dumaiss/uBITz/README.md

# uBITz
**μBITz** – *ZAP 80s dreams into silicon.*   

Open modular 8-bit style system: host Z80/6502/68k/RISC-V, tile SID/POKEY, boot in '83.   M.2 LVDS serial, I²C map, Parity-10, ZAP IRQs.   Spec + KiCad + Verilog + ref impl.   Build. ZAP. Retro lives.   `ubitz.dev` #μBITz
