dumaiss/uBITz/Engineering Diaries/μBITz Dock Digital Architecture - Done.md

# μBITz Dock Digital Architecture — Definition of Done Report

**Date:** 2024-11-27  
**Phase:** Architecture Review & Documentation (Pre-Schematic)  
**Status:** ✅ **COMPLETE — Ready for Schematic Capture**

---

## 1. Acceptance Criteria

### 1.1 Critical Issues Resolved

|Issue|Initial State|Final State|Status|
|---|---|---|---|
|**CPLD Resource Overflow**|Document specified LCMXO2-1200HC (1280 LUTs), but synthesis required 2337 LUTs (183% over)|Updated to LCMXO2-4000HC-4TG144C throughout document and BOM; utilization now 54% with comfortable margin|✅ **RESOLVED**|
|**GPIO Budget Crisis**|Initial calculation: 48-56 GPIOs needed vs 40 available on ESP32-S3 (shortfall of 8-16 pins)|Added MCP23017 GPIO expander for slow CPLD config buses; direct GPIOs reduced to ~29; budget now closes with margin|✅ **RESOLVED**|
|**USB Hub Architecture Undefined**|Section 9 was vague placeholder; unclear if hub was on Dock, GPIO requirements unknown|Full USB hub architecture documented in Section 7 (ESP32-S3 USB OTG host → GL850G 4-port hub → front panel HID)|✅ **RESOLVED**|

### 1.2 Documentation Completeness

|Section|Required Content|Delivered|Status|
|---|---|---|---|
|**4.2 CPLD**|Correct part number, synthesis utilization data|LCMXO2-4000HC specified; 2337 LUTs / 82 IOs documented|✅ **COMPLETE**|
|**4.5 GPIO Expander**|Architecture, part selection, role in config buses|MCP23017 I²C expander documented; parallel config via expander explained|✅ **COMPLETE**|
|**4.1.4 GPIO Budget**|Strategy for direct vs expander GPIOs, allocation table|Direct/expander split documented; budget analysis shows 29 direct + 13 via expander = fits|✅ **COMPLETE**|
|**Section 7 USB Hub**|Full architecture: power, enumeration, HID translation, Slot 0 integration|Complete specification with system diagram, BOM, firmware responsibilities, design checklist|✅ **COMPLETE**|
|**13.x BOM**|All subsystems with parts, quantities, notes|CPLD (§13.5), GPIO expander (§13.9), USB hub (§13.6), I²C fabric (§13.4) all updated|✅ **COMPLETE**|
|**GPIO Pin Assignments**|Provisional mapping for schematic capture|`esp32s3_gpio_assignments.md` delivered with TBD placeholders, allows routing flexibility|✅ **COMPLETE**|

### 1.3 Internal Consistency Validation

|Check|Result|Status|
|---|---|---|
|CPLD part number consistent across §4.2, §13.5, and all references|LCMXO2-4000HC-4TG144C everywhere|✅ **PASS**|
|GPIO count in §4.1.4 matches assignments in `esp32s3_gpio_assignments.md`|Direct GPIOs: 29 (Slot 0: 18, I²C: 2, UART: 4, power: 3, debug: 2); Expander: 13 bits|✅ **PASS**|
|USB hub BOM (§13.6) matches Section 7 architecture|GL850G, TVS diodes, PPTC fuse, connectors all present|✅ **PASS**|
|RTC part standardized throughout|RV-8523-C3 specified in §7.3 and §13.4|✅ **PASS**|
|No contradictions between architecture decisions and diary constraints|All 2025-11-26/27 diary decisions reflected correctly|✅ **PASS**|

---

## 2. Schematic Capture Readiness

### 2.1 Component Selection — Final Parts List

|Subsystem|Part Number|Package|Qty|Verified|
|---|---|---|---|---|
|Dock MCU|ESP32-S3-WROOM-1-N16R8|Module|1|✅|
|CPLD|LCMXO2-4000HC-4TG144C|TQFP-144|1|✅|
|GPIO Expander|MCP23017-E/SP|PDIP-28 / SOIC-28|1|✅|
|I²C Switch|TCA9548A|TSSOP-24 / VQFN-24|1|✅|
|RTC|RV-8523-C3|SOT-23-5|1|✅|
|USB Hub|GL850G / FE1.1s|SSOP-28|1|✅|
|USB-UART|FT232RL|SSOP-28|1|✅|

### 2.2 Signal Groups Defined

|Signal Group|Source|Destination|Pin Count|Routing Priority|Defined|
|---|---|---|---|---|---|
|Slot 0 Tile (data/addr/control)|ESP32-S3 direct|CPLD|18|**CRITICAL** (timing-sensitive)|✅|
|CPLD Config Bus|MCP23017|CPLD|13|Low (boot-time only)|✅|
|I²C Master|ESP32-S3|TCA9548A|2|Medium|✅|
|Service UART|ESP32-S3|FT232R|4 (TX/RX/RTS/CTS)|Medium (flow control)|✅|
|USB Host|ESP32-S3 GPIO19/20|GL850G|2 (D+/D−)|**CRITICAL** (90Ω diff pair)|✅|
|Power Control|ESP32-S3|Power sheet|3 (MAIN_ON_REQ, PG_5V, PG_3V3)|Low|✅|
|I²C Branches|TCA9548A|Host/Bank/Tiles|2×7 channels|Low|✅|

### 2.3 Design Constraints Documented

|Constraint Type|Specification|Documented|Verifiable in Schematic|
|---|---|---|---|
|**USB Differential Impedance**|90Ω ±10%, length match ±5 mils|§7.7.2 Layout Constraints|✅ (DRC rules)|
|**CPLD Power Decoupling**|0.1 µF per VCC pin, bulk caps per rail|§13.5 BOM notes|✅ (cap placement)|
|**I²C Pull-ups**|4.7 kΩ on MCU-side SCL/SDA|§13.4 I²C fabric|✅ (resistor nets)|
|**GPIO Expander Power Domain**|3V3_AON (clarified in review)|§4.5|✅ (net connection)|
|**Config Bus Timing**|MCU-controlled, no hard constraints (system in reset until ready)|§4.5 notes|✅ (no special routing)|

---

## 3. Open Items & Deferrals (Non-Blocking)

### 3.1 Intentionally Deferred to Implementation Phase

|Item|Reason for Deferral|Target Phase|
|---|---|---|
|**Exact ESP32-S3 GPIO pin numbers**|Allow KiCad routing flexibility; provisional `TBD_xx` assignments provided|PCB layout|
|**MCP23017 port bit mapping**|Can be changed in firmware if all 16 bits routed; provisional table exists|Firmware development|
|**I²C device addresses**|Designer controls all Dock-local addresses; conflicts avoided during implementation|Schematic capture|
|**BOM cost estimates**|Not architecture concern; separate pricing doc if needed|Procurement (optional)|
|**CPLD in-system I²C programming**|Wiring provided (sysCONFIG on CH0), firmware TBD|Post-prototype|
|**Bring-up test plan**|Cannot specify until hardware exists|First board bring-up|
|**Fault handling details**|Monitor protocol and error recovery deferred to firmware spec|Firmware development|

### 3.2 Known Limitations (Accepted Trade-offs)

|Limitation|Impact|Mitigation|
|---|---|---|
|**No per-port USB power control**|Cannot disable individual faulty USB ports|Shared PPTC fuse trips entire hub; HUB_RESET# forces re-enumeration|
|**Config is write-only**|Cannot readback CPLD config for verification|MCU maintains shadow copy; debug via JTAG if needed|
|**GPIO expander adds latency**|Config writes ~300-500 µs per register vs instant parallel|Boot-time only; 10 ms total acceptable|
|**Tight GPIO budget**|Only 3 spare direct GPIOs after allocations|Sufficient for v1.0; future revisions can add second expander if needed|

---

## 4. Handoff Deliverables

### 4.1 Documents Provided

|Document|Filename|Purpose|Status|
|---|---|---|---|
|**Digital Architecture**|`μbitz_dock_digital_system_architecture_2025_11_27-2.md`|Normative reference for schematic capture|✅ **FINAL**|
|**GPIO Assignments**|`esp32s3_gpio_assignments.md`|Provisional pin mapping template|✅ **PROVISIONAL**|
|**Change Report**|(in handoff context)|Summary of what changed and why|✅ **COMPLETE**|

### 4.2 Cross-References Established

|External Document|Section(s)|Relationship|Status|
|---|---|---|---|
|**DECODER_CONFIGURATION.md**|§4.5, §6|Defines config register map and MCU programming model|✅ Referenced|
|**Power Architecture**|§14.1, power rails|Defines +3V3_AON, +3V3_MAIN, +5V_MAIN, sequencing|✅ Referenced|
|**Engineering Diaries (2025-11-26/27)**|Throughout|Source of normative design decisions|✅ Validated|
|**Core Logical Specification**|§3, §5|Defines Slot 0 Tile interface, /READY, interrupts|✅ Compliant|

---

## 5. Design Review Sign-Off

### 5.1 Critical Issues — All Resolved ✅

- [x] CPLD resource overflow fixed (1200HC → 4000HC)
- [x] GPIO budget crisis resolved (GPIO expander solution)
- [x] USB hub architecture fully specified (Section 7)
- [x] Component selections finalized and consistent
- [x] BOM updated with all subsystems

### 5.2 Architecture Quality Gates — All Passed ✅

- [x] Internal consistency validated (part numbers, GPIO counts, signal groups)
- [x] Compliance with platform specifications (Core, Dock, Tile Base)
- [x] Alignment with engineering diary decisions (all 2025-11-26/27 constraints)
- [x] Schematic capture readiness (parts, signals, constraints defined)
- [x] No contradictions or ambiguities in normative sections

### 5.3 Pragmatic Engineering Checks — All Satisfied ✅

- [x] No over-engineering (features match requirements, no gold-plating)
- [x] No RTL changes required (GPIO expander preserves existing HDL)
- [x] Flexibility preserved (provisional GPIO assignments, I²C addresses TBD)
- [x] Cost-conscious (standard parts, hand-solderable packages)
- [x] Risk mitigation (CPLD headroom, GPIO margin, power sequencing simplicity)

---

## 6. Final Status

### **DEFINITION OF DONE: ✅ ACHIEVED**

**The μBITz Dock Digital System Architecture is:**

✅ **Technically complete** — All critical decisions documented, no blocking unknowns  
✅ **Internally consistent** — Parts, signals, constraints align across all sections  
✅ **Specification-compliant** — Meets Core/Dock/Tile requirements and diary constraints  
✅ **Schematic-ready** — Sufficient detail to begin KiCad hierarchical sheet capture  
✅ **Pragmatically scoped** — Defers non-critical details to appropriate phases

**Next Phase:** KiCad Schematic Capture → PCB Layout → Fabrication → Bring-Up

---

## 7. Handoff Checklist for Schematic Capture

When starting KiCad work, you have:

- [x] Complete hierarchical sheet interface definition (§14)
- [x] All major IC part numbers and packages
- [x] Signal group definitions with pin counts and priorities
- [x] Routing constraints (USB diff pair, decoupling, I²C pull-ups)
- [x] Power domain assignments (3V3_AON vs 3V3_MAIN)
- [x] Provisional GPIO assignments (refine during layout)
- [x] BOM structure with suggested parts
- [x] Cross-references to config protocol and power architecture

**You can begin drawing schematics immediately.** Any refinements (exact GPIO numbers, I²C addresses, connector choices) can be made during schematic capture and layout without invalidating the architecture.

---

**Prepared by:** Claude (AI Design Reviewer)  
**Reviewed by:** User (μBITz Platform Designer)  
**Approved for:** Schematic Capture Phase  
**Date:** 2024-11-27

---

## 8. Lessons Learned (For Future Design Reviews)

**What worked well:**

- Catching CPLD resource overflow early (before PCB fab)
- GPIO expander solution preserved existing HDL (pragmatic)
- Deferring non-critical details (pin numbers, addresses) to implementation
- User's philosophy: "document behavior, not cost" kept spec focused

**What to remember:**

- This user controls implementation details (I²C addresses, timing budgets) → don't over-specify
- "Reset is my friend" → complex sequencing not needed if MCU holds system in reset until ready
- Provisional assignments with flexibility > premature lock-in
- Write-only config is fine; don't invent features not actually needed

---

**END OF DEFINITION OF DONE REPORT**
