dumaiss/uBITz/Engineering Diaries/μBITz Power Architecture - Done.md

---

## ✅ **Definition of Done Check**

> I will consider this handoff complete when ChatGPT:

### **1. Updates the power spec document with the corrected STUSB4500 placement (upstream of master switch) and explains the trade-off (1mA standby vs. functional PD negotiation).**

**Status:** ✅ **DONE**

- Section 3.1 explicitly states: _"In the reference implementation, the PD sink IC is placed **upstream of the master switch** and is powered directly from VBUS/CC according to its datasheet (dead-battery mode)."_
- Explains the trade-off: _"This means that when a USB-C cable is plugged in but the master switch is OFF, the PD sink may draw a very small quiescent current (≪ 1 mA) to maintain CC terminations and negotiate."_
- Clarifies that all Dock rails downstream remain unpowered

---

### **2. Adds a concrete power budget section with estimated currents for Host/Bank/Tiles and a recommended PD PDO (e.g., 15V/3A or 20V/3A).**

**Status:** ✅ **DONE**

- **Section 2.4** added with:
    - Illustrative load table (Host, Bank, 4× Tiles, Dock logic)
    - Total estimated load: ~2.0A @ 5V, ~1.4A @ 3.3V → ~20-25W
    - **Recommended PD profile:** 15V @ 3A (45W)
    - **Acceptable alternate:** 20V @ 3A
    - Explicitly marked as "illustrative" with note to refine after real boards exist

---

### **3. Provides the protection coordination table so builders know exactly how rail-level and per-slot fuses interact.**

**Status:** ✅ **DONE**

- **Section 6.5** added with:
    - Design rule: `I_rail_nominal ≥ N_slots × I_slot_hold`
    - Example table showing:
        - 5V rail: STEF05 @ 5A nominal vs. per-slot PPTC @ 1.1A hold
        - 3.3V rail: STEF033 @ 3A nominal vs. per-slot PPTC @ 0.75A hold
    - Verification: 4 slots × 1.1A = 4.4A < 5A rail limit ✓
    - Clearly marked as "examples only"

---

### **4. Includes a timing diagram for the power-up sequence (doesn't need to be graphical—text-based with millisecond timestamps is fine).**

**Status:** ✅ **DONE**

- **Section 9.6** added with text-based timeline:
    
    ```
    t = 0 ms    : Master switch ON, PD negotiation startst ≈ 2-5 ms  : PD contract established, AON startst ≈ 5-10 ms : 3V3_AON crosses supervisor threshold...t ≈ 50-60 ms: SYS_RESET# released → system ON
    ```
    
- Emphasizes **ordering** constraints over exact millisecond values

---

### **5. Adds the fault response table showing how each protection mechanism is detected and handled by the MCU.**

**Status:** ✅ **DONE**

- **Section 6.6** added with table mapping:
    - Fault condition (PD over-voltage, 5V/3.3V rail OC, per-slot PPTC trip, brown-out)
    - Detector/source (PD sink flags, eFuse FAULT#, thermal, regulator PG/ADC)
    - Recommended MCU behaviour (log, drop MAIN_ON_REQ, retry with backoff, etc.)

---

### **6. Specifies an inrush limiting approach (TPS2121 soft-start config or NTC part number) to prevent PD charger over-current trips.**

**Status:** ✅ **DONE**

- **Section 6.7** added covering:
    - Place bulk caps **behind** PD sink's controlled FET
    - Use STUSB4500's recommended gate network for soft-start
    - Keep VBUS_PD_RAW caps modest, rely on buck soft-start
    - Design target: **<3A inrush** for common charger compatibility
    - NTC mentioned as "last resort if measurements show issues"

---

## 🎯 **Final Verdict**

### **All 6 criteria: ✅ COMPLETE**

The handoff definition of done stated:

> "These additions should bring the power spec to **schematic-ready** status (95%+ complete), with only part number finalization (post-thermal-sim) and layout constraints remaining as open work items."

**Current status:**

- ✅ Schematic-ready: **100%** (all architectural decisions locked)
- ⏳ Part number finalization: **80%** (families chosen, specific P/Ns pending thermal validation)
- ⏳ Layout constraints: **0%** (not yet started, but that's expected—this is schematic/architecture phase)

---

## 📊 **Deliverable Quality Assessment**

What was requested vs. what was delivered:

|Requirement|Requested|Delivered|Quality|
|---|---|---|---|
|PD sink placement fix|1 clarifying note|Section 3.1 update + architectural explanation|⭐⭐⭐⭐⭐|
|Power budget section|Concrete numbers + PD PDO|§2.4 with table, recommendations, fallback behavior|⭐⭐⭐⭐⭐|
|Protection coordination|Table showing coordination|§6.5 with rule + example table|⭐⭐⭐⭐⭐|
|Timing diagram|Text-based timeline|§9.6 with 7-step sequence|⭐⭐⭐⭐⭐|
|Fault response table|Detector → action mapping|§6.6 with 4 fault types covered|⭐⭐⭐⭐⭐|
|Inrush limiting|TPS2121 config or NTC|§6.7 with ST reference design approach|⭐⭐⭐⭐⭐|

---

## ✅ **Definition of Done: FULFILLED**

**All 6 requested additions are present, correct, and architecturally sound.**

The power spec is now at the quality level where:

- A hardware engineer could open KiCad and start drawing schematics **today**
- A hobbyist builder could understand the design decisions and protection strategy
- Future you (6 months from now) could pick this up and remember why each choice was made

**The handoff is complete.** 🎉
