dumaiss/uBITz/uBITz Platform Code/Dock/HDL/src/ice40Pinout-tq144.csv

Pin Function | Pin Type | Bank | (TQ144) 144-Pin TQFP Pin Number
IOL_2A | DPIO | 3 | 1
IOL_2B | DPIO | 3 | 2
IOL_3A | DPIO | 3 | 3
IOL_3B | DPIO | 3 | 4
GND | GND | GND | 5
VCCIO_3 | VCCIO | VCCIO | 6
IOL_4A | DPIO | 3 | 7
IOL_4B | DPIO | 3 | 8
IOL_5A | DPIO | 3 | 9
IOL_5B | DPIO | 3 | 10
IOL_8A | DPIO | 3 | 11
IOL_8B | DPIO | 3 | 12
IOL_9A | DPIO | 3 | -
IOL_9B | DPIO | 3 | -
GND | GND | GND | 13
GND | GND | GND | 14
IOL_10A | DPIO | 3 | 15
IOL_10B | DPIO | 3 | 16
IOL_12A | DPIO | 3 | 17
IOL_12B | DPIO | 3 | 18
IOL_13A | DPIO | 3 | 19
IOL_13B_GBIN7 | GBIN | 3 | 20
IOL_14A_GBIN6 | GBIN | 3 | 21
IOL_14B | DPIO | 3 | 22
IOL_17A | DPIO | 3 | 23
IOL_17B | DPIO | 3 | 24
IOL_18A | DPIO | 3 | 25
IOL_18B | DPIO | 3 | 26
VCC | VCC | VCC | 27
IOL_23A | DPIO | 3 | 28
IOL_23B | DPIO | 3 | 29
VCCIO_3 | VCCIO | VCCIO | 30
IOL_24A | DPIO | 3 | 31
IOL_24B | DPIO | 3 | 32
IOL_25A | DPIO | 3 | 33
IOL_25B | DPIO | 3 | 34
IOB_56 | PIO | 2 | 37
IOB_57 | PIO | 2 | 38
IOB_59 | PIO | 2 | -
IOB_61 | PIO | 2 | 39
VCC | VCC | VCC | 40
IOB_63 | PIO | 2 | 41
IOB_64 | PIO | 2 | 42
IOB_71 | PIO | 2 | 43
IOB_72 | PIO | 2 | 44
IOB_73 | PIO | 2 | 45
IOB_74 | PIO | 2 | -
IOB_77 | PIO | 2 | -
IOB_78 | PIO | 2 | -
VCCIO_2 | VCCIO | VCCIO | 46
IOB_79 | PIO | 2 | 47
IOB_80 | PIO | 2 | 48
IOB_81_GBIN5 | GBIN | 2 | 49
IOB_82_GBIN4 | GBIN | 2 | 52
GNDPLL0 | GNDPLL | GNDPLL | 53
VCCPLL0 | VCCPLL | VCCPLL | 54
IOB_87 | PIO | 2 | -
IOB_89 | PIO | 2 | -
IOB_91 | PIO | 2 | 55
IOB_94 | PIO | 2 | 56
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
IOT_225 | PIO | 0 | -
VCC | VCC | VCC | -
NC | NC | NC | 35
NC | NC | NC | 36
NC | NC | NC | 50
NC | NC | NC | 51
NC | NC | NC | 58
NC | NC | NC | 133
GND | GND | GND | -
GND | GND | GND | -
GND | GND | GND | -
GND | GND | GND | -
VCCIO_3 | VCCIO | VCCIO | -
IOB_86 | PIO | 2 | -
