dumaiss/uBITz/uBITz Platform Code/Dock/HDL/src/ice40Pinout.csv

Ball Function | Pin Type | Bank | (BG121) 121-Ball caBGA Ball Number | (CB132) 132-Ball csBGA Ball Number | (CM225) 225-Ball ucBGA Ball Number | (CT256) 256-Ball caBGA Ball Number
IOL_1A | DPIO | 3 | - | - | C2 | E4
IOL_1B | DPIO | 3 | - | - | B1 | B2
IOL_2A | DPIO | 3 | B1 | B1 | E4 | F5
IOL_2B | DPIO | 3 | B2 | C1 | D4 | B1
IOL_3A | DPIO | 3 | - | - | E3 | C1
IOL_3B | DPIO | 3 | - | - | C1 | C2
IOL_4A | DPIO | 3 | C4 | C3 | E5 | F4
IOL_4B | DPIO | 3 | C3 | D3 | D3 | D2
IOL_5A | DPIO | 3 | C2 | D1 | E6 | G5
IOL_5B | DPIO | 3 | C1 | E1 | D1 | D1
IOL_6A | DPIO | 3 | - | - | D2 | G4
IOL_6B | DPIO | 3 | - | - | E2 | E3
IOL_7A | DPIO | 3 | - | - | - | H5
IOL_7B | DPIO | 3 | - | - | - | E2
IOL_8A | DPIO | 3 | E1 | D4 | F5 | G3
IOL_8B | DPIO | 3 | D1 | E4 | F4 | F3
IOL_9A | DPIO | 3 | D2 | F4 | F3 | H3
IOL_9B | DPIO | 3 | D3 | F3 | F2 | F2
IOL_10A | DPIO | 3 | E2 | H4 | G2 | H6
IOL_10B | DPIO | 3 | E3 | G4 | F1 | F1
IOL_11A | DPIO | 3 | - | - | G3 | H4
IOL_11B | DPIO | 3 | - | - | G1 | G2
IOL_12A | DPIO | 3 | F1 | J3 | G5 | J4
IOL_12B | DPIO | 3 | F2 | J1 | H2 | H2
IOL_13A | DPIO | 3 | F4 | G3 | H6 | J5
IOL_13B_GBIN7 | GBIN | 3 | F3 | G1 | G4 | G1
IOL_14A_GBIN6 | GBIN | 3 | G1 | H1 | H5 | J3
IOL_14B | DPIO | 3 | G2 | H3 | H1 | H1
IOL_15A | DPIO | 3 | - | - | H3 | J2
IOL_15B | DPIO | 3 | - | - | J3 | J1
IOL_16A | DPIO | 3 | - | - | H4 | K1
IOL_16B | DPIO | 3 | - | - | J1 | K3
IOL_17A | DPIO | 3 | G3 | - | J5 | L4
IOL_17B | DPIO | 3 | H3 | - | J2 | L1
IOL_18A | DPIO | 3 | H1 | K3 | J4 | K4
IOL_18B | DPIO | 3 | H2 | K4 | K1 | M1
IOL_19A | DPIO | 3 | - | - | - | L6
IOL_19B | DPIO | 3 | - | - | - | L3
IOL_20A | DPIO | 3 | - | - | K3 | K5
IOL_20B | DPIO | 3 | - | - | L1 | M2
IOL_21A | DPIO | 3 | - | - | - | L7
IOL_21B | DPIO | 3 | - | - | - | N2
IOL_22A | DPIO | 3 | - | - | L3 | M6
IOL_22B | DPIO | 3 | - | - | M1 | M3
IOL_23A | DPIO | 3 | J1 | L1 | K5 | L5
IOL_23B | DPIO | 3 | K1 | M1 | M2 | N3
IOL_24A | DPIO | 3 | - | - | N2 | P1
IOL_24B | DPIO | 3 | - | - | M3 | M4
IOL_25A | DPIO | 3 | K2 | N1 | P1 | P2
IOL_25B | DPIO | 3 | J2 | P1 | K4 | M5
IOL_26A | DPIO | 3 | - | - | M4 | R1
IOL_26B | DPIO | 3 | - | - | L4 | N4
IOB_52 | PIO | 2 | - | - | N3 | N6
IOB_53 | PIO | 2 | - | - | P2 | T1
IOB_54 | PIO | 2 | - | - | N4 | P4
IOB_55 | PIO | 2 | - | - | R1 | R2
IOB_56 | PIO | 2 | L1 | P2 | L5 | N5
IOB_57 | PIO | 2 | J3 | - | R2 | T2
IOB_58 | PIO | 2 | - | - | - | P5
IOB_59 | PIO | 2 | - | P3 | - | R3
IOB_60 | PIO | 2 | - | - | M5 | R5
IOB_61 | PIO | 2 | L2 | - | R3 | T3
IOB_62 | PIO | 2 | - | - | L6 | -
IOB_63 | PIO | 2 | K3 | M4 | P4 | R4
IOB_64 | PIO | 2 | J4 | M3 | M6 | M7
IOB_65 | PIO | 2 | - | - | R4 | -
IOB_66 | PIO | 2 | - | - | - | N7
IOB_67 | PIO | 2 | - | - | N5 | P6
IOB_68 | PIO | 2 | - | - | - | M8
IOB_69 | PIO | 2 | - | - | P5 | T5
IOB_71 | PIO | 2 | L3 | L5 | R5 | R6
IOB_72 | PIO | 2 | L4 | L4 | L7 | P8
IOB_73 | PIO | 2 | K4 | P4 | N6 | T6
IOB_74 | PIO | 2 | - | P5 | - | L9
IOB_75 | PIO | 2 | - | - | M7 | T7
IOB_76 | PIO | 2 | - | - | - | T8
IOB_77 | PIO | 2 | - | M6 | P6 | P7
IOB_78 | PIO | 2 | J5 | L6 | M8 | N9
IOB_79 | PIO | 2 | K5 | M7 | R6 | T9
IOB_80 | PIO | 2 | - | - | - | M9
IOB_81_GBIN5 | GBIN | 2 | L5 | P7 | N7 | R9
IOB_82_GBIN4 | GBIN | 2 | K6 | P8 | L9 | K9
IOB_83 | PIO | 2 | - | - | P7 | P9
GNDPLL0 | GNDPLL | GNDPLL | L6 | L7 | N8 | N8
VCCPLL0 | VCCPLL | VCCPLL | J6 | M8 | L8 | L8
IOB_84 | PIO | 2 | - | - | P8 | R10
IOB_85 | PIO | 2 | - | - | M9 | L10
IOB_86 | PIO | 2 | J7 | - | N9 | P10
IOB_87 | PIO | 2 | H7 | L8 | K9 | N10
IOB_88 | PIO | 2 | - | - | R9 | T10
IOB_89 | PIO | 2 | K7 | P9 | L10 | T11
IOB_90 | PIO | 2 | - | - | P9 | -
IOB_91 | PIO | 2 | J8 | M9 | N10 | T15
IOB_92 | PIO | 2 | - | - | P10 | T14
IOB_93 | PIO | 2 | - | - | - | M11
IOB_94 | PIO | 2 | L7 | - | R10 | T13
IOB_96 | PIO | 2 | - | - | P11 | -
IOB_98 | PIO | 2 | - | - | R11 | N12
IOB_99 | PIO | 2 | - | - | - | L11
IOB_100 | PIO | 2 | - | - | P13 | T16
IOB_101 | PIO | 2 | - | - | - | M12
IOB_102 | PIO | 2 | - | - | R12 | R16
IOB_103_CBSEL0 | PIO | 2 | L8 | L9 | K11 | K11
IOB_104_CBSEL1 | PIO | 2 | H9 | P10 | P12 | P13
CDONE | CONFIG | 2 | K8 | M10 | M10 | M10
CRESET_B | CONFIG | 2 | L9 | L10 | N11 | N11
IOB_105_SDO | SPI | SPI | K9 | M11 | M11 | P12
IOB_106_SDI | SPI | SPI | J9 | P11 | L11 | P11
IOB_107_SCK | SPI | SPI | L10 | P12 | N12 | R11
IOB_108_SS | SPI | SPI | K10 | P13 | M12 | R12
VCC_SPI | SPI | SPI | L11 | L11 | N13 | N13
IOR_109 | PIO | 1 | - | M12 | R15 | R14
IOR_110 | PIO | 1 | - | P14 | P15 | R15
IOR_111 | PIO | 1 | - | L12 | R14 | P14
IOR_112 | PIO | 1 | - | N14 | P14 | P15
NC | NC | NC | - | M14 | N14 | N14
IOR_113 | PIO | 1 | - | - | M15 | P16
IOR_114 | PIO | 1 | J11 | L14 | L12 | M13
IOR_115 | PIO | 1 | K11 | K12 | M13 | M14
IOR_116 | PIO | 1 | H10 | K11 | K12 | L12
IOR_117 | PIO | 1 | J10 | K14 | K13 | N16
IOR_118 | PIO | 1 | G8 | J12 | J10 | L13
IOR_119 | PIO | 1 | H11 | J11 | L13 | L14
IOR_120 | PIO | 1 | G10 | H12 | J12 | K12
IOR_121 | PIO | 1 | - | - | L14 | M16
IOR_122 | PIO | 1 | - | - | - | J10
IOR_123 | PIO | 1 | - | - | M14 | M15
IOR_125 | PIO | 1 | - | - | K15 | -
IOR_126 | PIO | 1 | - | - | - | J11
IOR_127 | PIO | 1 | - | - | - | L16
IOR_128 | PIO | 1 | G9 | H11 | J11 | K13
IOR_129 | PIO | 1 | G11 | G12 | J13 | K14
IOR_130 | PIO | 1 | - | - | - | J15
IOR_131 | PIO | 1 | - | - | K14 | K15
IOR_133 | PIO | 1 | - | - | J15 | K16
IOR_134 | PIO | 1 | - | - | - | J14
IOR_135 | PIO | 1 | - | - | J14 | -
IOR_136 | PIO | 1 | F10 | G11 | H11 | J12
IOR_137 | PIO | 1 | F9 | F12 | H14 | J13
IOR_138 | PIO | 1 | - | - | H13 | J16
IOR_139 | PIO | 1 | - | - | - | H13
IOR_140_GBIN3 | GBIN | 1 | F11 | F14 | H12 | H11
IOR_141_GBIN2 | GBIN | 1 | E10 | G14 | G13 | H16
IOR_142 | PIO | 1 | - | - | - | H14
IOR_143 | PIO | 1 | - | - | G15 | G16
IOR_144 | PIO | 1 | E9 | F11 | G11 | H12
IOR_145 | PIO | 1 | - | - | G14 | G15
IOR_146 | PIO | 1 | E8 | E11 | G10 | G10
IOR_147 | PIO | 1 | D9 | E12 | F14 | F16
IOR_148 | PIO | 1 | E11 | E14 | G12 | G11
IOR_149 | PIO | 1 | - | - | F15 | F15
IOR_150 | PIO | 1 | - | - | - | G14
IOR_151 | PIO | 1 | - | - | F13 | E16
IOR_152 | PIO | 1 | D11 | D14 | F12 | G13
IOR_153 | PIO | 1 | - | - | E14 | D16
IOR_154 | PIO | 1 | D10 | C14 | F11 | G12
IOR_155 | PIO | 1 | - | - | D14 | F14
IOR_156 | PIO | 1 | - | - | - | F12
IOR_157 | PIO | 1 | - | - | - | D15
IOR_158 | PIO | 1 | - | - | - | F11
IOR_159 | PIO | 1 | - | - | D15 | -
IOR_160 | PIO | 1 | C11 | D12 | D13 | E14
IOR_161 | PIO | 1 | B11 | B14 | E13 | C16
IOR_162 | PIO | 1 | - | - | - | F13
IOR_165 | PIO | 1 | - | - | C14 | B16
IOR_166 | PIO | 1 | - | - | - | E13
IOR_167 | PIO | 1 | - | - | B15 | D14
VPP_2V5 | VPP | VPP | C10 | A14 | E12 | E12
VPP_FAST | VPP | VPP | B10 | A13 | D12 | D12
IOT_168 | PIO | 0 | A11 | - | B14 | C14
IOT_169 | PIO | 0 | - | - | A15 | B15
IOT_170 | PIO | 0 | A10 | A12 | C12 | D13
IOT_171 | PIO | 0 | - | - | C13 | B14
IOT_172 | PIO | 0 | C9 | C12 | E11 | C12
IOT_173 | PIO | 0 | - | - | - | E11
IOT_174 | PIO | 0 | B9 | C11 | D11 | C13
IOT_176 | PIO | 0 | - | - | B13 | A16
IOT_177 | PIO | 0 | B8 | D10 | E10 | A15
IOT_178 | PIO | 0 | A9 | D11 | D9 | B13
IOT_179 | PIO | 0 | C8 | A11 | E9 | E10
IOT_180 | PIO | 0 | - | - | B12 | C11
IOT_181 | PIO | 0 | D7 | A10 | D10 | D11
IOT_182 | PIO | 0 | - | - | C11 | B12
IOT_183 | PIO | 0 | - | - | - | B10
IOT_184 | PIO | 0 | - | - | A11 | B11
IOT_185 | PIO | 0 | - | - | B11 | C10
IOT_186 | PIO | 0 | - | C10 | - | A10
IOT_187 | PIO | 0 | - | - | B10 | A11
IOT_188 | PIO | 0 | - | D9 | - | -
IOT_189 | PIO | 0 | - | - | A10 | -
IOT_190 | PIO | 0 | A8 | C9 | F9 | D10
IOT_191 | PIO | 0 | C7 | - | C10 | C9
IOT_192 | PIO | 0 | A7 | - | B8 | E9
IOT_193 | PIO | 0 | - | - | C8 | D9
IOT_194 | PIO | 0 | - | - | A9 | A9
IOT_195 | PIO | 0 | - | - | B9 | -
VCCPLL1 | VCCPLL | VCCPLL | C6 | C8 | E8 | E8
GNDPLL1 | GNDPLL | GNDPLL | C5 | D8 | E7 | E7
IOT_196 | PIO | 0 | - | - | A8 | F9
IOT_197_GBIN1 | GBIN | 0 | B7 | A7 | C9 | C8
IOT_198_GBIN0 | GBIN | 0 | B6 | A6 | D8 | F7
IOT_199 | PIO | 0 | - | - | - | B9
IOT_200 | PIO | 0 | - | C7 | - | D8
IOT_201 | PIO | 0 | - | - | B7 | -
IOT_202 | PIO | 0 | - | D7 | - | -
IOT_203 | PIO | 0 | - | - | C6 | B8
IOT_205 | PIO | 0 | - | - | A7 | A7
IOT_206 | PIO | 0 | A6 | C6 | C7 | C7
IOT_207 | PIO | 0 | A5 | D6 | A6 | B7
IOT_208 | PIO | 0 | B5 | A5 | D7 | B6
IOT_209 | PIO | 0 | - | - | B6 | C6
IOT_210 | PIO | 0 | - | - | - | D7
IOT_211 | PIO | 0 | A4 | D5 | D6 | A6
IOT_212 | PIO | 0 | D5 | C5 | F7 | D6
IOT_213 | PIO | 0 | - | - | - | A5
IOT_214 | PIO | 0 | - | - | B5 | B5
IOT_215 | PIO | 0 | - | - | - | E6
IOT_216 | PIO | 0 | - | - | A5 | B4
GND | GND | GND | - | A9 | A12 | A12
IOT_218 | PIO | 0 | - | - | B4 | A2
GND | GND | GND | - | F1 | A4 | A4
IOT_219 | PIO | 0 | B4 | A4 | C5 | D5
IOT_220 | PIO | 0 | - | - | B3 | A1
GND | GND | GND | - | F7 | E15 | E15
IOT_221 | PIO | 0 | B3 | C4 | D5 | C5
GND | GND | GND | E5 | G7 | G7 | G7
IOT_222 | PIO | 0 | A2 | A3 | A2 | C4
GND | GND | GND | E6 | G8 | G8 | G8
IOT_223 | PIO | 0 | A3 | A2 | C4 | B3
GND | GND | GND | E7 | G9 | G9 | G9
GND | GND | GND | F5 | H6 | H7 | H7
GND | GND | GND | F6 | H7 | H8 | H8
IOT_224 | PIO | 0 | - | - | B2 | D4
GND | GND | GND | F7 | H8 | H9 | H9
IOT_225 | PIO | 0 | A1 | A1 | C3 | E5
GND | GND | GND | G5 | J14 | J7 | J7
IOT_226 | PIO | 0 | - | - | A1 | D3
GND | GND | GND | G6 | J8 | J8 | J8
IOT_227 | PIO | 0 | - | - | - | C3
GND | GND | GND | G7 | L3 | J9 | J9
GND | GND | GND | - | P6 | K2 | K2
GND | GND | GND | H5 | - | K7 | K7
GND | GND | GND | - | - | L15 | L15
GND | GND | GND | - | - | R7 | R7
GND | GND | GND | - | - | - | T12
GND | GND | GND | - | - | - | T4
VCC | VCC | VCC | - | F8 | A14 | A14
VCC | VCC | VCC | D8 | G6 | F10 | F10
VCC | VCC | VCC | D4 | H9 | F6 | F6
VCC | VCC | VCC | - | J4 | H15 | K10
VCC | VCC | VCC | H8 | J7 | K10 | K6
VCC | VCC | VCC | H4 | - | K6 | L2
VCC | VCC | VCC | - | - | L2 | -
VCC | VCC | VCC | - | - | R8 | -
VCCIO_0 | VCCIO | VCCIO | - | A8 | A13 | A13
VCCIO_0 | VCCIO | VCCIO | - | F6 | A3 | A3
VCCIO_0 | VCCIO | VCCIO | D6 | - | F8 | A8
VCCIO_0 | VCCIO | VCCIO | - | - | - | F8
VCCIO_1 | VCCIO | VCCIO | - | F9 | C15 | C15
VCCIO_1 | VCCIO | VCCIO | F8 | H14 | H10 | H10
VCCIO_1 | VCCIO | VCCIO | - | - | N15 | H15
VCCIO_1 | VCCIO | VCCIO | - | - | - | N15
VCCIO_2 | VCCIO | VCCIO | H6 | J9 | K8 | K8
VCCIO_2 | VCCIO | VCCIO | - | M5 | P3 | P3
VCCIO_2 | VCCIO | VCCIO | - | - | R13 | R13
VCCIO_2 | VCCIO | VCCIO | - | - | - | R8
VCCIO_3 | VCCIO | VCCIO | - | E3 | E1 | E1
VCCIO_3 | VCCIO | VCCIO | E4 | J6 | G6 | G6
VCCIO_3 | VCCIO | VCCIO | G4 | K1 | J6 | J6
VCCIO_3 | VCCIO | VCCIO | - | - | N1 | N1
