dumaiss/uBITz/TRADEMARKS.md

# μBITz / microBITz Trademarks Policy

**Short version:** The names **“μBITz”**, **“microBITz”**, **“uBITz”** and the μBITz logos are trademarks of Sebastien Dumais.  
You may say **“Compatible with μBITz”** if your product follows the public specs.  
Don’t use our names/logos as your product or company name, and don’t alter the logos.

---

## 1) Marks covered
- Word marks: **μBITz**, **microBITz**, **uBITz**
- Logos/wordmarks: the **μBITz** pixel logo, the **microBITz** logotype, and any official “Compatible with μBITz” badges

## 2) Ownership
The μBITz marks are trademarks of Sebastien dUmais. Use of our software/hardware under the **Solderpad Hardware License v2.1 (SPDX: SHL-2.1)** does **not** grant trademark rights.

## 3) Acceptable use (you may)
- **Nominative use:** Refer to our project in text (“This board is compatible with μBITz.”) when it’s necessary and truthful.
- **Compatibility claims:** State **“Compatible with μBITz”** if you comply with the **μBITz Specification** (electrical, mechanical, and protocol requirements).
- **Badges:** Use our official, unmodified **“Compatible with μBITz”** badge to indicate compatibility.

## 4) Unacceptable use (you may not)
- Use **μBITz / microBITz / uBITz** (or confusingly similar spellings) **as your product, brand, or company name.**
- Alter, recolor, stretch, or embed our logos inside your own logos.
- Imply endorsement, certification, or partnership **unless we’ve granted it in writing.**
- Use the marks on incompatible products, or in a misleading way.

## 5) Logo usage rules (when allowed)
- **Do not modify** the logo (no recolors/warping/shadows).
- **Clear space:** at least the height of the letter **“B”** around all sides.
- **Minimum sizes:**  
  - Print: 10 mm width (μ or z still legible).  
  - Screen: 96 px width minimum.
- **Backgrounds:** Prefer **#1A1A1A** (PCB Black) or white. Maintain sufficient contrast.
- **Colors (reference):**  
  - CRT Amber **#FFB000** (μ, accents)  
  - Light Gray **#D9D9D9** (BIT logotype)  
  - ZX Rainbow accent (in order): **#FF0000, #FF7F00, #FFFF00, #00FF00, #00FFFF, #0000FF, #8B00FF**

## 6) “Compatible with μBITz” badge
You may use the badge if:
- Your product passes the **μBITz Specification** for the relevant profile (Serial/Parallel/Minimal) and does **not** damage or misconfigure host systems.
- You provide a link to your public documentation or test evidence on request.

**Badge text:** `Compatible with μBITz`  
**Attribution (recommended small print):** `μBITz is a trademark of Sebastien Dumais. Used with permission.`

### Optional SVG badge (you can copy as `branding/badges/compatible-ubitz.svg`)
```svg
<svg xmlns="http://www.w3.org/2000/svg" width="286" height="28" role="img" aria-label="Compatible with μBITz">
  <linearGradient id="g" x1="0" x2="1">
    <stop offset="0%" stop-color="#FF0000"/><stop offset="16.6%" stop-color="#FF7F00"/>
    <stop offset="33.3%" stop-color="#FFFF00"/><stop offset="50%" stop-color="#00FF00"/>
    <stop offset="66.6%" stop-color="#00FFFF"/><stop offset="83.3%" stop-color="#0000FF"/>
    <stop offset="100%" stop-color="#8B00FF"/>
  </linearGradient>
  <rect rx="4" width="286" height="28" fill="#1A1A1A"/>
  <text x="10" y="19" font-family="monospace" font-size="12" fill="#D9D9D9">Compatible with</text>
  <rect x="150" y="5" width="126" height="18" rx="3" fill="url(#g)"/>
  <text x="156" y="19" font-family="monospace" font-size="12" fill="#000">μBITz</text>
</svg>
