dumaiss/uBITz/uBITz Platform Code/Bank/Schem/uBITz-Bank-Reference-Impl/02-Libraries/Footprints/DB0020A.stp

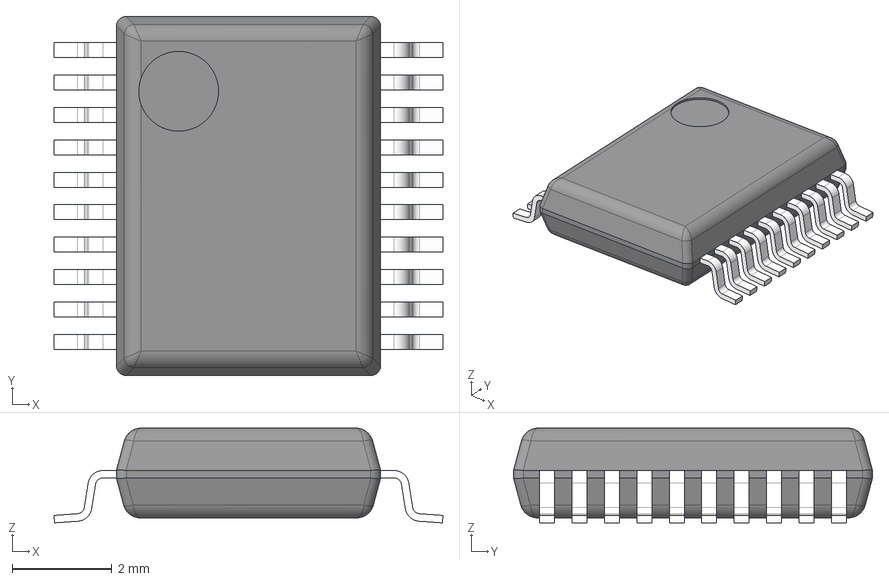
[picture p1: CAD file, 2026-01-09]
uBITz Platform Code/Bank/Schem/uBITz-Bank-Reference-Impl/02-Libraries/Footprints/DB0020A.stp
7.80 x 7.20 x 1.90 mm
BODY-SSOP
LEAD-SSOP x 20
PIN1
