dumaiss/uBITz/uBITz Platform Code/Bank/Schem/uBITz-Bank-Reference-Impl/02-Libraries/Footprints/Game Boy Game Cart.STEP

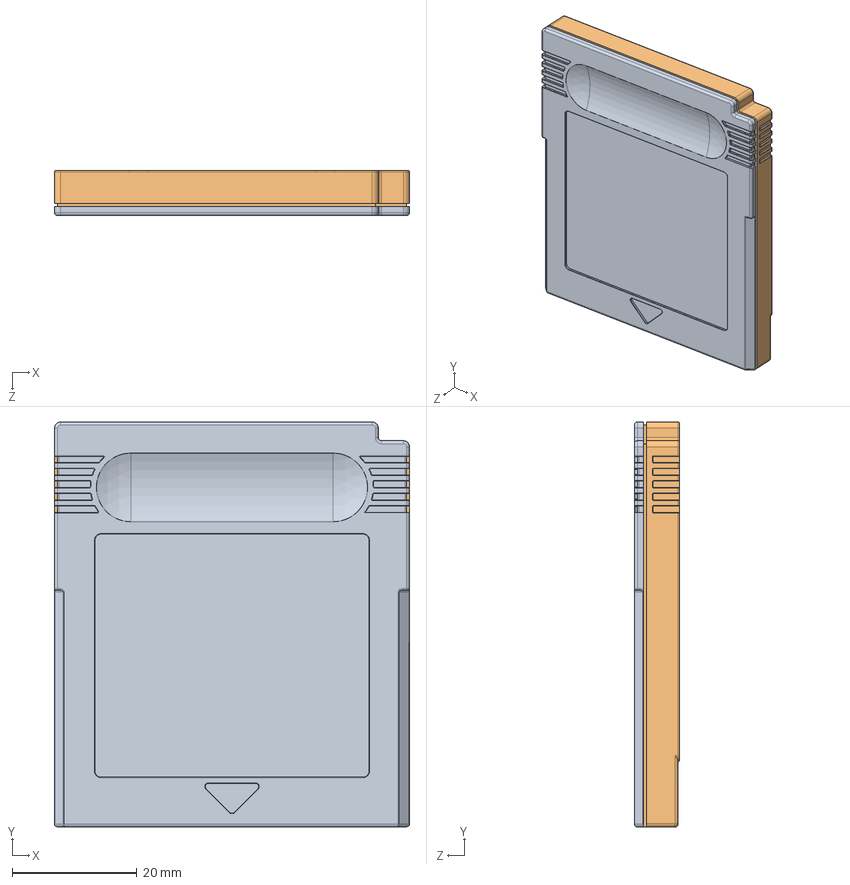
[picture p2: CAD file, 2026-01-09]
uBITz Platform Code/Bank/Schem/uBITz-Bank-Reference-Impl/02-Libraries/Footprints/Game Boy Game Cart.STEP
57.0 x 65.0 x 7.30 mm
