dumaiss/uBITz/uBITz Platform Code/Dock/Schem/uBITz-Dock-Reference-Impl/02-Libraries/Footprints/TPS2121RUXR.step

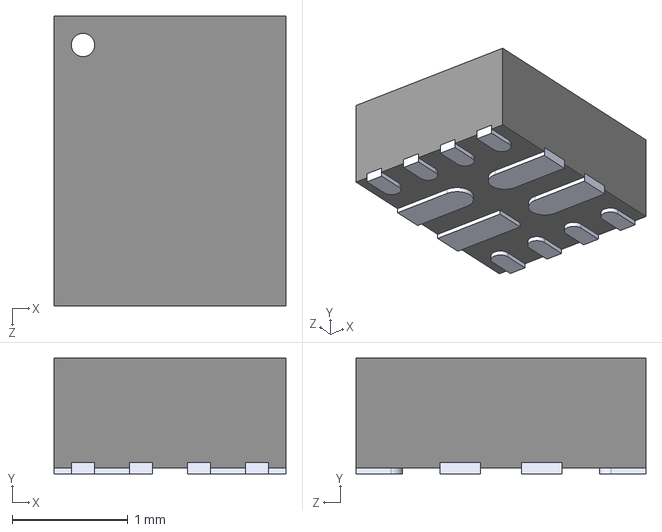
[picture p3: CAD file, 2025-12-24]
uBITz Platform Code/Dock/Schem/uBITz-Dock-Reference-Impl/02-Libraries/Footprints/TPS2121RUXR.step
2.00 x 1.00 x 2.50 mm
