dumaiss/uBITz/uBITz Platform Code/Bank/Schem/uBITz-Bank-Reference-Impl/02-Libraries/Footprints/AT28C256-15PU.step

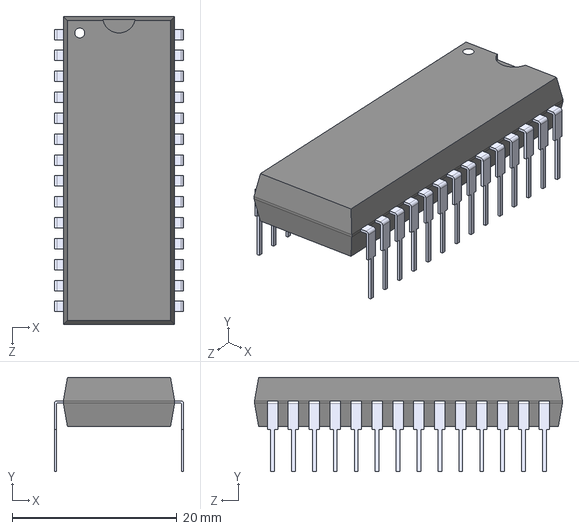
[picture p4: CAD file, 2026-01-09]
uBITz Platform Code/Bank/Schem/uBITz-Bank-Reference-Impl/02-Libraries/Footprints/AT28C256-15PU.step
15.7 x 11.4 x 37.4 mm
