dumaiss/uBITz/uBITz Platform Code/Dock/Schem/uBITz-Dock-Reference-Impl/02-Libraries/Footprints/STUSB4500QTR.step

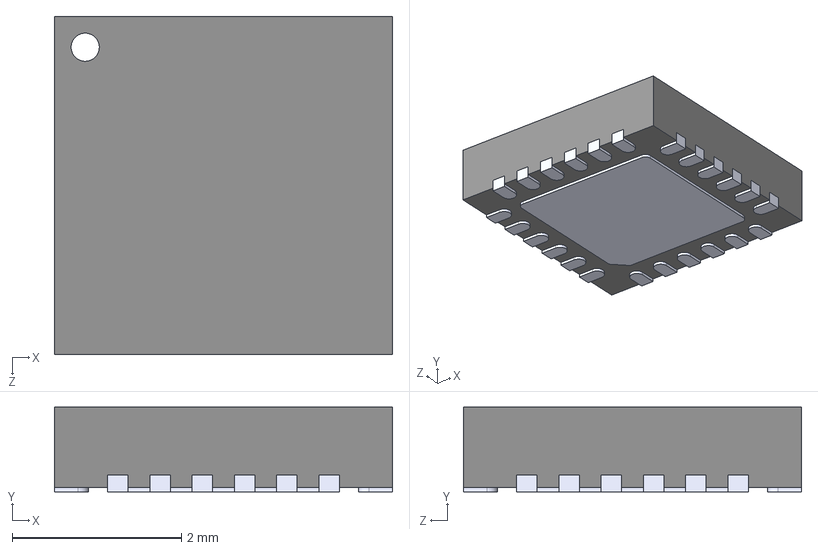
[picture p5: CAD file, 2025-12-24]
uBITz Platform Code/Dock/Schem/uBITz-Dock-Reference-Impl/02-Libraries/Footprints/STUSB4500QTR.step
4.00 x 1.00 x 4.00 mm
