dumaiss/uBITz/uBITz Platform Code/Bank/Schem/uBITz-Bank-Reference-Impl/02-Libraries/Footprints/TSOP-48_TS048_SPA.step

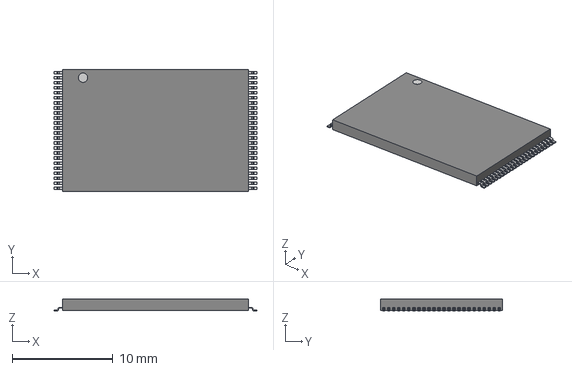
[picture p6: CAD file, 2026-01-09]
uBITz Platform Code/Bank/Schem/uBITz-Bank-Reference-Impl/02-Libraries/Footprints/TSOP-48_TS048_SPA.step
20.2 x 12.1 x 1.20 mm
