dumaiss/uBITz/uBITz Platform Code/Dock/Schem/uBITz-Dock-Reference-Impl/02-Libraries/Footprints/STL6P3LLH6.step

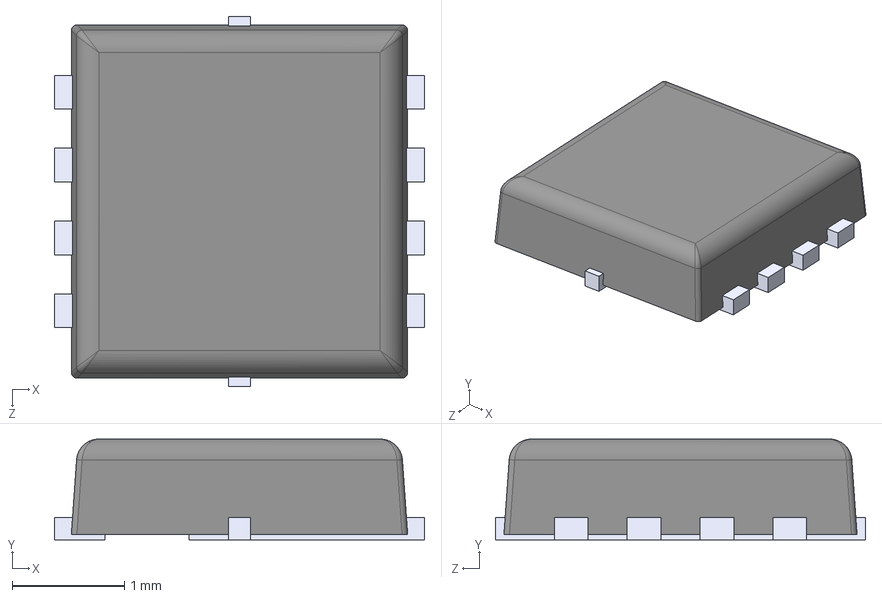
[picture p7: CAD file, 2025-12-24]
uBITz Platform Code/Dock/Schem/uBITz-Dock-Reference-Impl/02-Libraries/Footprints/STL6P3LLH6.step
3.30 x 0.9 x 3.30 mm
