dumaiss/uBITz/uBITz Platform Code/Bank/Schem/uBITz-Bank-Reference-Impl/02-Libraries/Footprints/SN74LVC2G126DCUR.step

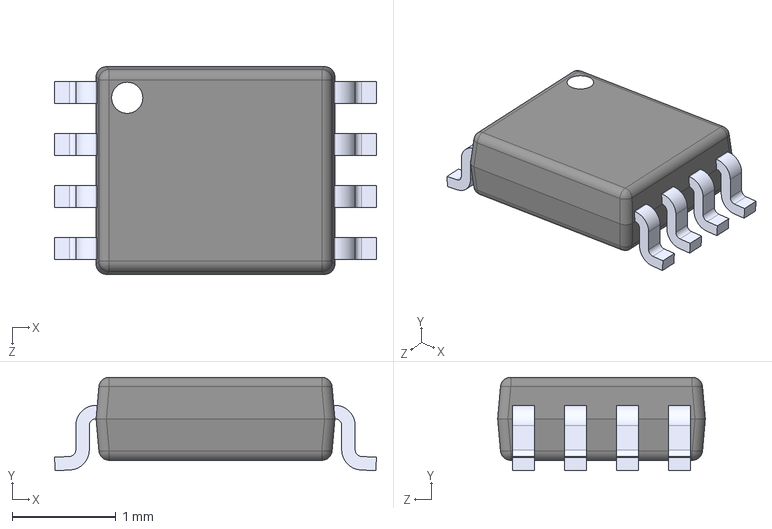
[picture p8: CAD file, 2026-01-03]
uBITz Platform Code/Bank/Schem/uBITz-Bank-Reference-Impl/02-Libraries/Footprints/SN74LVC2G126DCUR.step
3.10 x 0.9 x 2.00 mm
