dumaiss/uBITz/uBITz Platform Code/Bank/Schem/uBITz-Bank-Reference-Impl/02-Libraries/Footprints/FT232HL-REEL.step

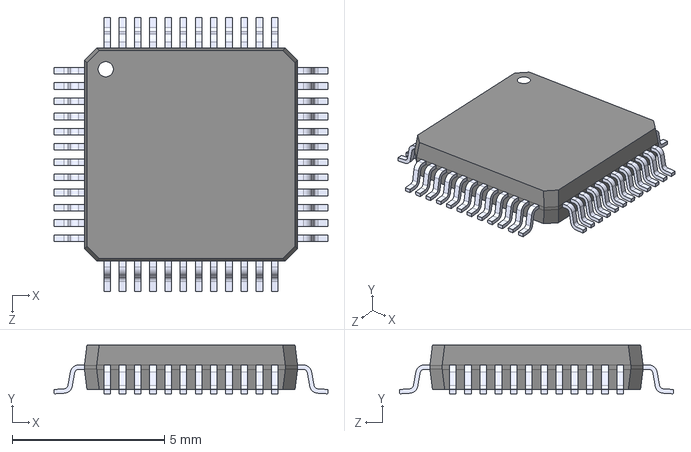
[picture p9: CAD file, 2026-01-03]
uBITz Platform Code/Bank/Schem/uBITz-Bank-Reference-Impl/02-Libraries/Footprints/FT232HL-REEL.step
9.00 x 1.60 x 9.00 mm
