dumaiss/uBITz/uBITz Platform Code/Dock/Schem/uBITz-Dock-Reference-Impl/02-Libraries/Footprints/BAT54TW-TP.step

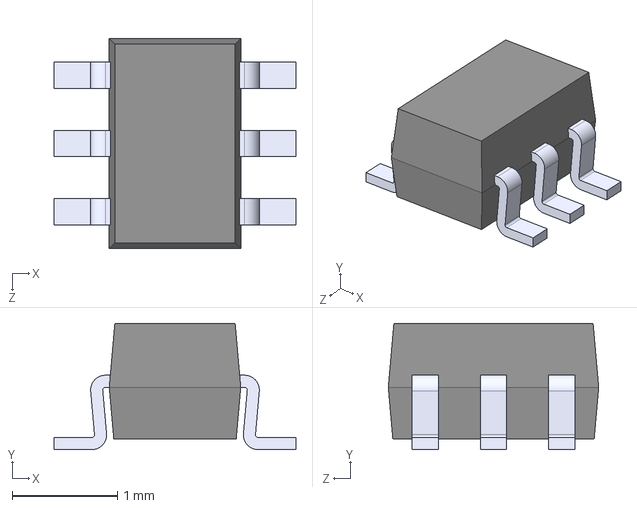
[picture p10: CAD file, 2025-12-24]
uBITz Platform Code/Dock/Schem/uBITz-Dock-Reference-Impl/02-Libraries/Footprints/BAT54TW-TP.step
2.30 x 1.20 x 2.00 mm
