dumaiss/uBITz/uBITz Platform Code/Bank/Schem/uBITz-Bank-Reference-Impl/02-Libraries/Footprints/24LC16BT-I_SN.step

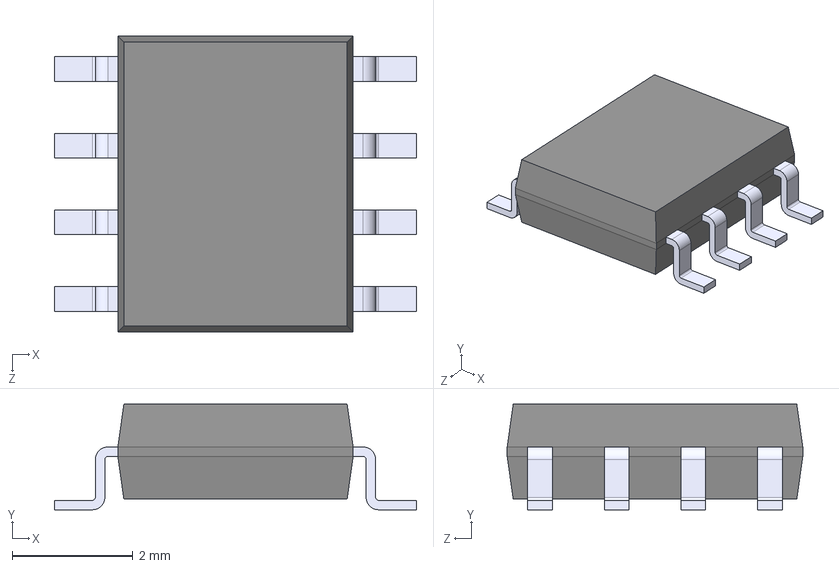
[picture p11: CAD file, 2025-12-24]
uBITz Platform Code/Bank/Schem/uBITz-Bank-Reference-Impl/02-Libraries/Footprints/24LC16BT-I_SN.step
6.00 x 1.75 x 4.90 mm
