dumaiss/uBITz/uBITz Platform Code/Dock/Schem/uBITz-Dock-Reference-Impl/02-Libraries/Footprints/LTC1326CMS8-2.5_TRPBF.step

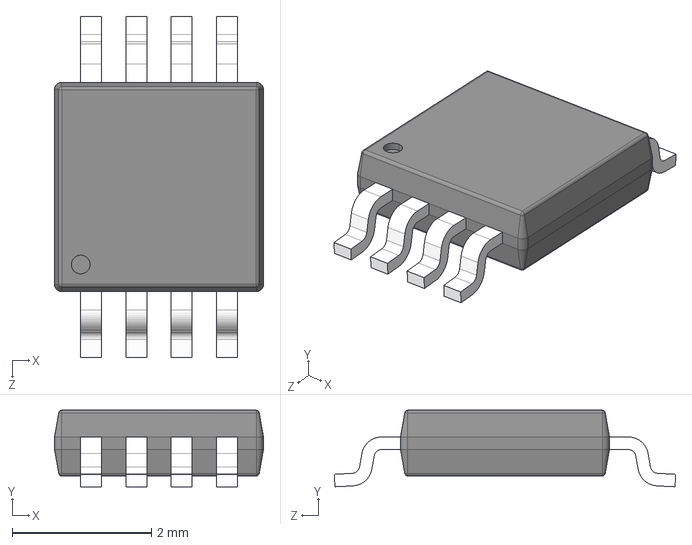
[picture p12: CAD file, 2025-12-24]
uBITz Platform Code/Dock/Schem/uBITz-Dock-Reference-Impl/02-Libraries/Footprints/LTC1326CMS8-2.5_TRPBF.step
3.00 x 1.10 x 4.90 mm
