dumaiss/uBITz/uBITz Platform Code/Bank/Schem/uBITz-Bank-Reference-Impl/02-Libraries/Footprints/MAX662ACSA_T.step

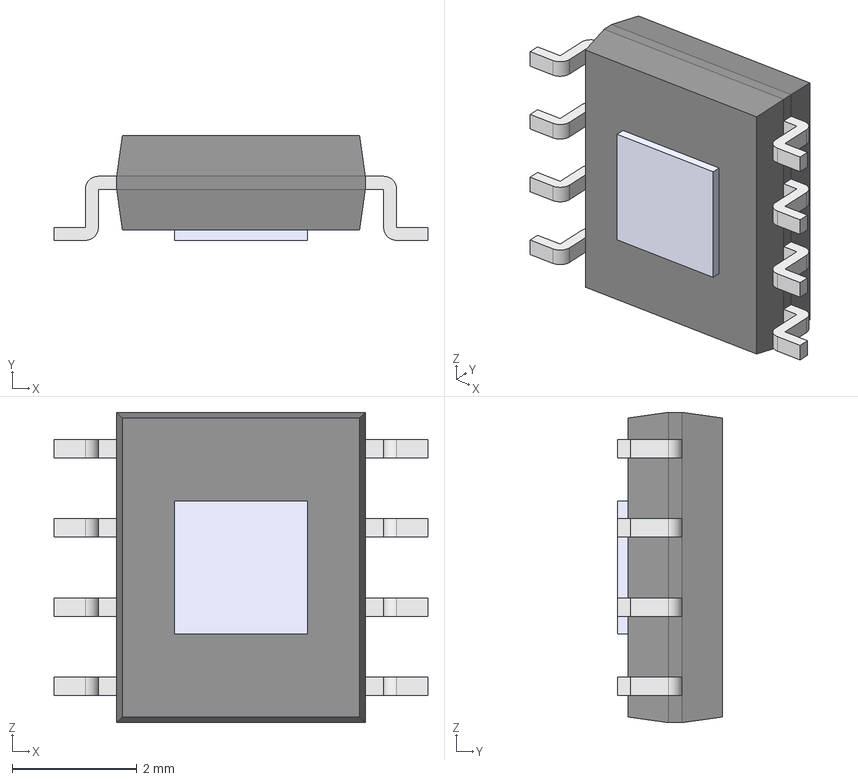
[picture p13: CAD file, 2025-12-24]
uBITz Platform Code/Bank/Schem/uBITz-Bank-Reference-Impl/02-Libraries/Footprints/MAX662ACSA_T.step
6.00 x 1.68 x 4.98 mm
Body001 (Mirror #1) x 4
XY-plane x 12
X-axis x 12
