dumaiss/uBITz/uBITz Platform Code/Bank/Schem/uBITz-Bank-Reference-Impl/02-Libraries/Footprints/ECS-2033-120-BN.step

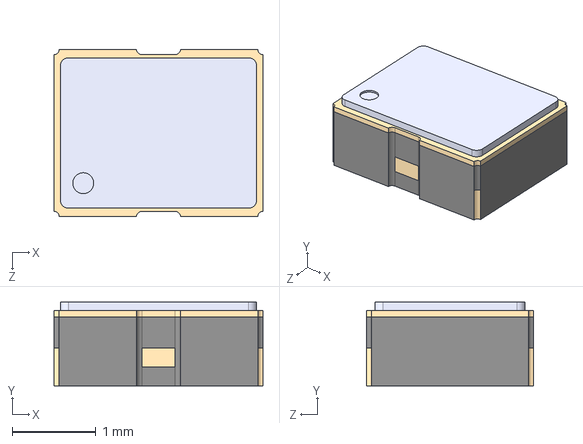
[picture p14: CAD file, 2025-12-24]
uBITz Platform Code/Bank/Schem/uBITz-Bank-Reference-Impl/02-Libraries/Footprints/ECS-2033-120-BN.step
2.50 x 1.00 x 2.00 mm
