dumaiss/uBITz/uBITz Platform Code/Bank/Schem/uBITz-Bank-Reference-Impl/02-Libraries/Footprints/ECS-3951M-120-B-TR.step

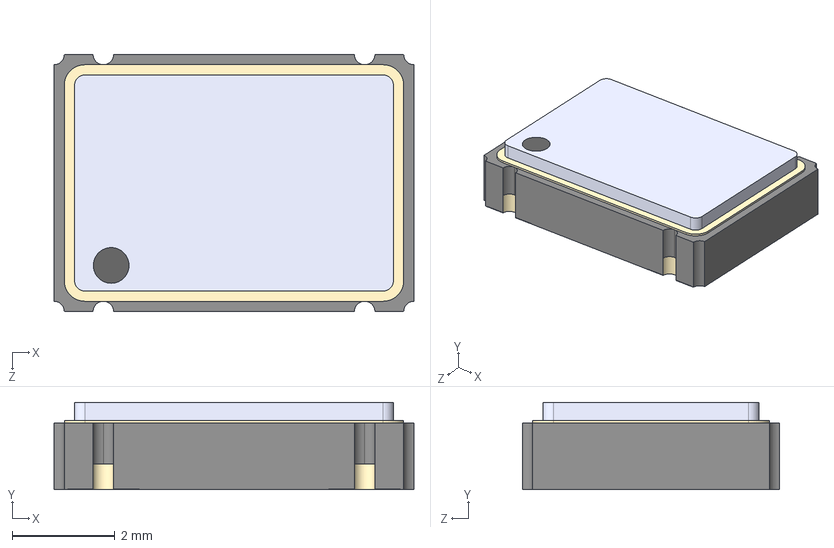
[picture p15: CAD file, 2025-12-24]
uBITz Platform Code/Bank/Schem/uBITz-Bank-Reference-Impl/02-Libraries/Footprints/ECS-3951M-120-B-TR.step
7.00 x 1.70 x 5.00 mm
