dumaiss/uBITz/uBITz Platform Code/Bank/Schem/uBITz-Bank-Reference-Impl/02-Libraries/Footprints/ACH-14.31818MHZ-EK.step

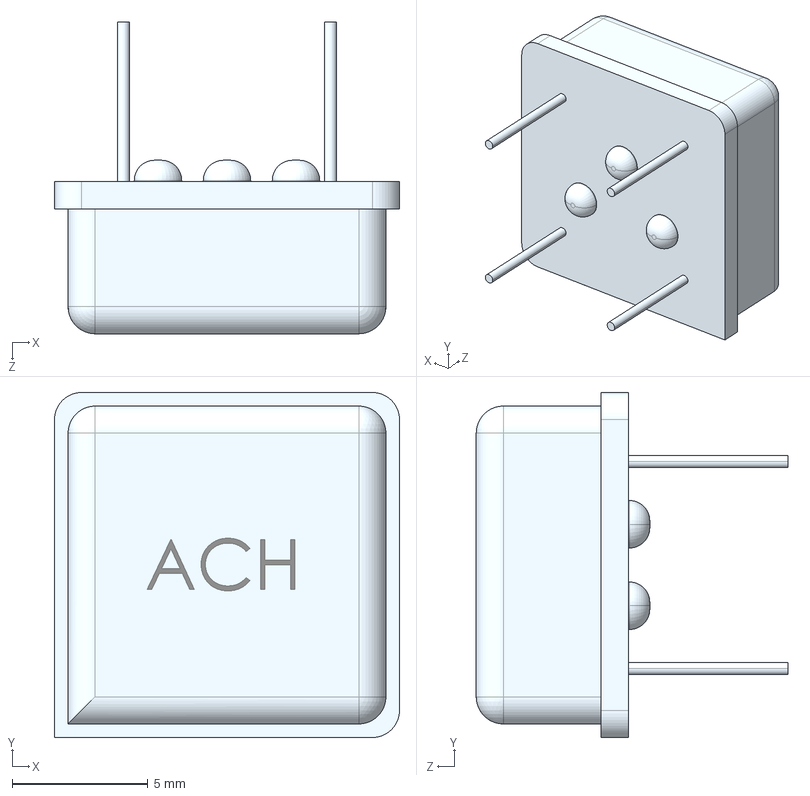
[picture p16: CAD file, 2025-12-24]
uBITz Platform Code/Bank/Schem/uBITz-Bank-Reference-Impl/02-Libraries/Footprints/ACH-14.31818MHZ-EK.step
12.7 x 12.7 x 11.5 mm
