dumaiss/uBITz/uBITz Platform Code/Dock/Schem/uBITz-Dock-Reference-Impl/02-Libraries/Footprints/LMR14050SSQDDARQ1.step

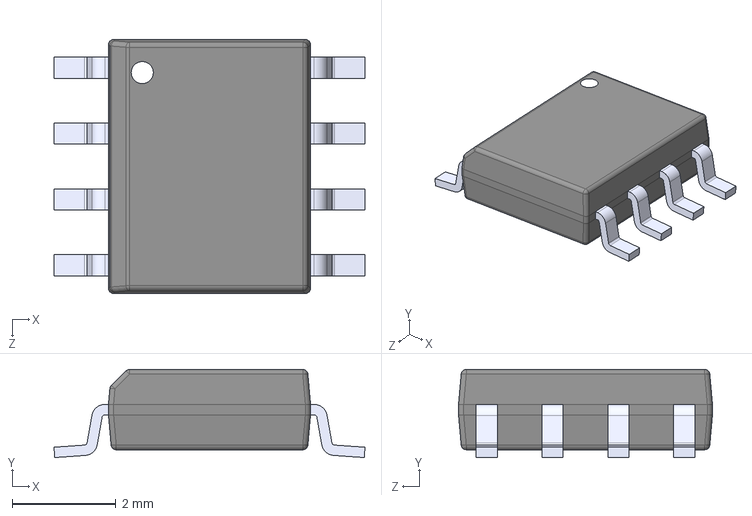
[picture p17: CAD file, 2025-12-24]
uBITz Platform Code/Dock/Schem/uBITz-Dock-Reference-Impl/02-Libraries/Footprints/LMR14050SSQDDARQ1.step
6.00 x 1.70 x 4.90 mm
