dumaiss/uBITz/uBITz Platform Code/Bank/Schem/uBITz-Bank-Reference-Impl/03-Z80-Based-Host/uBITz-Host-z80-Host/uBITz-Host-z80-Host.pdf

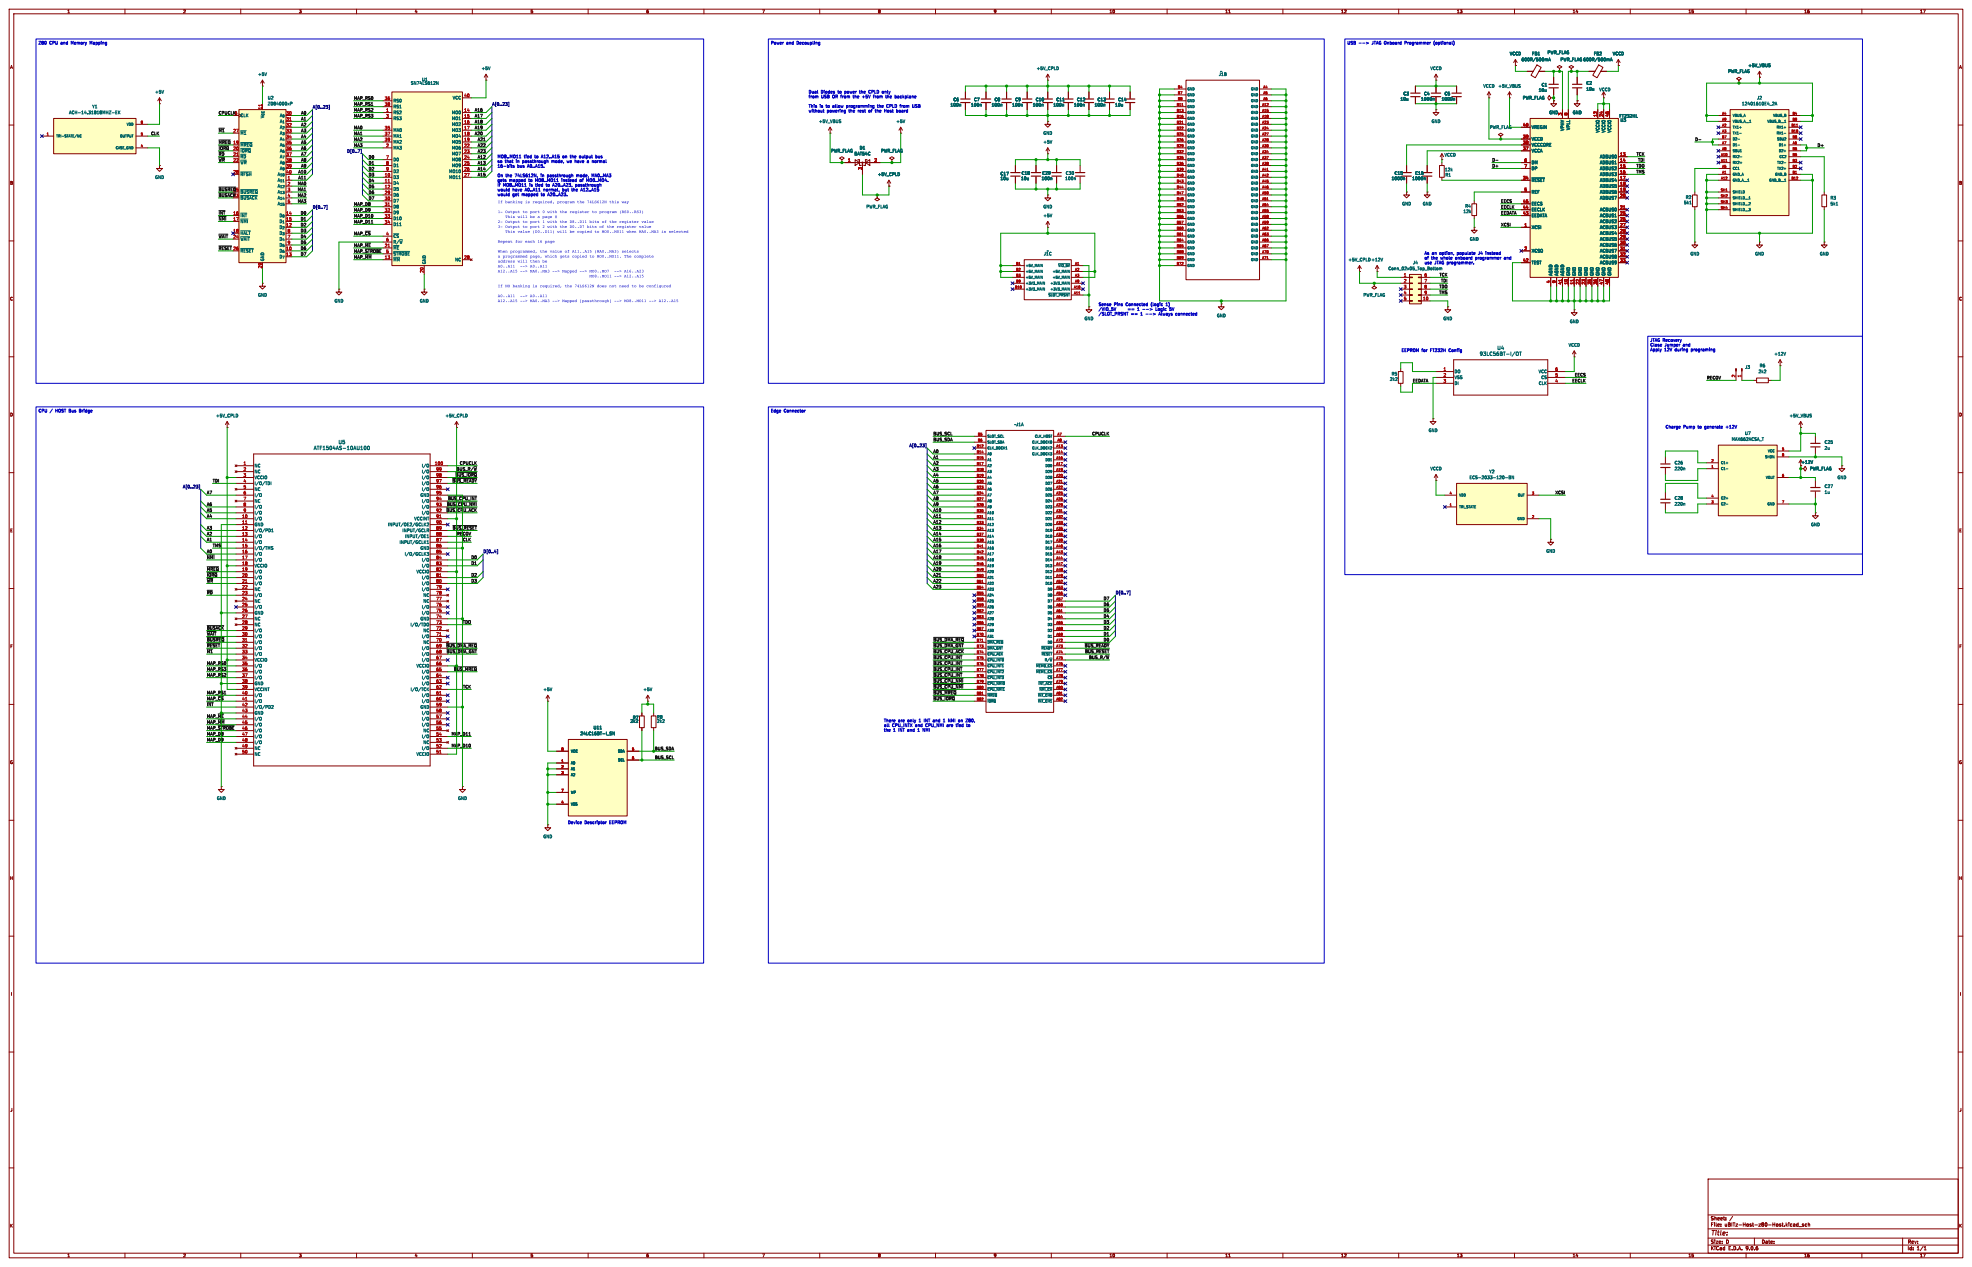
[picture p19: page 1]

use JTAG programmer. Dual Diodes to power the CPLD only
10u GND GND

8 GND 10 GND 11 GND 22 GND 23 GND 35 VCCIO 12 GND 36 VCCIO 24 GND 47 VCCIO 46 GND 48 ADBUS0

MO8..MO11 tied to A12..A15 on the output bus

Sense Pins Connected (logic 1)

There are only 1 INT and 1 NMI on Z80, all CPU_INTX and CPU_NMI are tied to

the 1 INT and 1 NMI

Id: 1/1 Title: File: uBITz-Host-z80-Host.kicad_sch Sheet: /
