dumaiss/uBITz/uBITz Platform Code/Host/Schem/uBITz-Host-Reference-Impl/04-Z80-Based-Host-No-Mapper/uBITz-Host-z80-Host-No-Mapper/uBITz-Host-z80-Host-No-Mapper.pdf

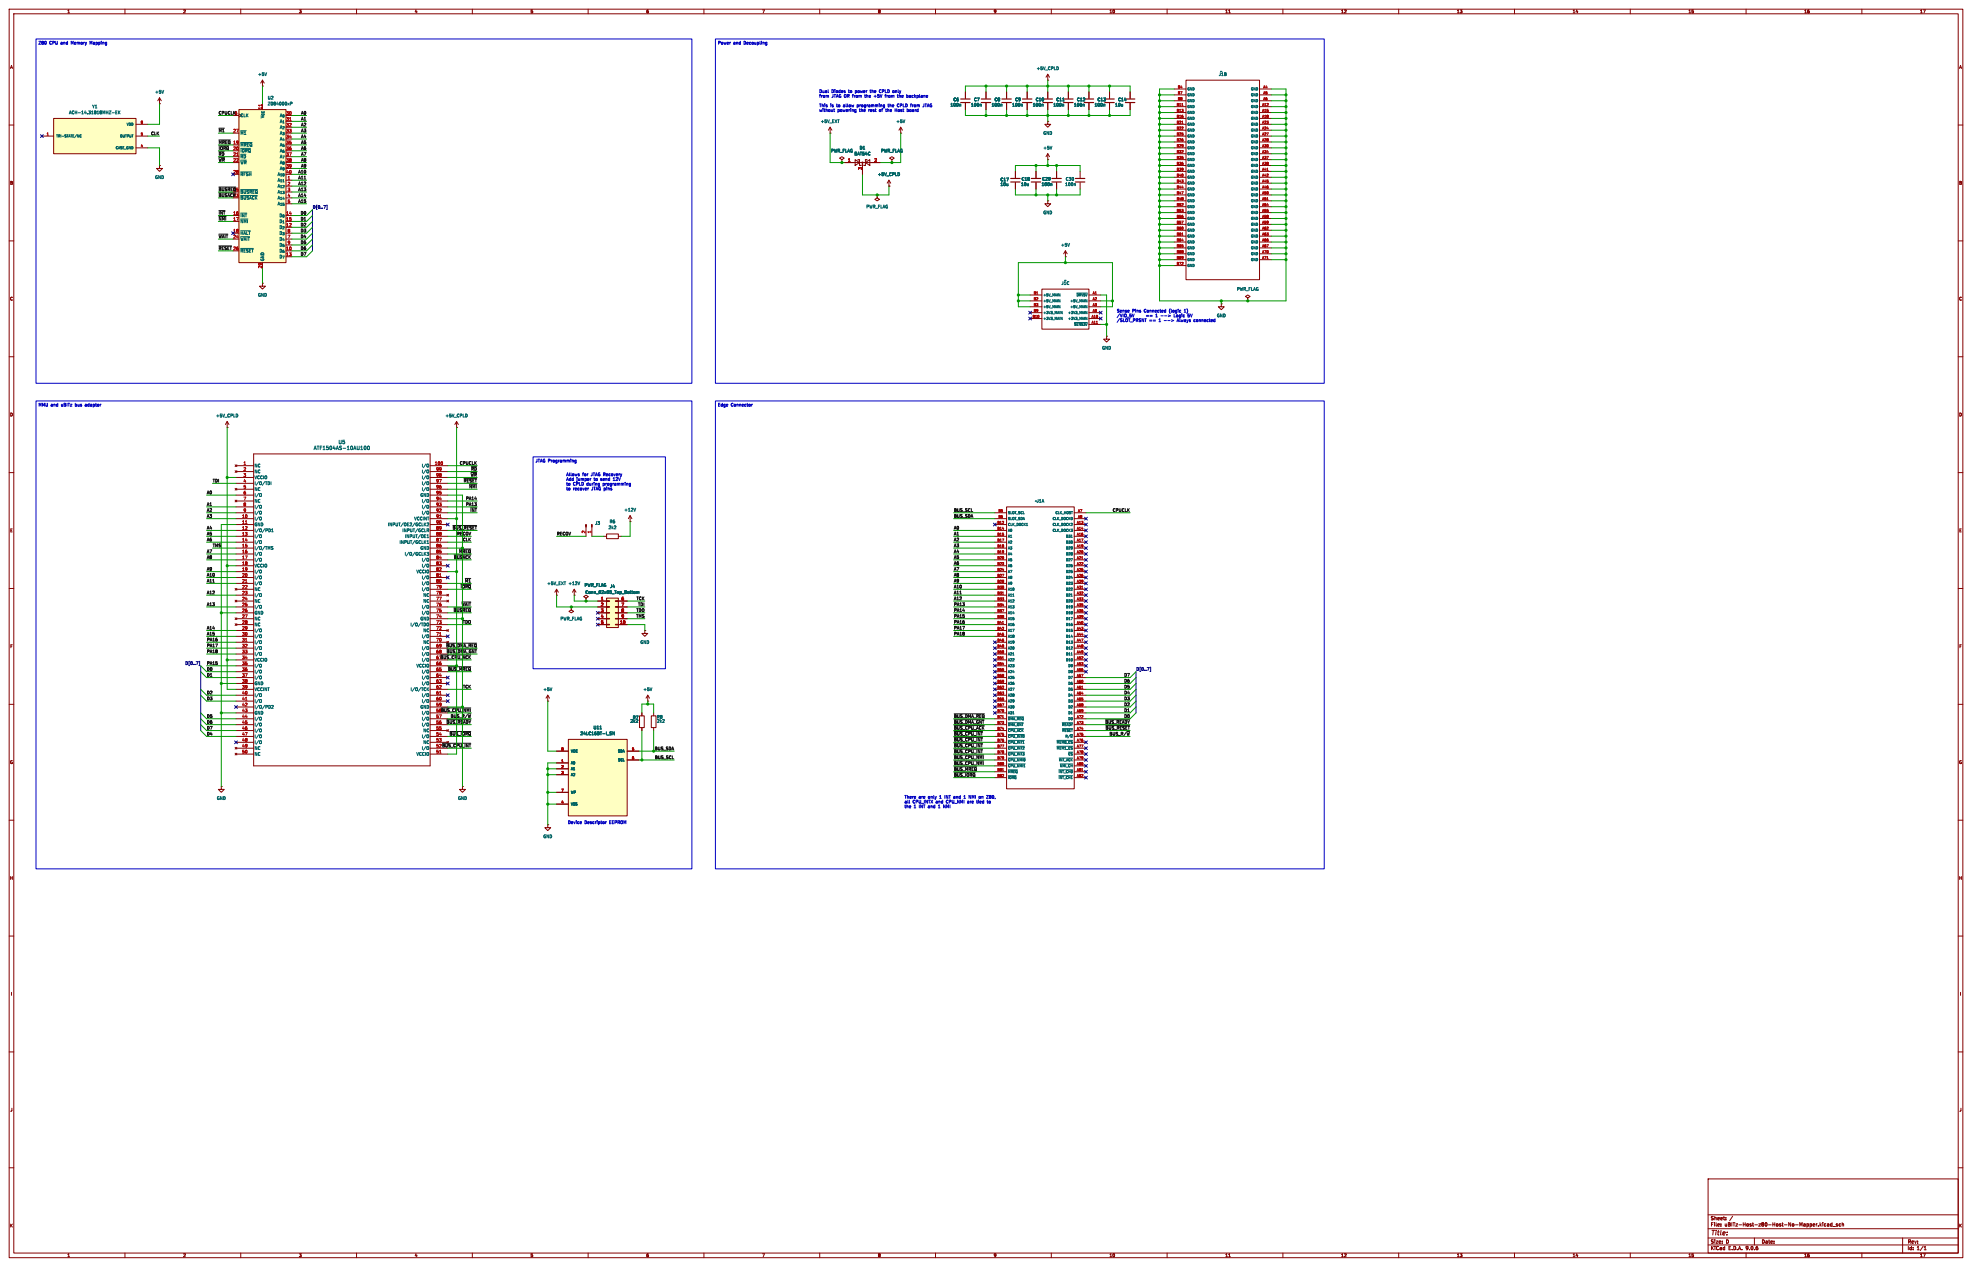
[picture p20: page 1]

Z80 CPU and Memory Mapping

Dual Diodes to power the CPLD only

without powering the rest of the Host board

~{M1} CPUCLK
~{MREQ} ~{RD} ~{NMI} ~{WR} ~{INT}
~{IORQ}

Sense Pins Connected (logic 1)

Allows for JTAG Recovery Add jumper to send 12V

to CPLD during programming
to recover JTAG pins

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

the 1 INT and 1 NMI

Id: 1/1 Title: File: uBITz-Host-z80-Host-No-Mapper.kicad_sch Sheet: /
