dumaiss/uBITz/uBITz Platform Code/Host/Schem/uBITz-Host-Reference-Impl/05-6309-Based-Host/uBITz-Host-6309-Host/uBITz-Host-6309-Host.pdf

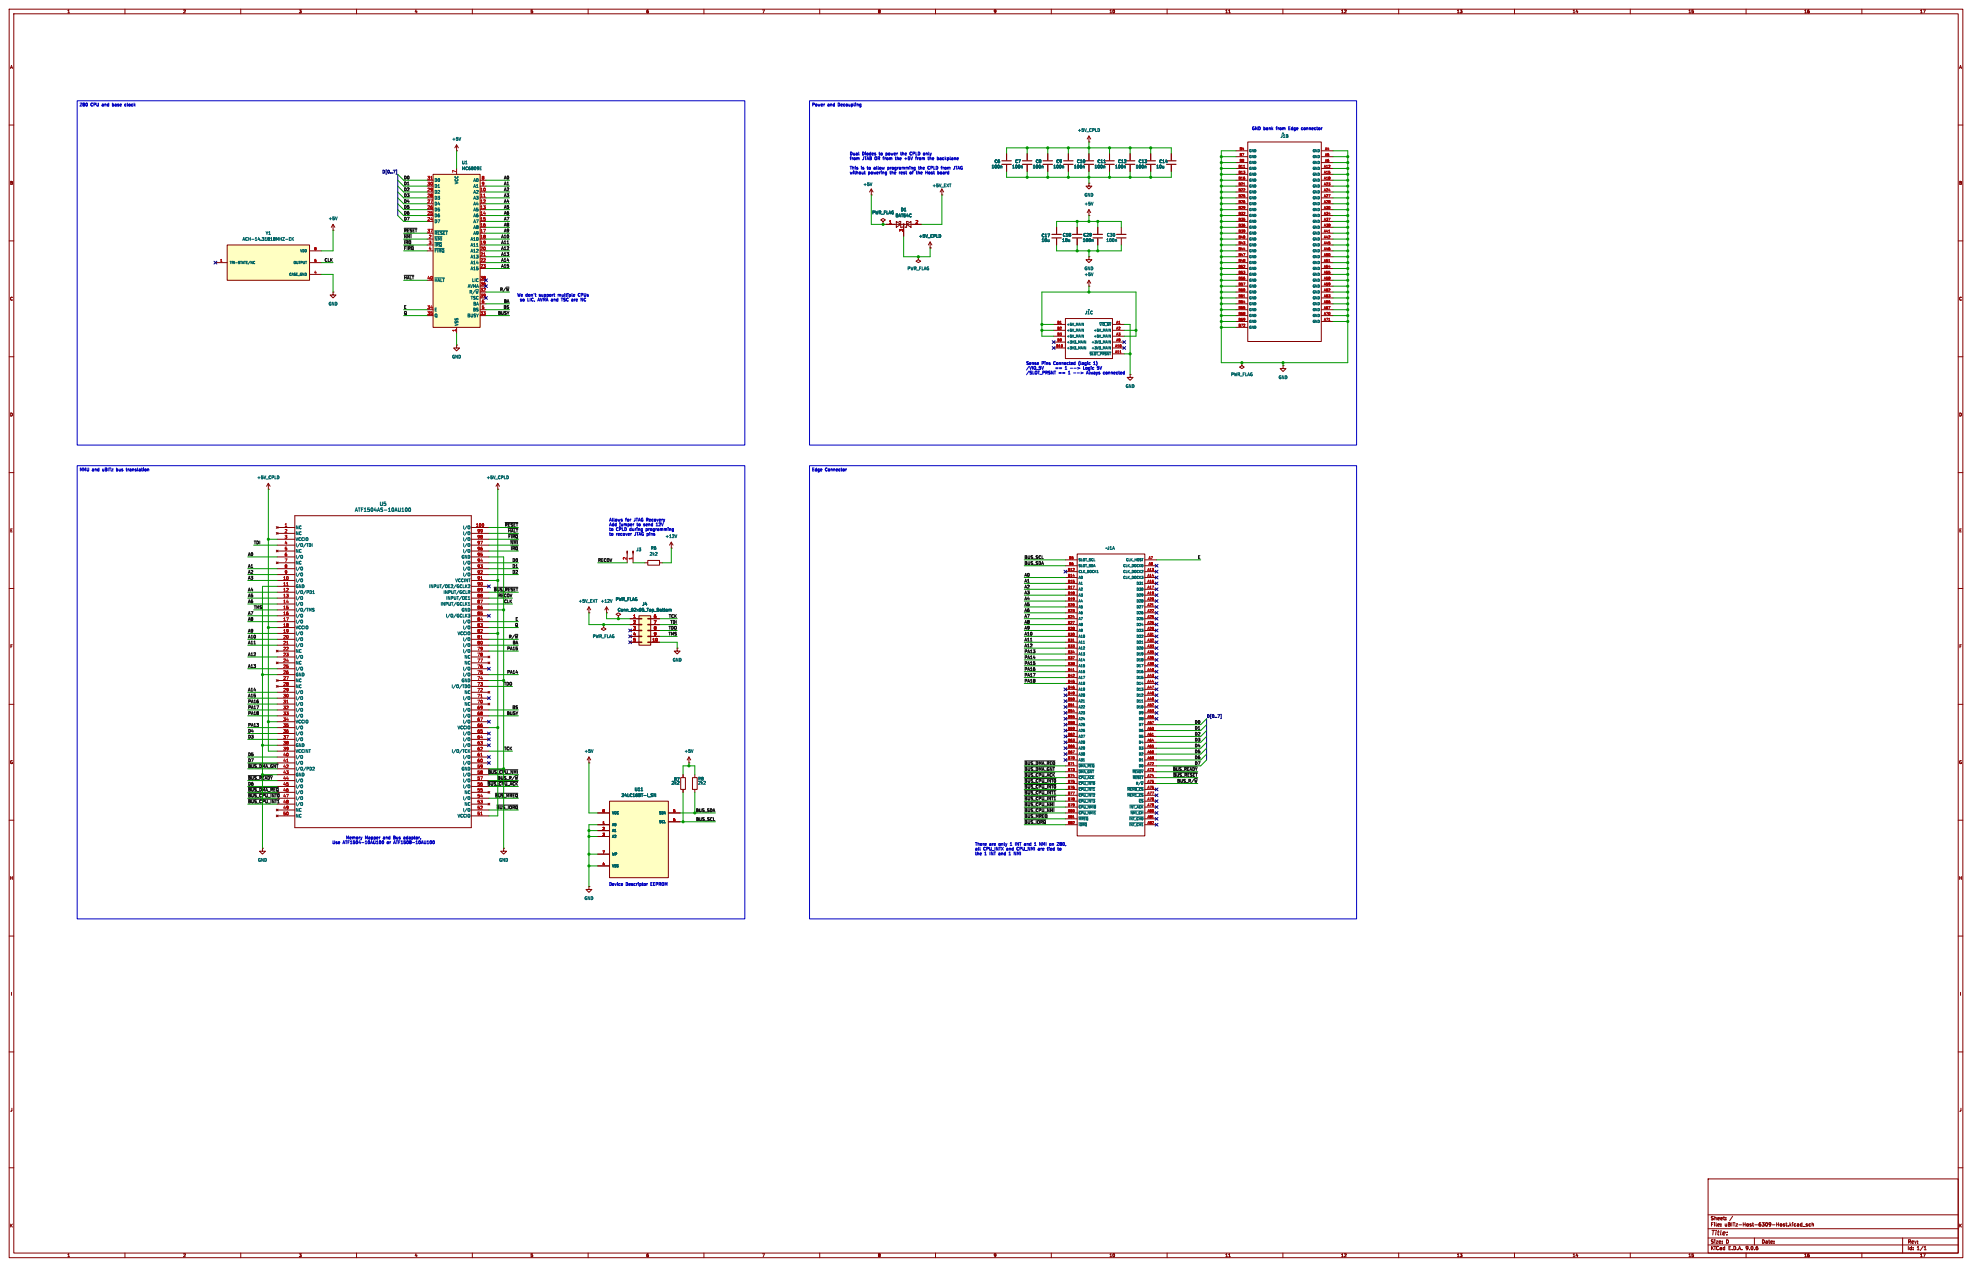
[picture p21: page 1]

Z80 CPU and base clock

+5V_CPLD GND
LIC 38 AVMA 36 R/~{W}32 TSC 39 BA 6 BS 5 BUSY 33 U1 MC6809E

Dual Diodes to power the CPLD only

so LIC, AVMA and TSC are NC

Sense Pins Connected (logic 1)

MMU and uBITz bus translation

Allows for JTAG Recovery Add jumper to send 12V
2k2 PWR_FLAG

to CPLD during programming

the 1 INT and 1 NMI

Id: 1/1 Title: File: uBITz-Host-6309-Host.kicad_sch Sheet: /
