dumaiss/uBITz/uBITz Platform Code/Bank/Schem/uBITz-Bank-Reference-Impl/03-Z80-Based-Host/uBITz-Host-z80-Host/uBITz-Host-z80-Host.kicad_pcb

## KiCad design uBITz Platform Code/Bank/Schem/uBITz-Bank-Reference-Impl/03-Z80-Based-Host/uBITz-Host-z80-Host/uBITz-Host-z80-Host.kicad_pcb (2026-01-05)

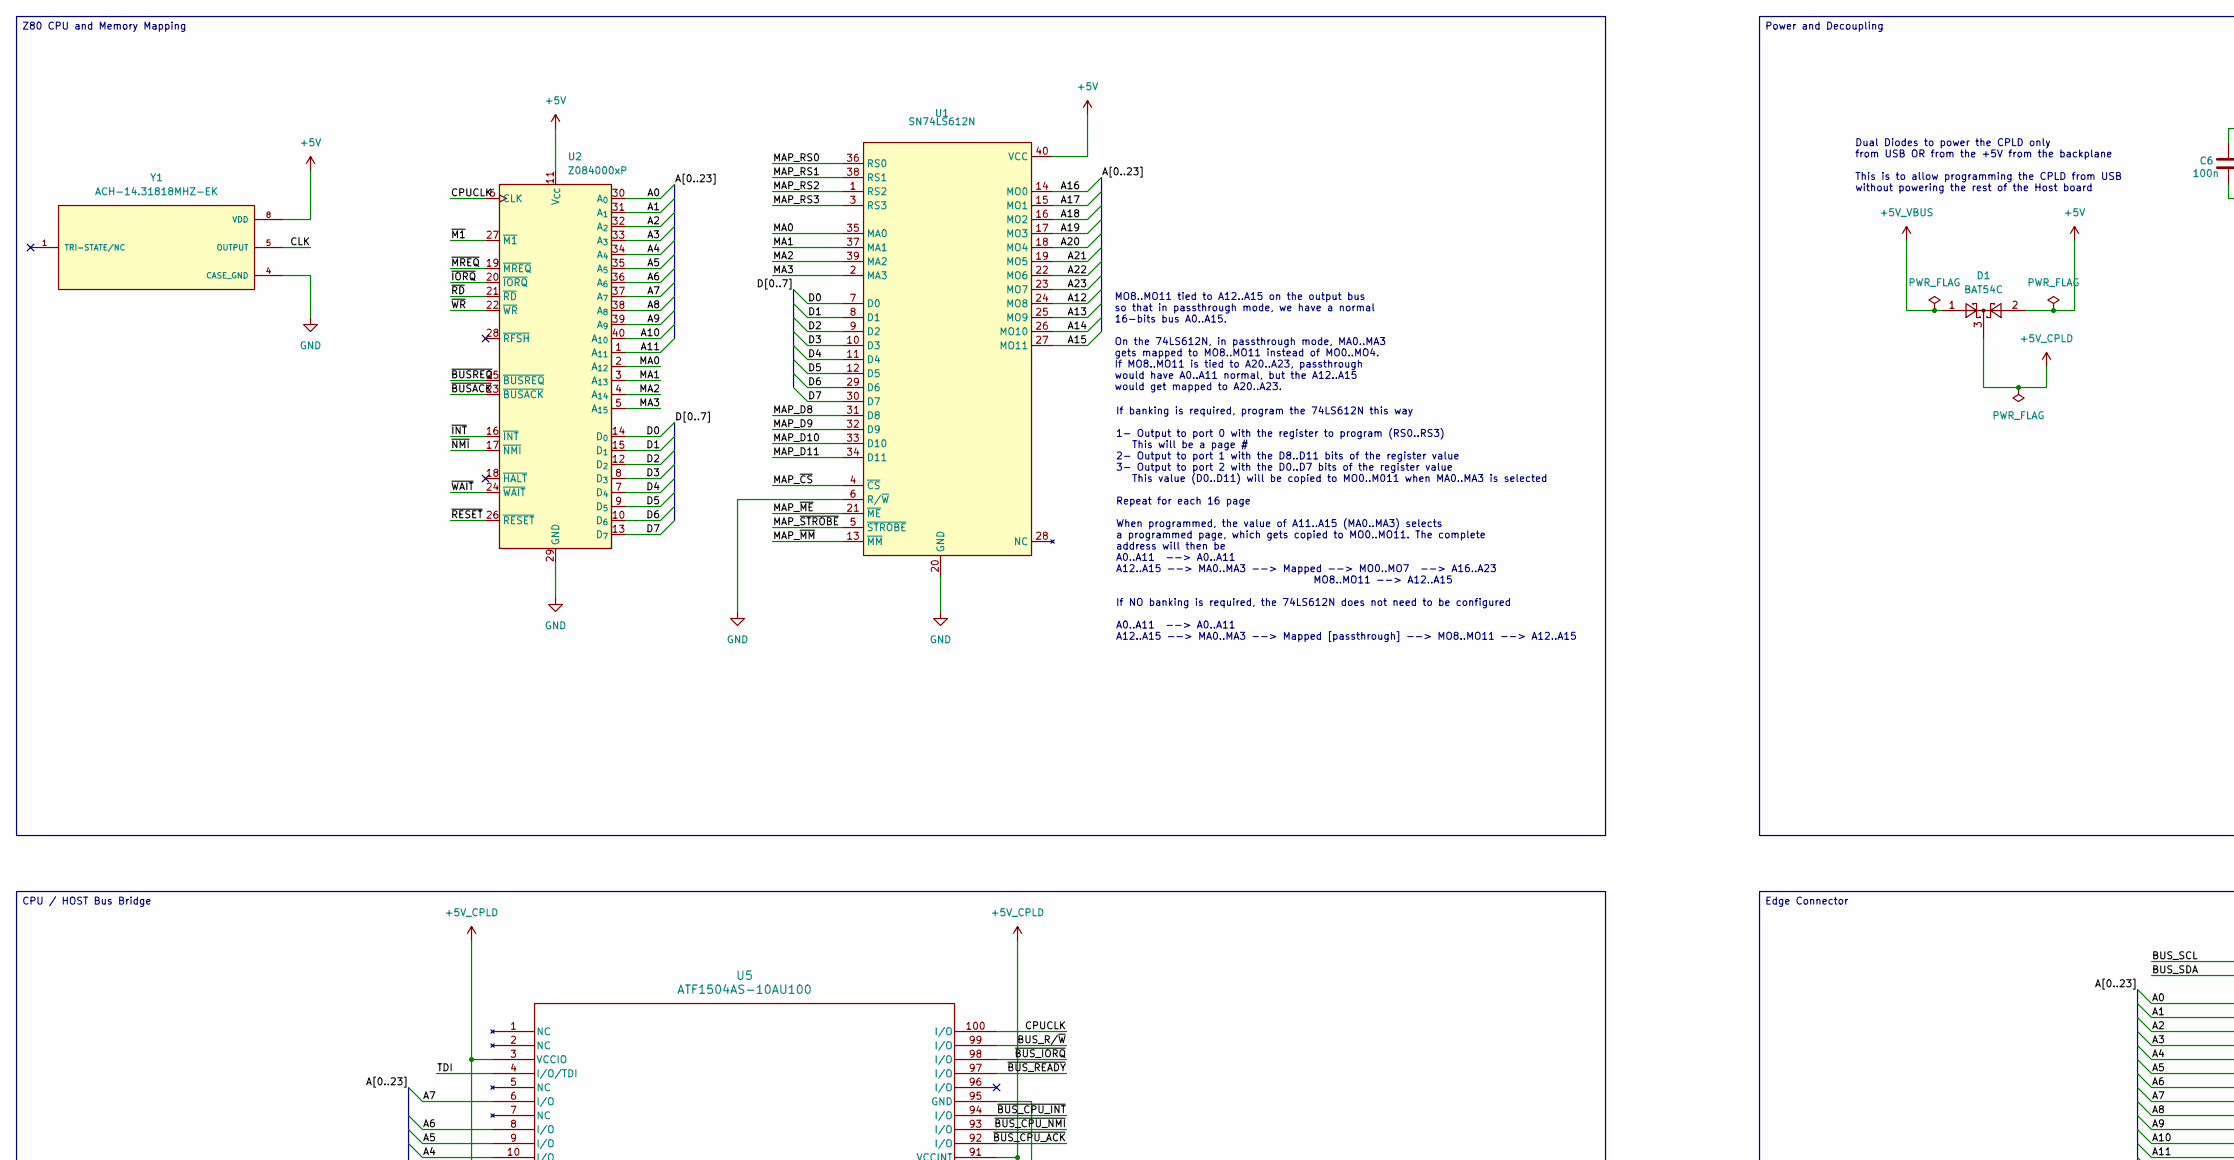
[picture p22: schematic uBITz-Host-z80-Host.kicad_sch, part in row 1, column 1]

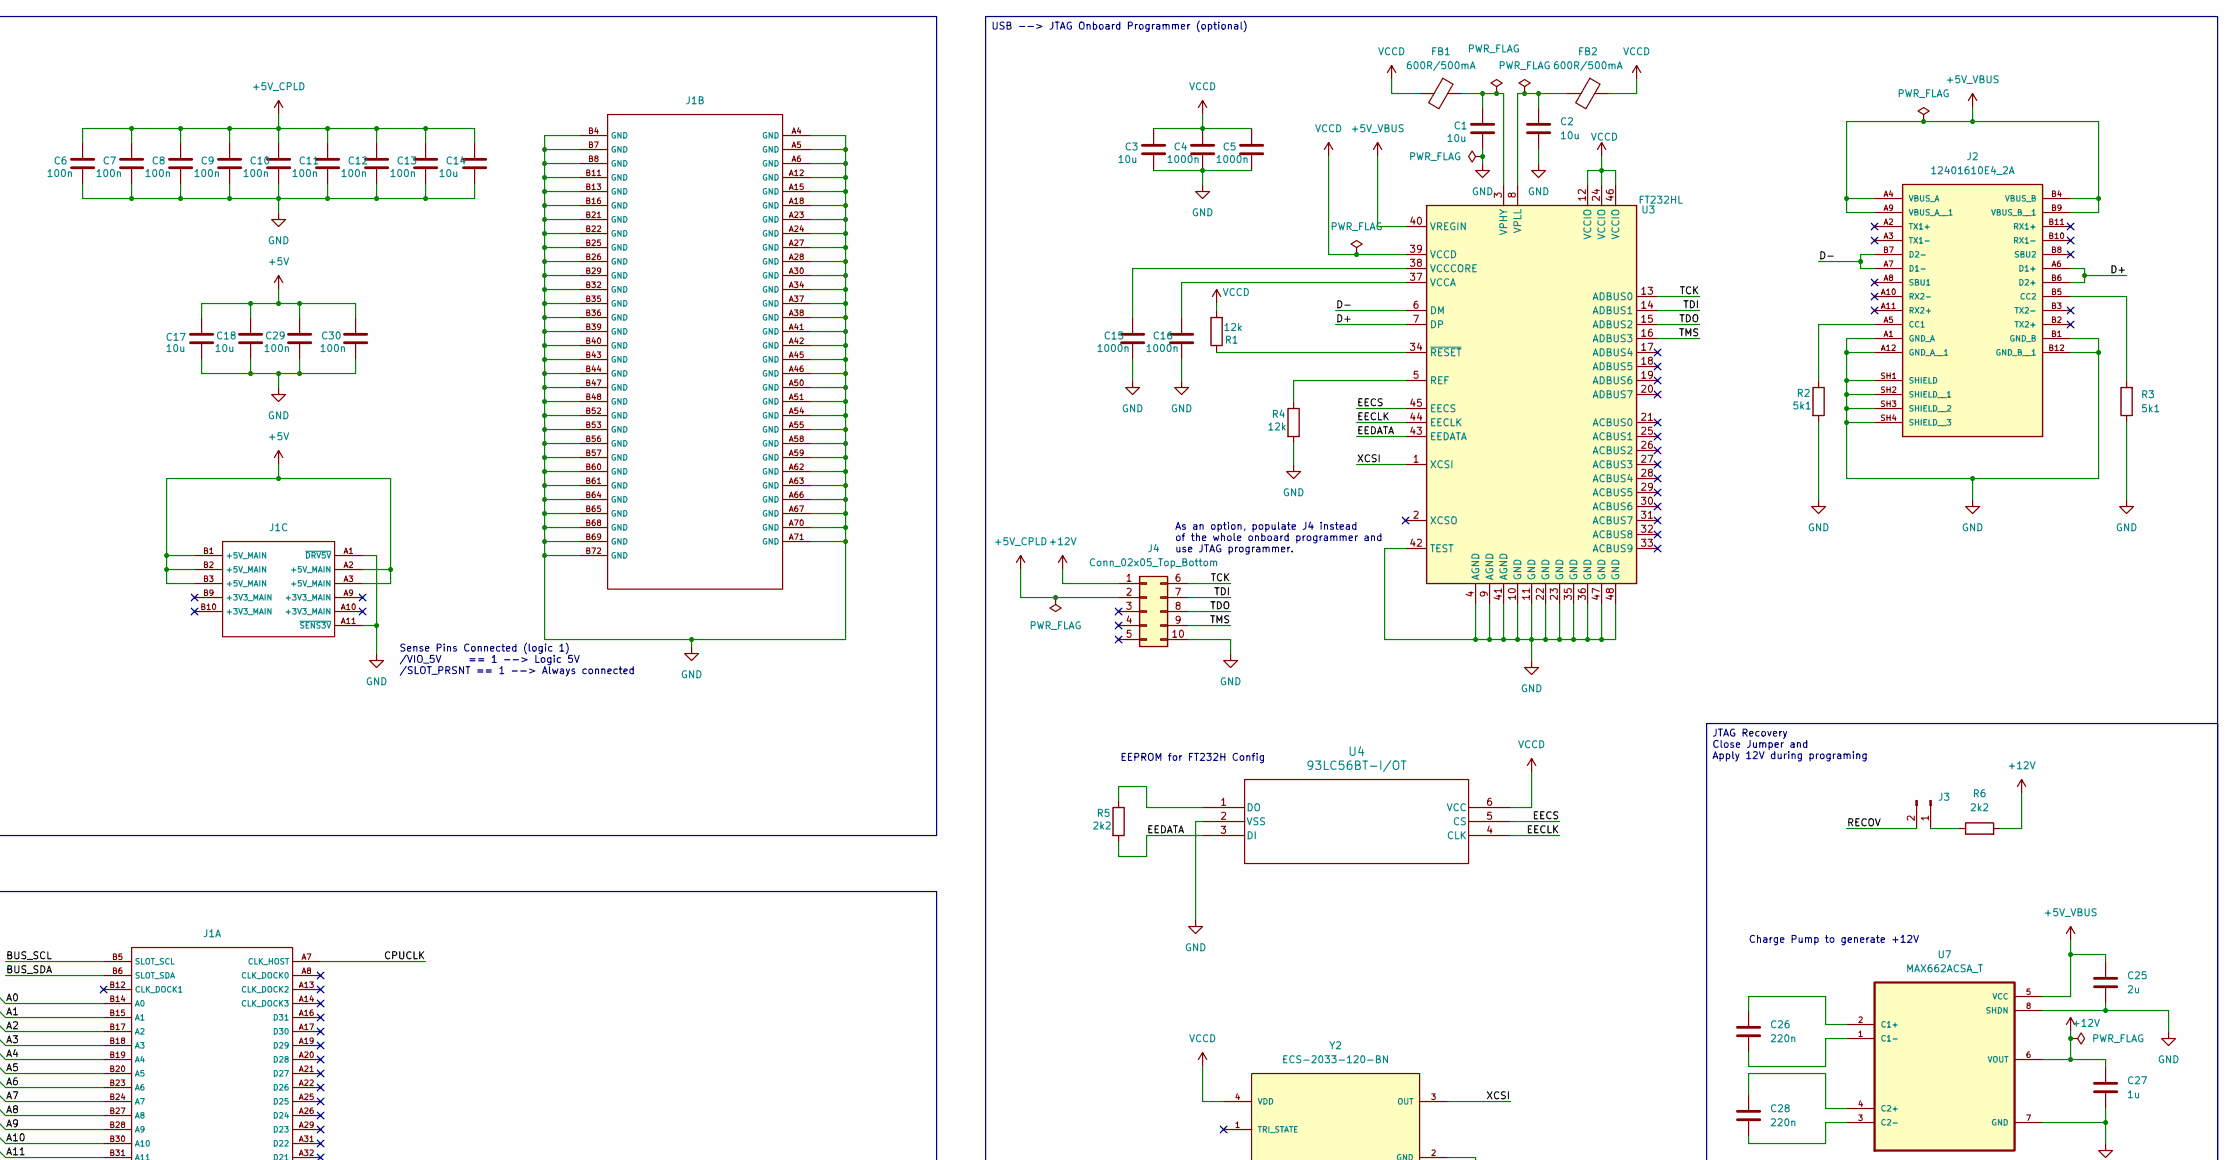
[picture p23: schematic uBITz-Host-z80-Host.kicad_sch, part in row 1, column 2]

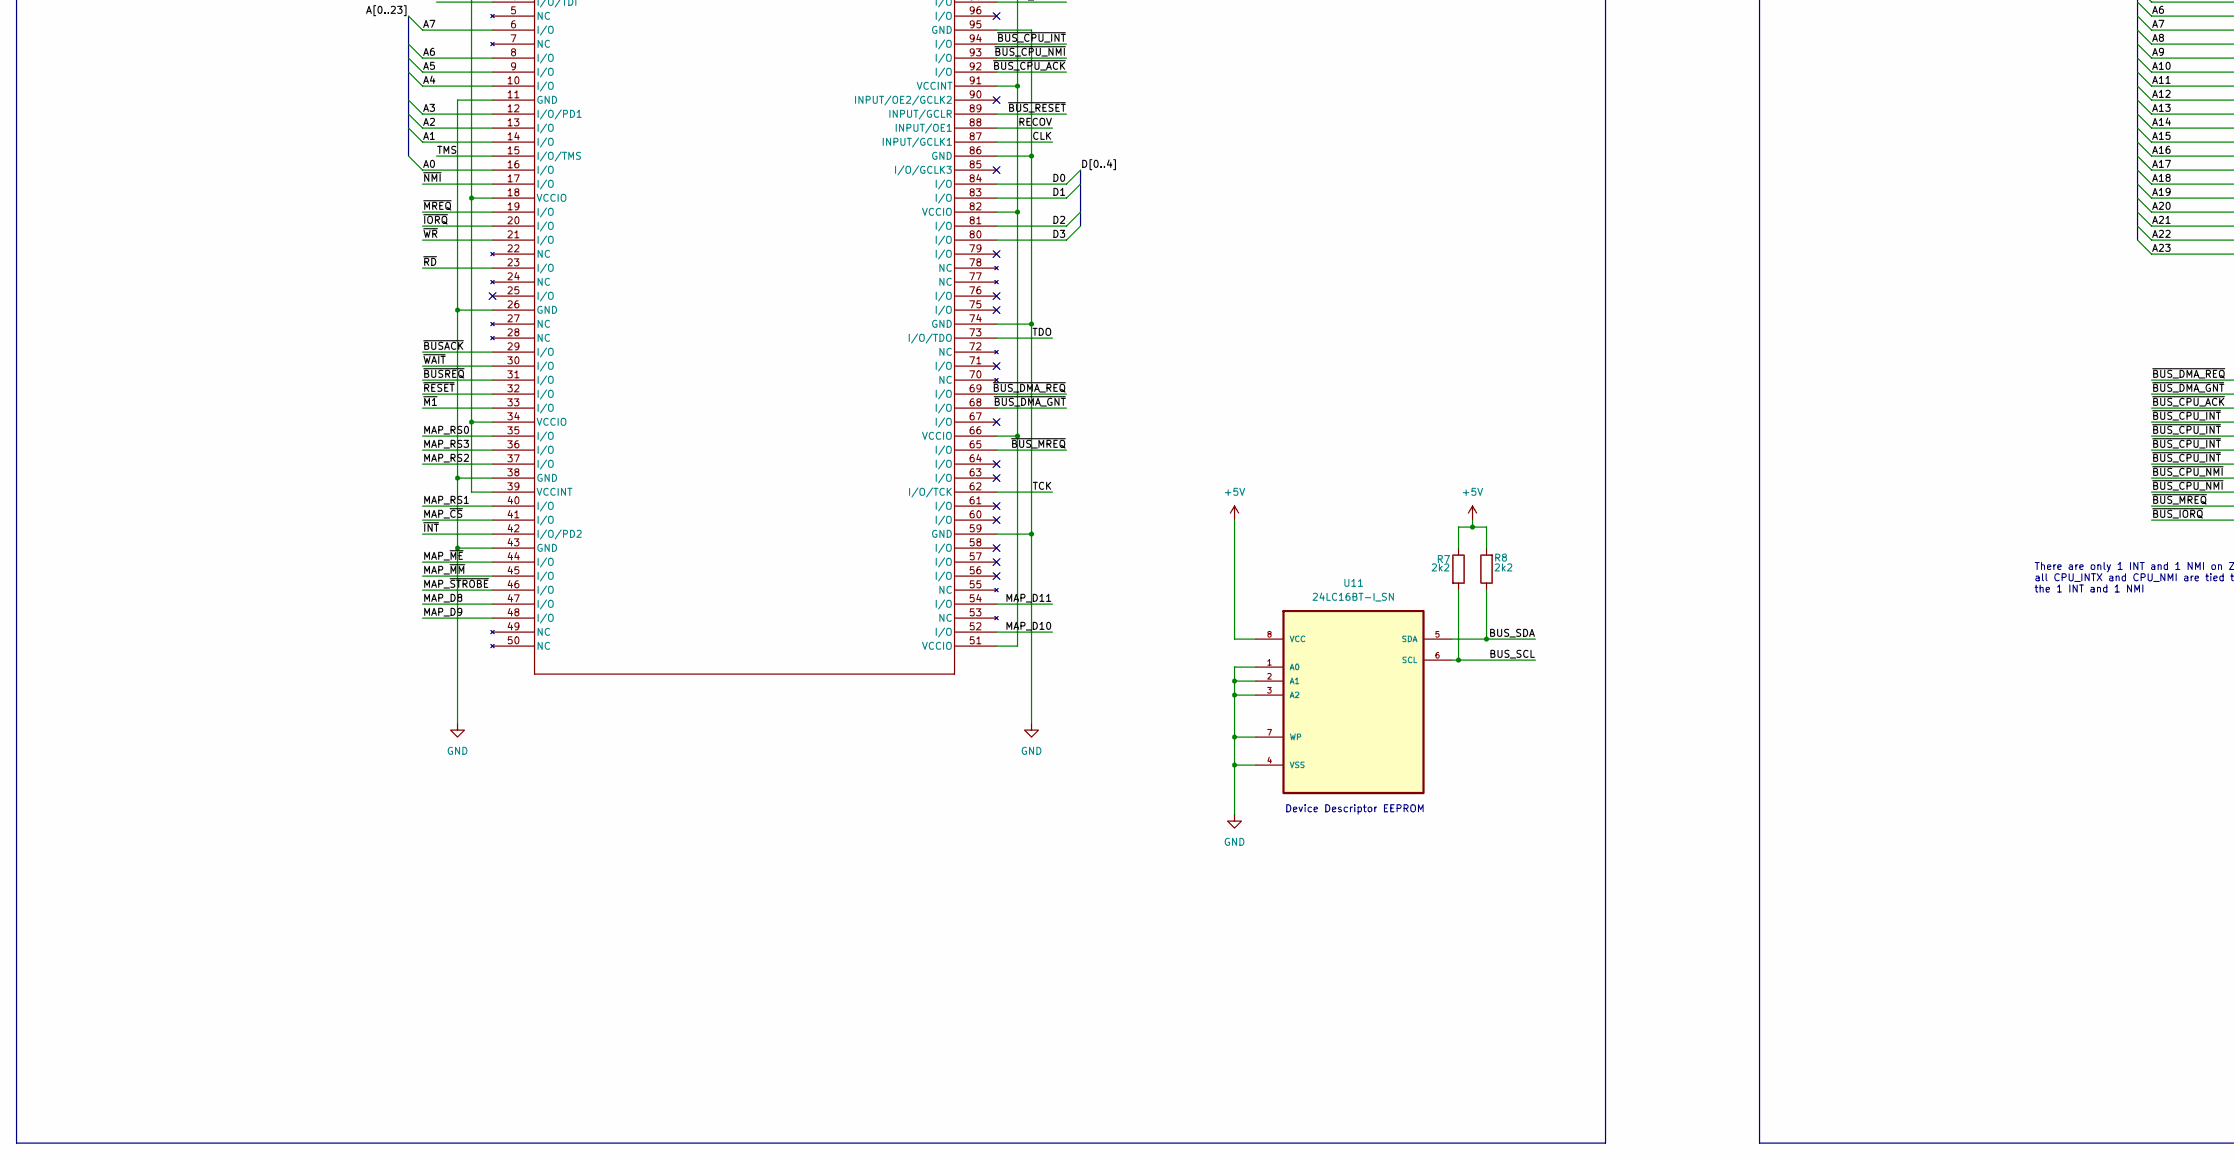
[picture p24: schematic uBITz-Host-z80-Host.kicad_sch, part in row 2, column 1]

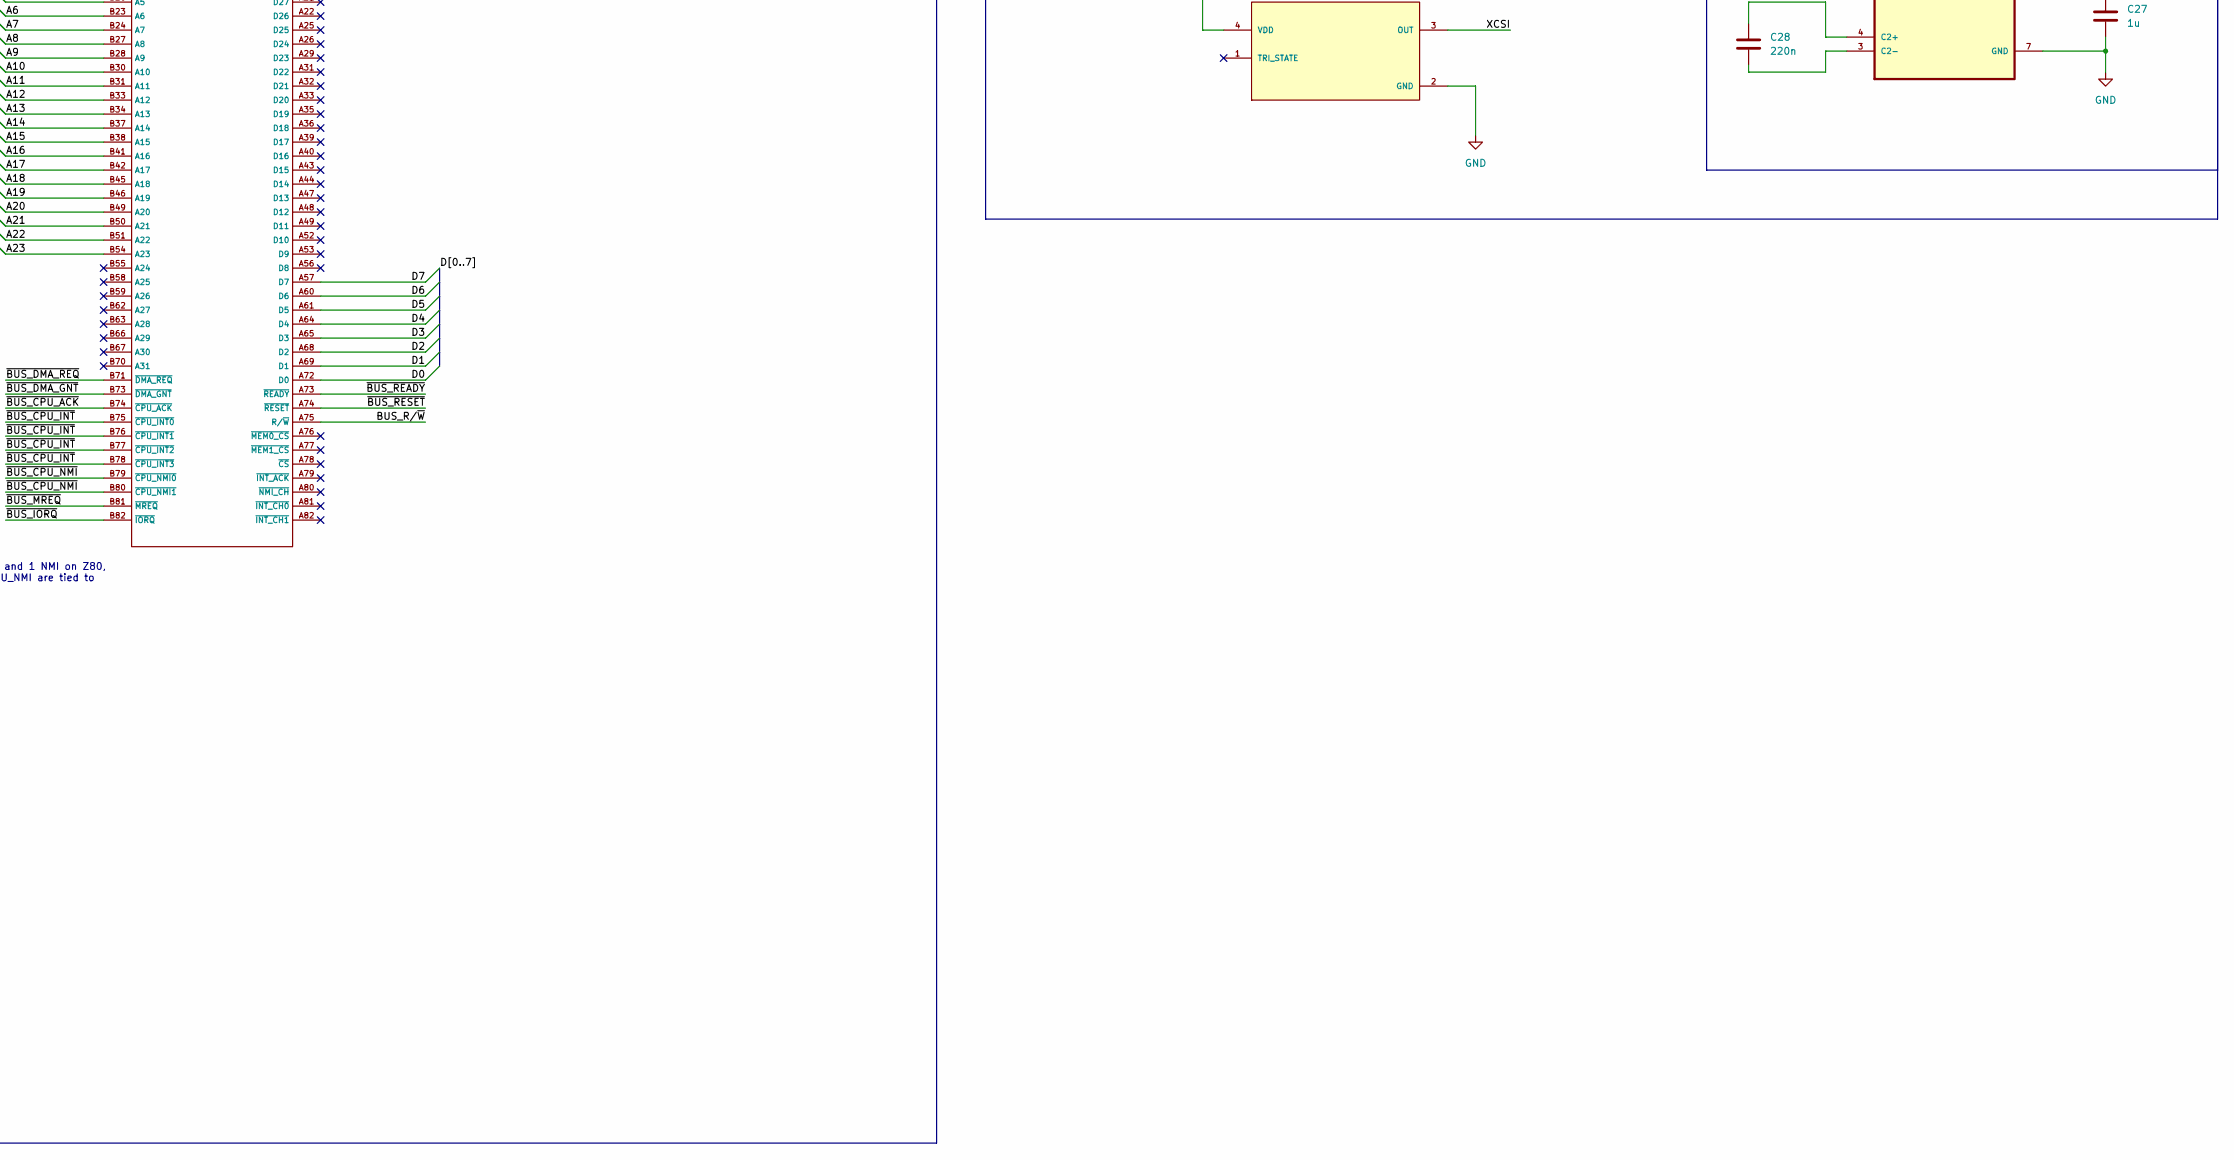
[picture p25: schematic uBITz-Host-z80-Host.kicad_sch, part in row 2, column 2]

Parts:
C1, C2, C3, C14, C17, C18: 10u; C_0603_1608Metric_Pad1.08x0.95mm_HandSolder
C4, C5, C15, C16: 1000n; C_0603_1608Metric_Pad1.08x0.95mm_HandSolder
C6, C7, C8, C9, C10, C11, C12, C13, C29, C30: 100n; C_0603_1608Metric_Pad1.08x0.95mm_HandSolder
C25: 2u; C_0603_1608Metric_Pad1.08x0.95mm_HandSolder
C26, C28: 220n; C_0603_1608Metric_Pad1.08x0.95mm_HandSolder
C27: 1u; C_0603_1608Metric_Pad1.08x0.95mm_HandSolder
D1: BAT54C; SOT-23
FB1, FB2: 600R/500mA; L_0805_2012Metric_Pad1.05x1.20mm_HandSolder
J1: BUS_PCIexpress_x16
J2: 12401610E4_2A; AMPHENOL_12401610E4_2A; PARTREV C
J3: Conn_01x02_Pin; PinHeader_1x02_P2.54mm_Vertical
J4: Conn_02x05_Top_Bottom; PinHeader_2x05_P2.54mm_Vertical
R1, R4: 12k; R_0603_1608Metric_Pad0.98x0.95mm_HandSolder
R2, R3: 5k1; R_0603_1608Metric_Pad0.98x0.95mm_HandSolder
R5, R6, R7, R8: 2k2; R_0603_1608Metric_Pad0.98x0.95mm_HandSolder
U1: SN74LS612N; DIP-40_W15.24mm
U2: Z084000xP; DIP-40_W15.24mm
U3: FT232HL; QFP50P900X900X160-48N
U4: 93LC56BT-I/OT; SOT-23-6_MC_MCH
U5: ATF1504AS-10AU100; 100A_ATM
U7: MAX662ACSA_T; SOIC127P600X175-8N
U11: 24LC16BT-I_SN; SOIC127P600X175-8N; MPN 24LC16BT-I/SN
Y1: ACH-14.31818MHZ-EK; XTAL_ACH-14.31818MHZ-EK; PARTREV 11.15.2016
Y2: ECS-2033-120-BN; OSC_ECS-2033-120-BN; PARTREV 11/15/13

Connections:
+5V: C17.1, C18.1, C29.1, C30.1, D1.2, J1.A2 (+5V_MAIN), J1.A3 (+5V_MAIN), J1.B1 (+5V_MAIN), J1.B2 (+5V_MAIN), J1.B3 (+5V_MAIN), R7.1, R8.2, U1.40 (VCC), U2.11 (V_{CC}), U11.8 (VCC), Y1.8 (VDD)
+5V_CPLD: C6.1, C7.1, C8.1, C9.1, C10.1, C11.1, C12.1, C13.1, C14.1, D1.3, J4.2, U5.3 (VCCIO), U5.18 (VCCIO), U5.34 (VCCIO), U5.39 (VCCINT), U5.51 (VCCIO), U5.66 (VCCIO), U5.82 (VCCIO), U5.91 (VCCINT)
+5V_VBUS: C25.1, D1.1, J2.A4 (VBUS_A), J2.A9 (VBUS_A__1), J2.B4 (VBUS_B), J2.B9 (VBUS_B__1), U3.40 (VREGIN), U7.5 (VCC)
+12V: C27.1, J4.1, R6.2, U7.6 (VOUT)
/A0: J1.B14 (A0), U2.30 (A_{0}), U5.16 (I/O)
/A1: J1.B15 (A1), U2.31 (A_{1}), U5.14 (I/O)
/A2: J1.B17 (A2), U2.32 (A_{2}), U5.13 (I/O)
/A3: J1.B18 (A3), U2.33 (A_{3}), U5.12 (I/O/PD1)
/A4: J1.B19 (A4), U2.34 (A_{4}), U5.10 (I/O)
/A5: J1.B20 (A5), U2.35 (A_{5}), U5.9 (I/O)
/A6: J1.B23 (A6), U2.36 (A_{6}), U5.8 (I/O)
/A7: J1.B24 (A7), U2.37 (A_{7}), U5.6 (I/O)
/A8: J1.B27 (A8), U2.38 (A_{8})
/A9: J1.B28 (A9), U2.39 (A_{9})
/A10: J1.B30 (A10), U2.40 (A_{10})
/A11: J1.B31 (A11), U2.1 (A_{11})
/A12: J1.B33 (A12), U1.24 (MO8)
/A13: J1.B34 (A13), U1.25 (MO9)
/A14: J1.B37 (A14), U1.26 (MO10)
/A15: J1.B38 (A15), U1.27 (MO11)
/A16: J1.B41 (A16), U1.14 (MO0)
/A17: J1.B42 (A17), U1.15 (MO1)
/A18: J1.B45 (A18), U1.16 (MO2)
/A19: J1.B46 (A19), U1.17 (MO3)
/A20: J1.B49 (A20), U1.18 (MO4)
/A21: J1.B50 (A21), U1.19 (MO5)
/A22: J1.B51 (A22), U1.22 (MO6)
/A23: J1.B54 (A23), U1.23 (MO7)
/BUS_R/~W: J1.A75 (R/~W), U5.99 (I/O)
/BUS_SCL: J1.B5 (SLOT_SCL), R7.2, U11.6 (SCL)
/BUS_SDA: J1.B6 (SLOT_SDA), R8.1, U11.5 (SDA)
/CLK: U5.87 (INPUT/GCLK1), Y1.5 (OUTPUT)
/CPUCLK: J1.A7 (CLK_HOST), U2.6 (CLK), U5.100 (I/O)
/D0: J1.A72 (D0), U1.7 (D0), U2.14 (D_{0}), U5.84 (I/O)
/D1: J1.A69 (D1), U1.8 (D1), U2.15 (D_{1}), U5.83 (I/O)
/D2: J1.A68 (D2), U1.9 (D2), U2.12 (D_{2}), U5.81 (I/O)
/D3: J1.A65 (D3), U1.10 (D3), U2.8 (D_{3}), U5.80 (I/O)
/D4: J1.A64 (D4), U1.11 (D4), U2.7 (D_{4})
/D5: J1.A61 (D5), U1.12 (D5), U2.9 (D_{5})
/D6: J1.A60 (D6), U1.29 (D6), U2.10 (D_{6})
/D7: J1.A57 (D7), U1.30 (D7), U2.13 (D_{7})
/D+: J2.A6 (D1+), J2.B6 (D2+), U3.7 (DP)
/D-: J2.A7 (D1-), J2.B7 (D2-), U3.6 (DM)
/EECLK: U3.44 (EECLK), U4.4 (CLK)
/EECS: U3.45 (EECS), U4.5 (CS)
/EEDATA: R5.2, U3.43 (EEDATA), U4.3 (DI)
/MA0: U1.35 (MA0), U2.2 (A_{12})
/MA1: U1.37 (MA1), U2.3 (A_{13})
/MA2: U1.39 (MA2), U2.4 (A_{14})
/MA3: U1.2 (MA3), U2.5 (A_{15})
/MAP_D8: U1.31 (D8), U5.47 (I/O)
/MAP_D9: U1.32 (D9), U5.48 (I/O)
/MAP_D10: U1.33 (D10), U5.52 (I/O)
/MAP_D11: U1.34 (D11), U5.54 (I/O)
/MAP_RS0: U1.36 (RS0), U5.35 (I/O)
/MAP_RS1: U1.38 (RS1), U5.40 (I/O)
/MAP_RS2: U1.1 (RS2), U5.37 (I/O)
/MAP_RS3: U1.3 (RS3), U5.36 (I/O)
/MAP_~CS: U1.4 (~CS), U5.41 (I/O)
/MAP_~ME: U1.21 (~ME), U5.44 (I/O)
/MAP_~MM: U1.13 (~MM), U5.45 (I/O)
/MAP_~STROBE: U1.5 (~STROBE), U5.46 (I/O)
/RECOV: J3.2, U5.88 (INPUT/OE1)
/TCK: J4.6, U3.13 (ADBUS0), U5.62 (I/O/TCK)
/TDI: J4.7, U3.14 (ADBUS1), U5.4 (I/O/TDI)
/TDO: J4.8, U3.15 (ADBUS2), U5.73 (I/O/TDO)
/TMS: J4.9, U3.16 (ADBUS3), U5.15 (I/O/TMS)
/XCSI: U3.1 (XCSI), Y2.3 (OUT)
/~BUSACK: U2.23 (~BUSACK), U5.29 (I/O)
/~BUSREQ: U2.25 (~BUSREQ), U5.31 (I/O)
/~BUS_CPU_ACK: J1.B74 (~CPU_ACK), U5.92 (I/O)
/~BUS_CPU_INT: J1.B75 (~CPU_INT0), J1.B76 (~CPU_INT1), J1.B77 (~CPU_INT2), J1.B78 (~CPU_INT3), U5.94 (I/O)
/~BUS_CPU_NMI: J1.B79 (~CPU_NMI0), J1.B80 (~CPU_NMI1), U5.93 (I/O)
/~BUS_DMA_GNT: J1.B73 (~DMA_GNT), U5.68 (I/O)
/~BUS_DMA_REQ: J1.B71 (~DMA_REQ), U5.69 (I/O)
/~BUS_IORQ: J1.B82 (~IORQ), U5.98 (I/O)
/~BUS_MREQ: J1.B81 (~MREQ), U5.65 (I/O)
/~BUS_READY: J1.A73 (~READY), U5.97 (I/O)
/~BUS_RESET: J1.A74 (~RESET), U5.89 (INPUT/GCLR)
/~INT: U2.16 (~INT), U5.42 (I/O/PD2)
/~IORQ: U2.20 (~IORQ), U5.20 (I/O)
/~M1: U2.27 (~M1), U5.33 (I/O)
/~MREQ: U2.19 (~MREQ), U5.19 (I/O)
/~NMI: U2.17 (~NMI), U5.17 (I/O)
/~RD: U2.21 (~RD), U5.23 (I/O)
/~RESET: U2.26 (~RESET), U5.32 (I/O)
/~WAIT: U2.24 (~WAIT), U5.30 (I/O)
/~WR: U2.22 (~WR), U5.21 (I/O)
GND: C1.2, C2.2, C3.2, C4.2, C5.2, C6.2, C7.2, C8.2, C9.2, C10.2, C11.2, C12.2, C13.2, C14.2, C15.2, C16.2, C17.2, C18.2, C25.2, C27.2, C29.2, C30.2, J1.A1 (~VIO_5V), J1.A4 (GND), J1.A5 (GND), J1.A6 (GND), J1.A11 (~SLOT_PRSNT), J1.A12 (GND), J1.A15 (GND), J1.A18 (GND), J1.A23 (GND), J1.A24 (GND), J1.A27 (GND), J1.A28 (GND), J1.A30 (GND), J1.A34 (GND), J1.A37 (GND), J1.A38 (GND), J1.A41 (GND), J1.A42 (GND), J1.A45 (GND), J1.A46 (GND), J1.A50 (GND), J1.A51 (GND), J1.A54 (GND), J1.A55 (GND), J1.A58 (GND), J1.A59 (GND), J1.A62 (GND), J1.A63 (GND), J1.A66 (GND), J1.A67 (GND), J1.A70 (GND), J1.A71 (GND), J1.B4 (GND), J1.B7 (GND), J1.B8 (GND), J1.B11 (GND), J1.B13 (GND), J1.B16 (GND), J1.B21 (GND), J1.B22 (GND), J1.B25 (GND), J1.B26 (GND), J1.B29 (GND), J1.B32 (GND), J1.B35 (GND), J1.B36 (GND), J1.B39 (GND), J1.B40 (GND), J1.B43 (GND), J1.B44 (GND), J1.B47 (GND), J1.B48 (GND), J1.B52 (GND), J1.B53 (GND), J1.B56 (GND), J1.B57 (GND), J1.B60 (GND), J1.B61 (GND), J1.B64 (GND), J1.B65 (GND), J1.B68 (GND), J1.B69 (GND), J1.B72 (GND), J2.A1 (GND_A), J2.A12 (GND_A__1), J2.B1 (GND_B), J2.B12 (GND_B__1), J2.SH1 (SHIELD), J2.SH2 (SHIELD__1), J2.SH3 (SHIELD__2), J2.SH4 (SHIELD__3), J4.10, R2.2, R3.1, R4.2, U1.6 (R/~W), U1.20 (GND), U2.29 (GND), U3.4 (AGND), U3.9 (AGND), U3.10 (GND), U3.11 (GND), U3.22 (GND), U3.23 (GND), U3.35 (GND), U3.36 (GND), U3.41 (AGND), U3.42 (TEST), U3.47 (GND), U3.48 (GND), U4.2 (VSS), U5.11 (GND), U5.26 (GND), U5.38 (GND), U5.43 (GND), U5.59 (GND), U5.74 (GND), U5.86 (GND), U5.95 (GND), U7.7 (GND), U7.8 (SHDN), U11.1 (A0), U11.2 (A1), U11.3 (A2), U11.4 (VSS), U11.7 (WP), Y1.4 (CASE_GND), Y2.2 (GND)
unnamed: J2.A5 (CC1), R2.1
unnamed: J2.B5 (CC2), R3.2
unnamed: J3.1, R6.1
unnamed: R4.1, U3.5 (REF)
unnamed: C16.1, U3.37 (VCCA)
unnamed: C15.1, U3.38 (VCCCORE)
unnamed: C1.1, FB1.1, U3.3 (VPHY)
unnamed: C2.1, FB2.2, U3.8 (VPLL)
unnamed: R1.1, U3.34 (~RESET)
unnamed: R5.1, U4.1 (DO)
unnamed: C26.1, U7.2 (C1+)
unnamed: C26.2, U7.1 (C1-)
unnamed: C28.1, U7.4 (C2+)
unnamed: C28.2, U7.3 (C2-)
VCCD: C3.1, C4.1, C5.1, FB1.2, FB2.1, R1.2, U3.12 (VCCIO), U3.24 (VCCIO), U3.39 (VCCD), U3.46 (VCCIO), U4.6 (VCC), Y2.4 (VDD)

Notes on the sheet:
As an option, populate J4 instead of the whole onboard programmer and use JTAG programmer.
If banking is required, program the 74LS612N this way 1- Output to port 0 with the register to program (RS0..RS3) This will be a page # 2- Output to port 1 with the D8..D11 bits of the register value 3- Output to port 2 with the D0..D7 bits of the register value This value (D0..D11) will be copied 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
There are only 1 INT and 1 NMI on Z80, all CPU_INTX and CPU_NMI are tied to the 1 INT and 1 NMI
Dual Diodes to power the CPLD only from USB OR from the +5V from the backplane This is to allow programming the CPLD from USB without powering the rest of the Host board
Charge Pump to generate +12V
Sense Pins Connected (logic 1) /VIO_5V == 1 --> Logic 5V /SLOT_PRSNT == 1 --> Always connected
Device Descriptor EEPROM
MO8..MO11 tied to A12..A15 on the output bus so that in passthrough mode, we have a normal 16-bits bus A0..A15. On the 74LS612N, in passthrough mode, MA0..MA3 gets mapped to MO8..MO11 instead of MO0..MO4. If MO8..MO11 is tied to A20..A23, passthrough would have A0..A11 normal, but the A12..A15 woul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
EEPROM for FT232H Config
Edge Connector
USB --> JTAG Onboard Programmer (optional)
Power and Decoupling
JTAG Recovery Close Jumper and Apply 12V during programing
CPU / HOST Bus Bridge
Z80 CPU and Memory Mapping

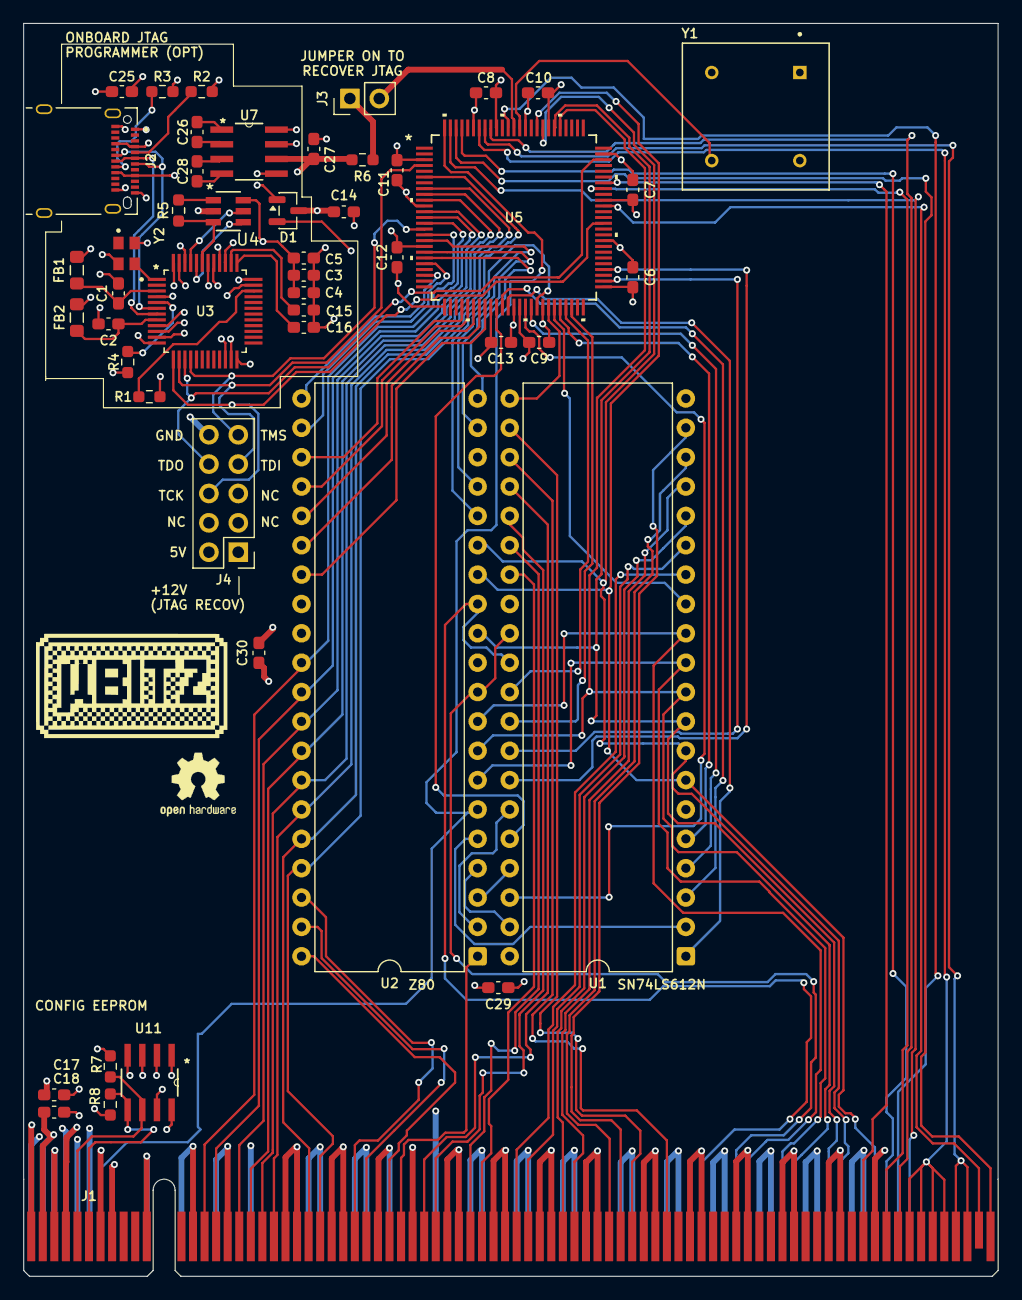
[picture p26: board uBITz-Host-z80-Host.kicad_pcb from above]

Board: 4 copper layers, 84.3 x 108.4 mm, 48 parts (0 on the bottom side), 104 nets.
