dumaiss/uBITz/uBITz Platform Code/Bank/Schem/uBITz-Bank-Reference-Impl/04-Basic-Bank-With-Cartridge/uBITz-Basic-Bank-With-Cartridge/uBITz-Basic-Bank-With-Cartridge.kicad_pcb

## KiCad design uBITz Platform Code/Bank/Schem/uBITz-Bank-Reference-Impl/04-Basic-Bank-With-Cartridge/uBITz-Basic-Bank-With-Cartridge/uBITz-Basic-Bank-With-Cartridge.kicad_pcb (2026-01-09)

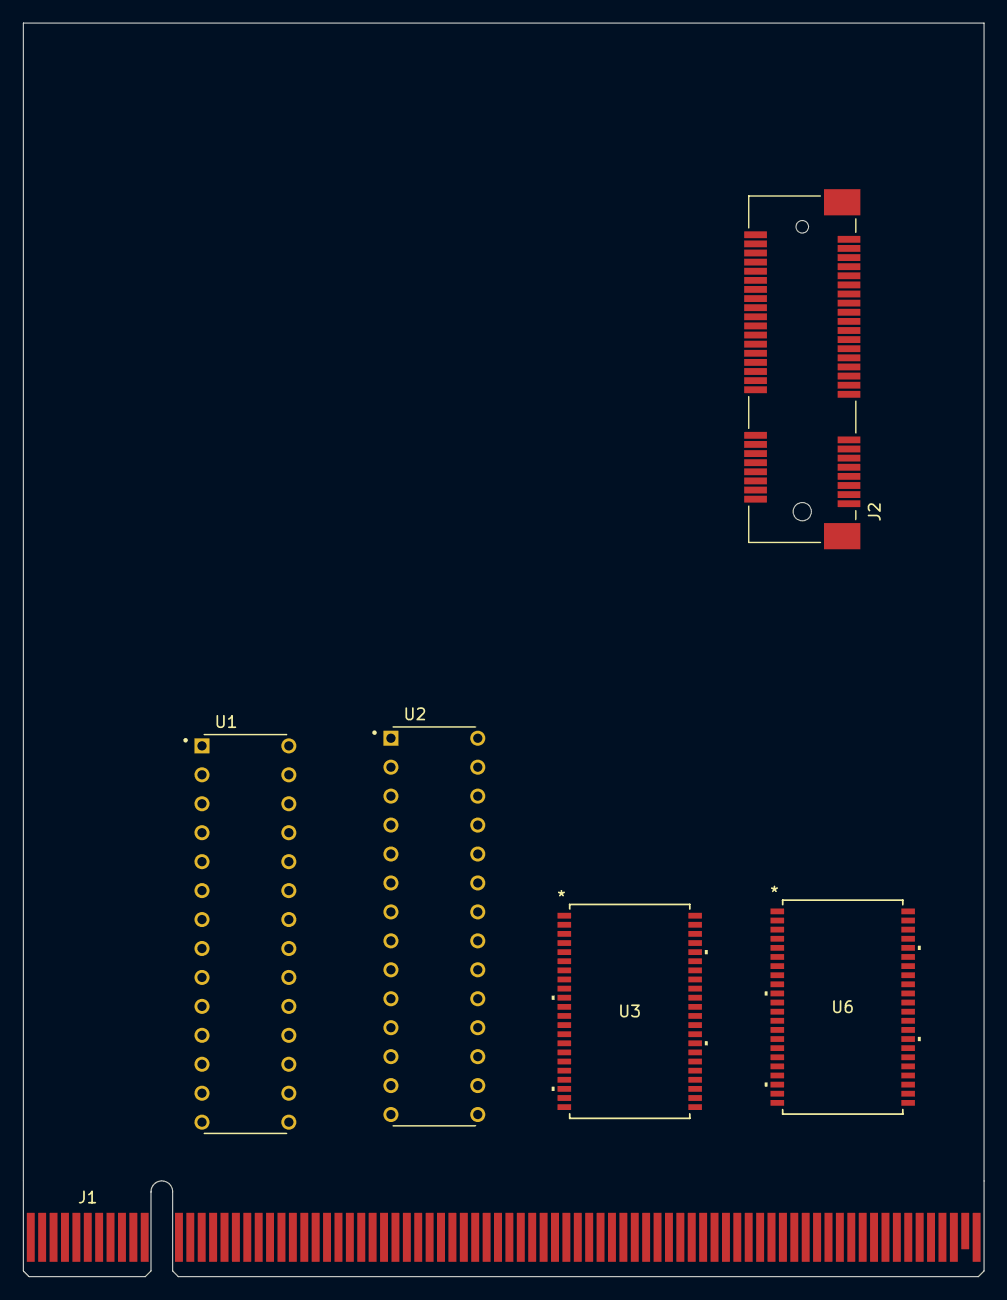
[picture p27: board uBITz-Basic-Bank-With-Cartridge.kicad_pcb from above]

Board: 4 copper layers, 84.3 x 110.0 mm, 6 parts (0 on the bottom side), 37 nets, no tracks yet.

Parts:
J1: BUS_PCIexpress_x16
J2: uBITz-Bank-Cartridge; BUS_PCI_Express_Mini_Full
U1, U2: AT28C256-15PU; DIP762W48P254L3467H406Q28
U3, U6: AS7C34096A-10TIN; TSOP-44_18P52X11P94_ALL

Connections:
+5V: J1.A2 (+5V_MAIN), J1.A3 (+5V_MAIN), J1.B1 (+5V_MAIN), J1.B2 (+5V_MAIN), J1.B3 (+5V_MAIN), U1.28 (VCC), U2.28 (VCC), U3.11 (VCC), U3.33 (VCC), U6.11 (VCC), U6.33 (VCC)
/A0: J1.B14 (A0), U1.10 (A0), U2.10 (A0), U3.3 (A0), U6.3 (A0)
/A1: J1.B15 (A1), U1.9 (A1), U2.9 (A1), U3.4 (A1), U6.4 (A1)
/A2: J1.B17 (A2), U1.8 (A2), U2.8 (A2), U3.5 (A2), U6.5 (A2)
/A3: J1.B18 (A3), U1.7 (A3), U2.7 (A3), U3.6 (A3), U6.6 (A3)
/A4: J1.B19 (A4), U1.6 (A4), U2.6 (A4), U3.7 (A4), U6.7 (A4)
/A5: J1.B20 (A5), U1.5 (A5), U2.5 (A5), U3.16 (A5), U6.16 (A5)
/A6: J1.B23 (A6), U1.4 (A6), U2.4 (A6), U3.17 (A6), U6.17 (A6)
/A7: J1.B24 (A7), U1.3 (A7), U2.3 (A7), U3.18 (A7), U6.18 (A7)
/A8: J1.B27 (A8), U1.25 (A8), U2.25 (A8), U3.19 (A8), U6.19 (A8)
/A9: J1.B28 (A9), U1.24 (A9), U2.24 (A9), U3.20 (A9), U6.20 (A9)
/A10: J1.B30 (A10), U1.21 (A10), U2.21 (A10), U3.26 (A10), U6.26 (A10)
/A11: J1.B31 (A11), U1.23 (A11), U2.23 (A11), U3.27 (A11), U6.27 (A11)
/A12: J1.B33 (A12), U1.2 (A12), U2.2 (A12), U3.28 (A12), U6.28 (A12)
/A13: J1.B34 (A13), U1.26 (A13), U2.26 (A13), U3.29 (A13), U6.29 (A13)
/A14: J1.B37 (A14), U1.1 (A14), U2.1 (A14), U3.30 (A14), U6.30 (A14)
/A15: J1.B38 (A15), U3.38 (A15), U6.38 (A15)
/A16: J1.B41 (A16), U3.39 (A16), U6.39 (A16)
/A17: J1.B42 (A17), U3.40 (A17), U6.40 (A17)
/A18: J1.B45 (A18), U3.41 (A18), U6.41 (A18)
/D0: J1.A72 (D0), U2.11 (I/O0), U6.9 (I/O1)
/D1: J1.A69 (D1), U2.12 (I/O1), U6.10 (I/O2)
/D2: J1.A68 (D2), U2.13 (I/O2), U6.13 (I/O3)
/D3: J1.A65 (D3), U2.15 (I/O3), U6.14 (I/O4)
/D4: J1.A64 (D4), U2.19 (I/O7), U6.31 (I/O5)
/D5: J1.A61 (D5), U2.18 (I/O6), U6.32 (I/O6)
/D6: J1.A60 (D6), U2.17 (I/O5), U6.35 (I/O7)
/D7: J1.A57 (D7), U2.16 (I/O4), U6.36 (I/O8)
/D8: U1.11 (I/O0), U3.9 (I/O1)
/D9: U1.12 (I/O1), U3.10 (I/O2)
/D10: U1.13 (I/O2), U3.13 (I/O3)
/D11: U1.15 (I/O3), U3.14 (I/O4)
/D12: U1.19 (I/O7), U3.31 (I/O5)
/D13: U1.18 (I/O6), U3.32 (I/O6)
/D14: U1.17 (I/O5), U3.35 (I/O7)
/D15: U1.16 (I/O4), U3.36 (I/O8)
GND: J1.A1 (~DRV5V), J1.A4 (GND), J1.A5 (GND), J1.A6 (GND), J1.A11 (~SENS3V), J1.A12 (GND), J1.A15 (GND), J1.A18 (GND), J1.A23 (GND), J1.A24 (GND), J1.A27 (GND), J1.A28 (GND), J1.A30 (GND), J1.A34 (GND), J1.A37 (GND), J1.A38 (GND), J1.A41 (GND), J1.A42 (GND), J1.A45 (GND), J1.A46 (GND), J1.A50 (GND), J1.A51 (GND), J1.A54 (GND), J1.A55 (GND), J1.A58 (GND), J1.A59 (GND), J1.A62 (GND), J1.A63 (GND), J1.A66 (GND), J1.A67 (GND), J1.A70 (GND), J1.A71 (GND), J1.B4 (GND), J1.B7 (GND), J1.B8 (GND), J1.B11 (GND), J1.B13 (GND), J1.B16 (GND), J1.B21 (GND), J1.B22 (GND), J1.B25 (GND), J1.B26 (GND), J1.B29 (GND), J1.B32 (GND), J1.B35 (GND), J1.B36 (GND), J1.B39 (GND), J1.B40 (GND), J1.B43 (GND), J1.B44 (GND), J1.B47 (GND), J1.B48 (GND), J1.B52 (GND), J1.B53 (GND), J1.B56 (GND), J1.B57 (GND), J1.B60 (GND), J1.B61 (GND), J1.B64 (GND), J1.B65 (GND), J1.B68 (GND), J1.B69 (GND), J1.B72 (GND), U1.14 (GND), U2.14 (GND), U3.12 (GND), U3.34 (GND), U6.12 (GND), U6.34 (GND)
