dumaiss/uBITz/uBITz Platform Code/Host/Schem/uBITz-Host-Reference-Impl/05-6309-Based-Host/uBITz-Host-6309-Host/uBITz-Host-6309-Host.kicad_pcb

## KiCad design uBITz Platform Code/Host/Schem/uBITz-Host-Reference-Impl/05-6309-Based-Host/uBITz-Host-6309-Host/uBITz-Host-6309-Host.kicad_pcb (2026-01-05)

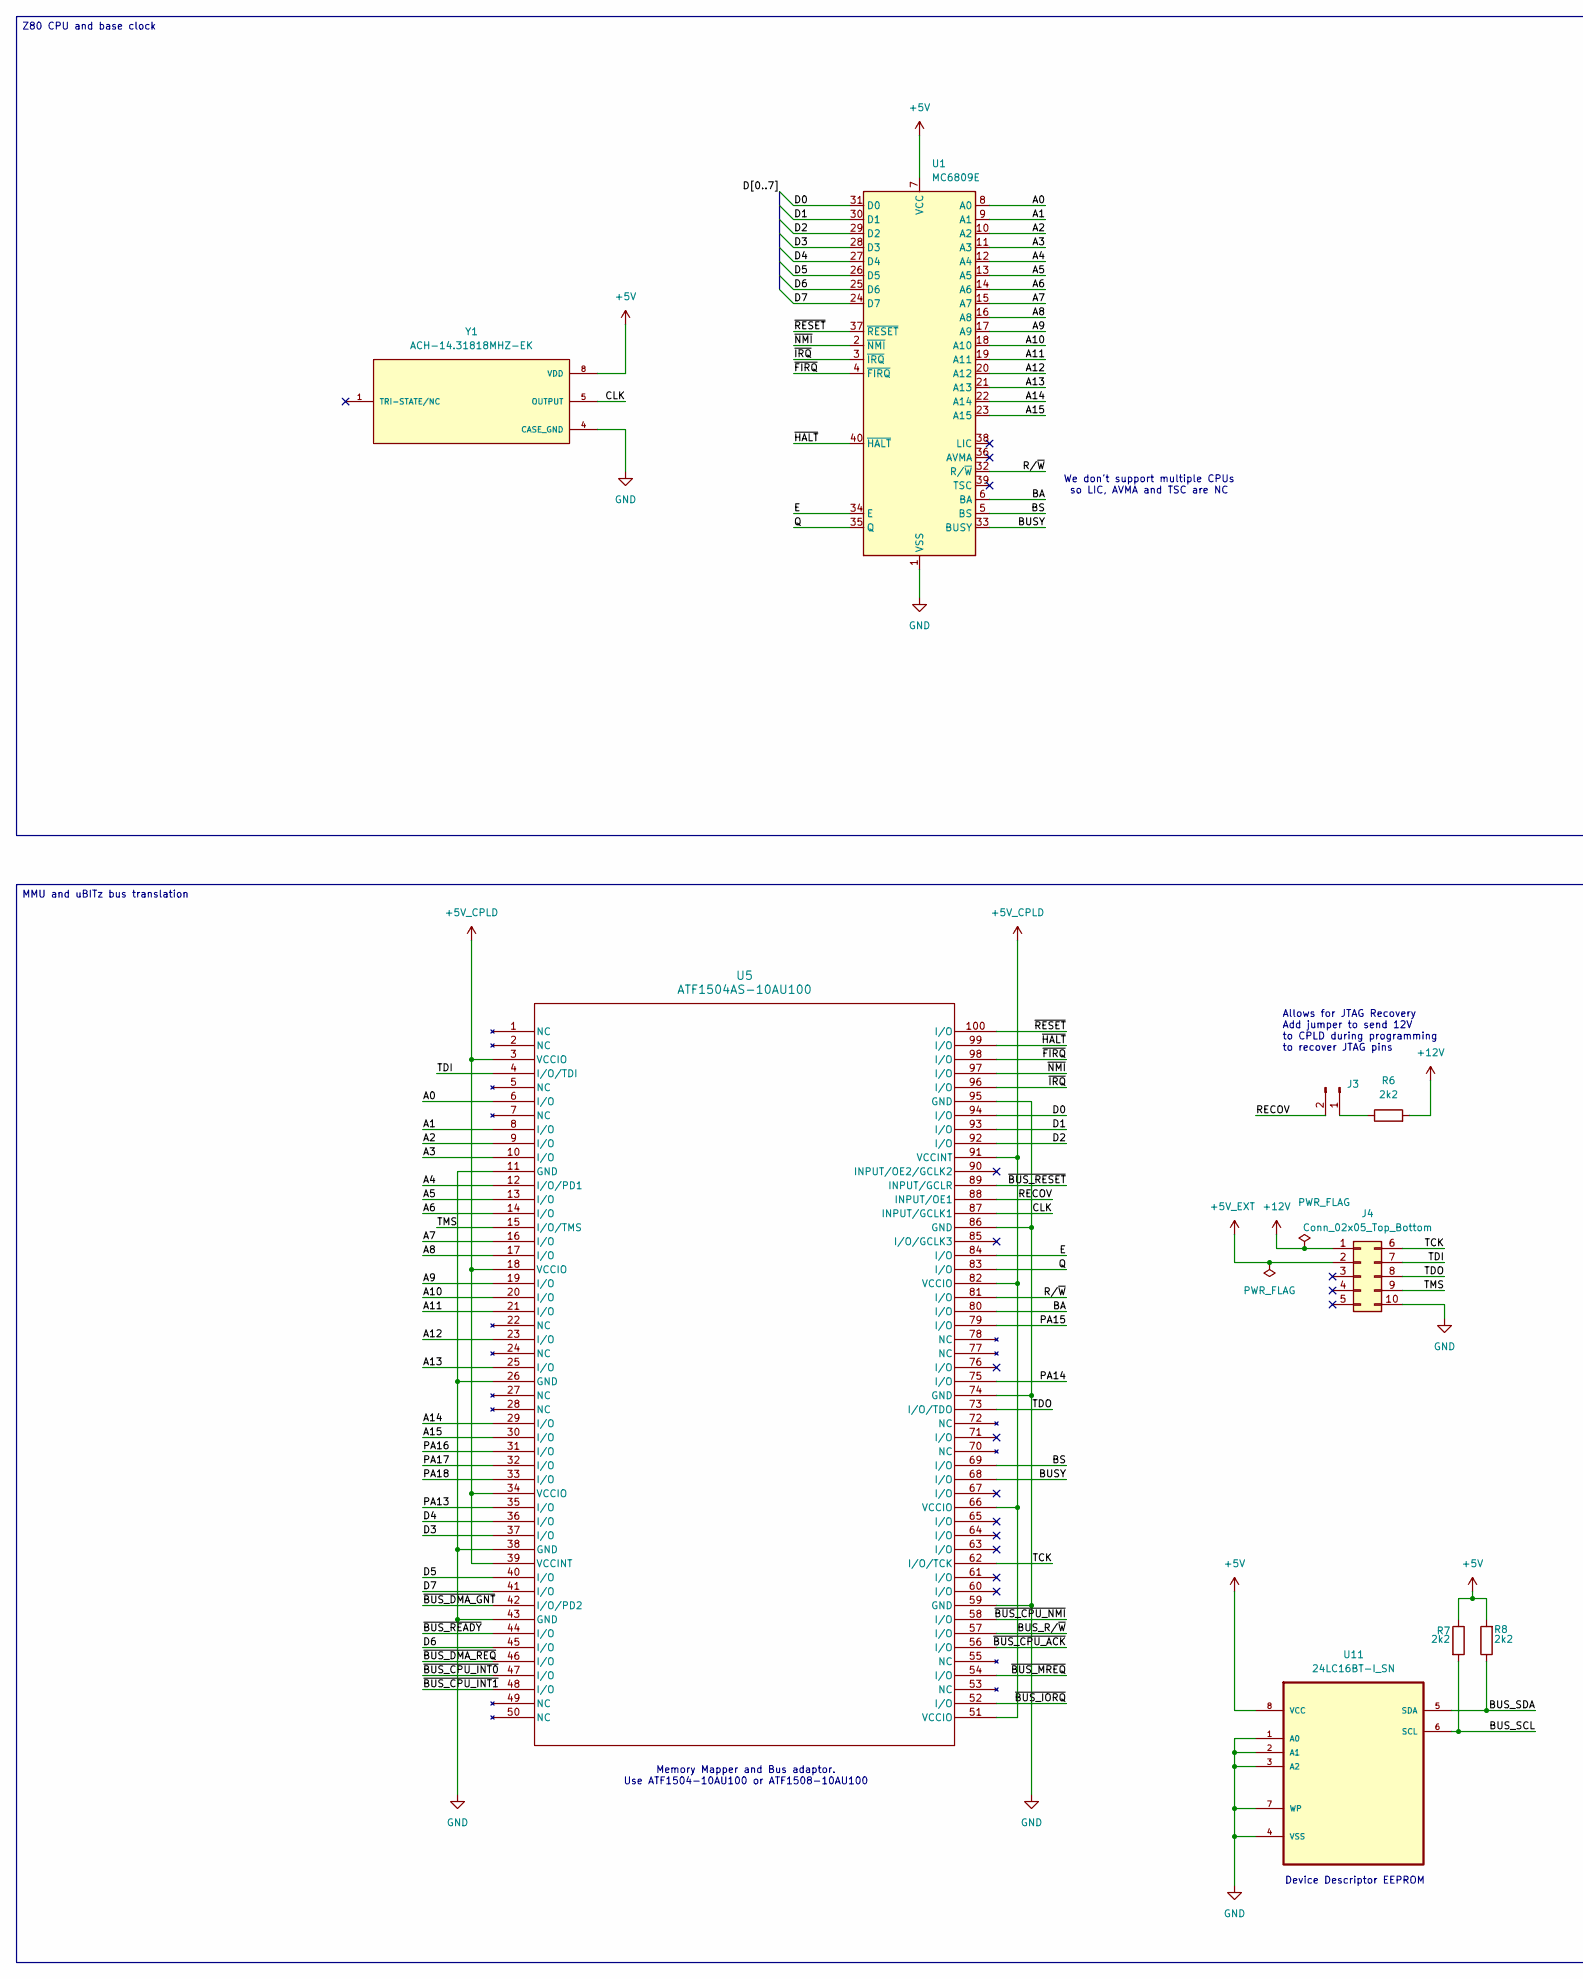
[picture p28: schematic uBITz-Host-6309-Host.kicad_sch, part in row 1, column 1]

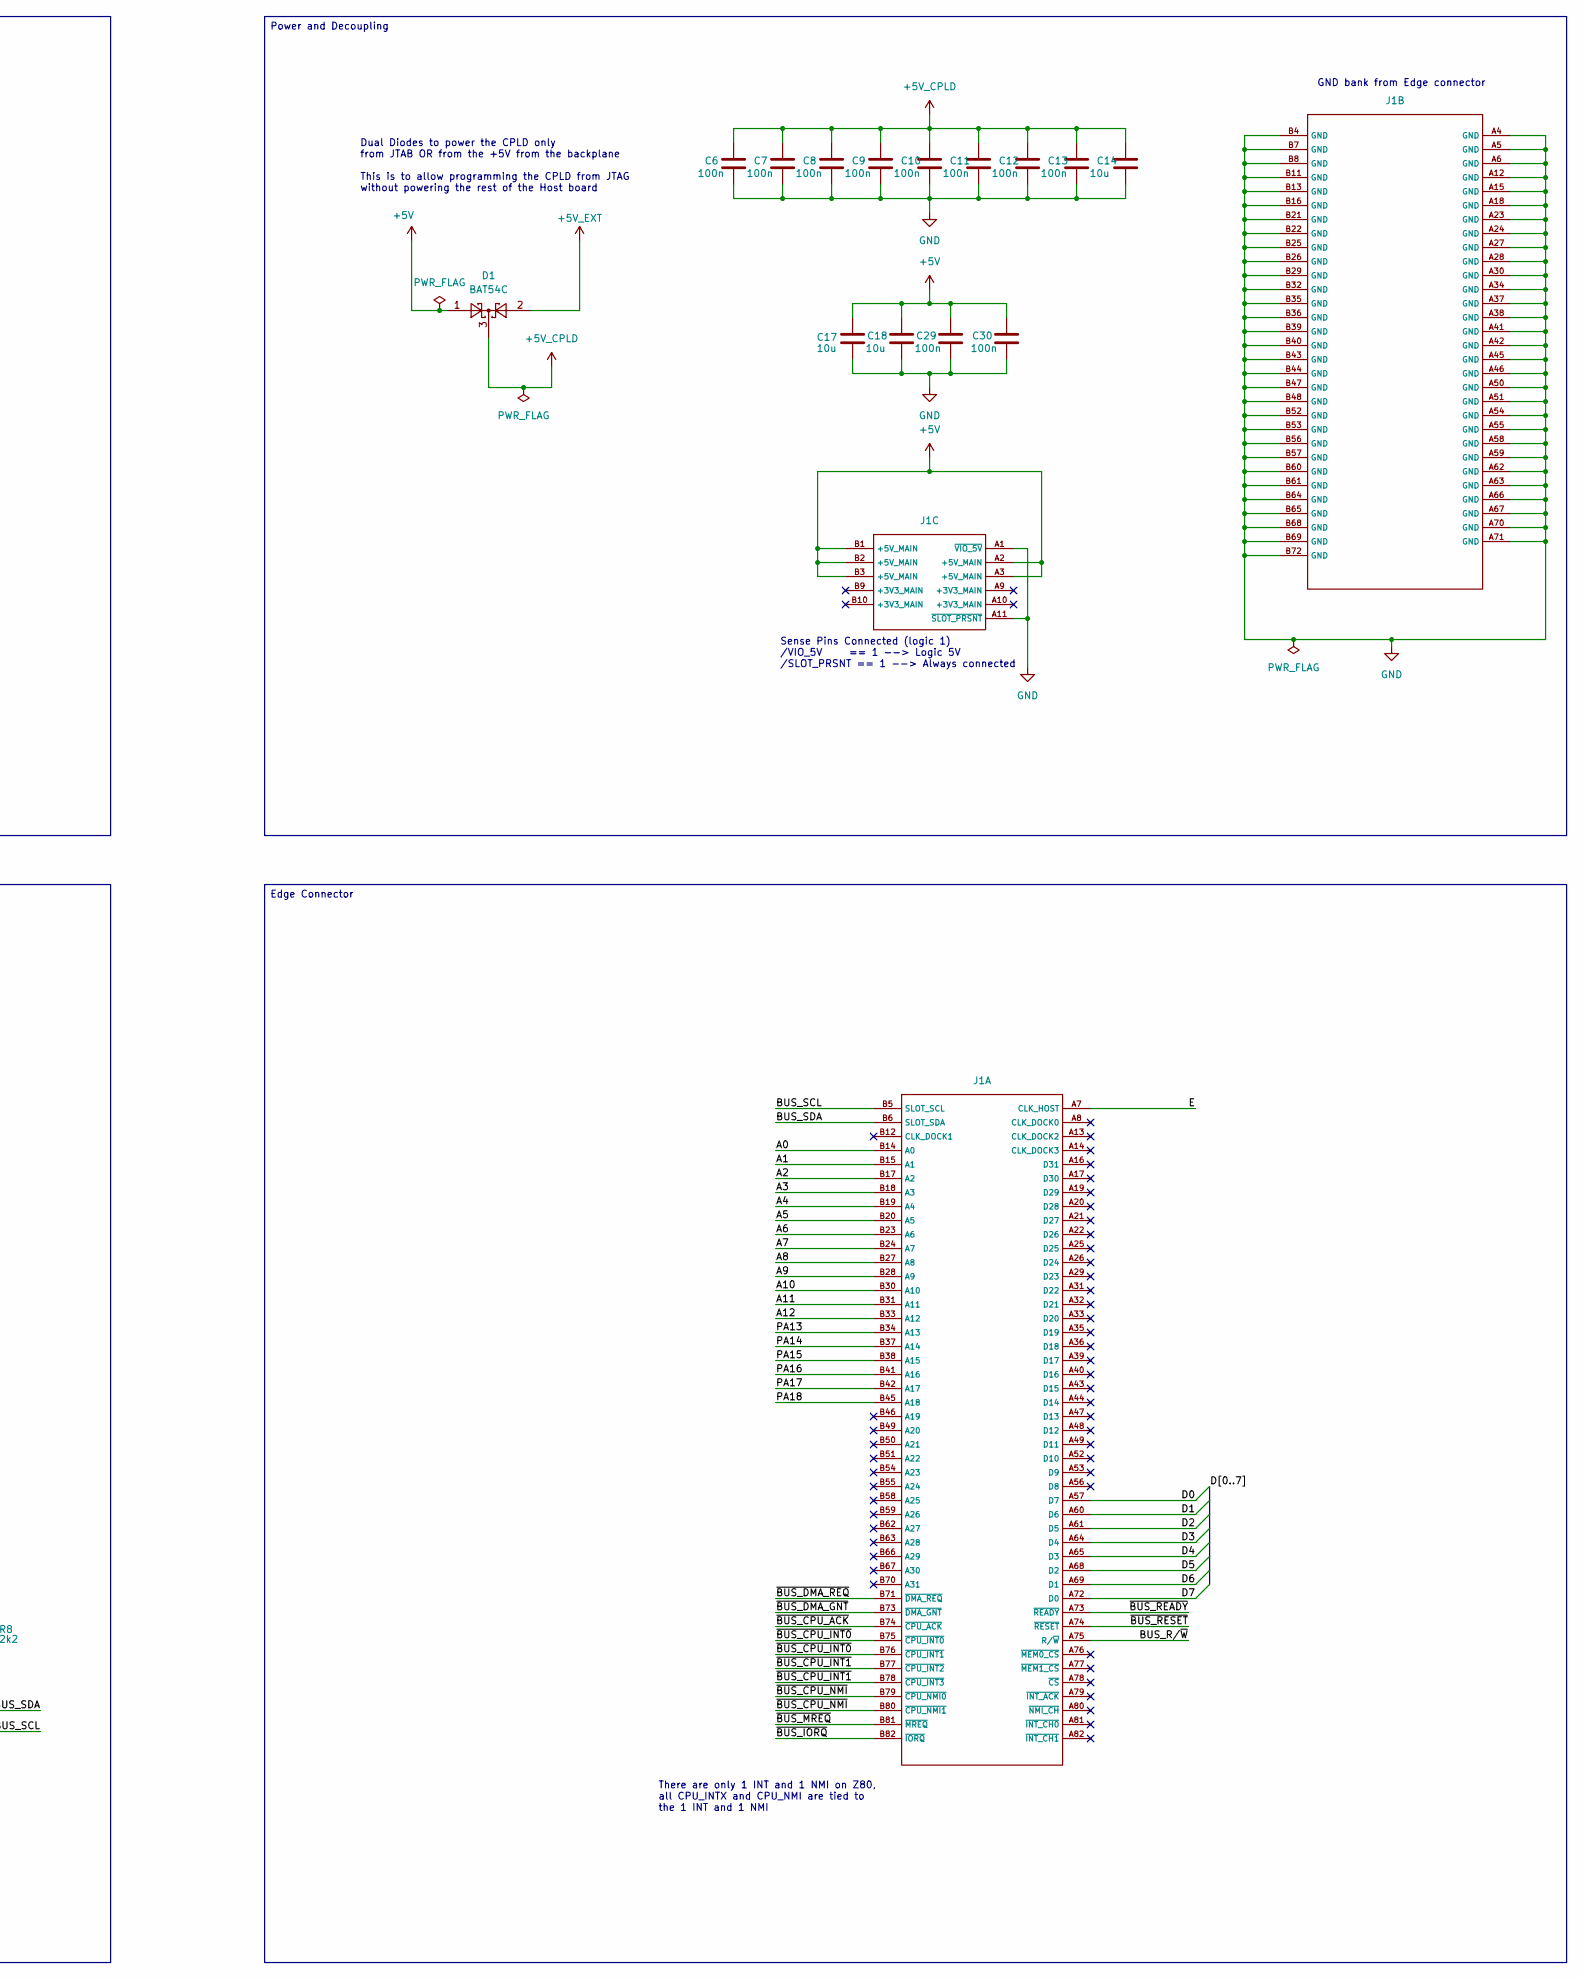
[picture p29: schematic uBITz-Host-6309-Host.kicad_sch, part in row 1, column 2]

Parts:
C6, C7, C8, C9, C10, C11, C12, C13, C29, C30: 100n; C_0603_1608Metric_Pad1.08x0.95mm_HandSolder
C14, C17, C18: 10u; C_0603_1608Metric_Pad1.08x0.95mm_HandSolder
D1: BAT54C; SOT-23
J1: BUS_PCIexpress_x16
J3: Conn_01x02_Pin; PinHeader_1x02_P2.54mm_Vertical
J4: Conn_02x05_Top_Bottom; PinHeader_2x05_P2.54mm_Vertical
R6, R7, R8: 2k2; R_0603_1608Metric_Pad0.98x0.95mm_HandSolder
U1: MC6809E; DIP-40_W15.24mm
U5: ATF1504AS-10AU100; 100A_ATM
U11: 24LC16BT-I_SN; SOIC127P600X175-8N; MPN 24LC16BT-I/SN
Y1: ACH-14.31818MHZ-EK; XTAL_ACH-14.31818MHZ-EK; PARTREV 11.15.2016

Connections:
+5V: C17.1, C18.1, C29.1, C30.1, D1.1, J1.A2 (+5V_MAIN), J1.A3 (+5V_MAIN), J1.B1 (+5V_MAIN), J1.B2 (+5V_MAIN), J1.B3 (+5V_MAIN), R7.1, R8.2, U1.7 (VCC), U11.8 (VCC), Y1.8 (VDD)
+5V_CPLD: C6.1, C7.1, C8.1, C9.1, C10.1, C11.1, C12.1, C13.1, C14.1, D1.3, U5.3 (VCCIO), U5.18 (VCCIO), U5.34 (VCCIO), U5.39 (VCCINT), U5.51 (VCCIO), U5.66 (VCCIO), U5.82 (VCCIO), U5.91 (VCCINT)
+5V_EXT: D1.2, J4.2
+12V: J4.1, R6.2
/A0: J1.B14 (A0), U1.8 (A0), U5.6 (I/O)
/A1: J1.B15 (A1), U1.9 (A1), U5.8 (I/O)
/A2: J1.B17 (A2), U1.10 (A2), U5.9 (I/O)
/A3: J1.B18 (A3), U1.11 (A3), U5.10 (I/O)
/A4: J1.B19 (A4), U1.12 (A4), U5.12 (I/O/PD1)
/A5: J1.B20 (A5), U1.13 (A5), U5.13 (I/O)
/A6: J1.B23 (A6), U1.14 (A6), U5.14 (I/O)
/A7: J1.B24 (A7), U1.15 (A7), U5.16 (I/O)
/A8: J1.B27 (A8), U1.16 (A8), U5.17 (I/O)
/A9: J1.B28 (A9), U1.17 (A9), U5.19 (I/O)
/A10: J1.B30 (A10), U1.18 (A10), U5.20 (I/O)
/A11: J1.B31 (A11), U1.19 (A11), U5.21 (I/O)
/A12: J1.B33 (A12), U1.20 (A12), U5.23 (I/O)
/A13: U1.21 (A13), U5.25 (I/O)
/A14: U1.22 (A14), U5.29 (I/O)
/A15: U1.23 (A15), U5.30 (I/O)
/BA: U1.6 (BA), U5.80 (I/O)
/BS: U1.5 (BS), U5.69 (I/O)
/BUSY: U1.33 (BUSY), U5.68 (I/O)
/BUS_R/~W: J1.A75 (R/~W), U5.57 (I/O)
/BUS_SCL: J1.B5 (SLOT_SCL), R7.2, U11.6 (SCL)
/BUS_SDA: J1.B6 (SLOT_SDA), R8.1, U11.5 (SDA)
/CLK: U5.87 (INPUT/GCLK1), Y1.5 (OUTPUT)
/D0: J1.A57 (D7), U1.31 (D0), U5.94 (I/O)
/D1: J1.A60 (D6), U1.30 (D1), U5.93 (I/O)
/D2: J1.A61 (D5), U1.29 (D2), U5.92 (I/O)
/D3: J1.A64 (D4), U1.28 (D3), U5.37 (I/O)
/D4: J1.A65 (D3), U1.27 (D4), U5.36 (I/O)
/D5: J1.A68 (D2), U1.26 (D5), U5.40 (I/O)
/D6: J1.A69 (D1), U1.25 (D6), U5.45 (I/O)
/D7: J1.A72 (D0), U1.24 (D7), U5.41 (I/O)
/E: J1.A7 (CLK_HOST), U1.34 (E), U5.84 (I/O)
/PA13: J1.B34 (A13), U5.35 (I/O)
/PA14: J1.B37 (A14), U5.75 (I/O)
/PA15: J1.B38 (A15), U5.79 (I/O)
/PA16: J1.B41 (A16), U5.31 (I/O)
/PA17: J1.B42 (A17), U5.32 (I/O)
/PA18: J1.B45 (A18), U5.33 (I/O)
/Q: U1.35 (Q), U5.83 (I/O)
/RECOV: J3.2, U5.88 (INPUT/OE1)
/R/~W: U1.32 (R/~W), U5.81 (I/O)
/TCK: J4.6, U5.62 (I/O/TCK)
/TDI: J4.7, U5.4 (I/O/TDI)
/TDO: J4.8, U5.73 (I/O/TDO)
/TMS: J4.9, U5.15 (I/O/TMS)
/~BUS_CPU_ACK: J1.B74 (~CPU_ACK), U5.56 (I/O)
/~BUS_CPU_INT0: J1.B75 (~CPU_INT0), J1.B76 (~CPU_INT1), U5.47 (I/O)
/~BUS_CPU_INT1: J1.B77 (~CPU_INT2), J1.B78 (~CPU_INT3), U5.48 (I/O)
/~BUS_CPU_NMI: J1.B79 (~CPU_NMI0), J1.B80 (~CPU_NMI1), U5.58 (I/O)
/~BUS_DMA_GNT: J1.B73 (~DMA_GNT), U5.42 (I/O/PD2)
/~BUS_DMA_REQ: J1.B71 (~DMA_REQ), U5.46 (I/O)
/~BUS_IORQ: J1.B82 (~IORQ), U5.52 (I/O)
/~BUS_MREQ: J1.B81 (~MREQ), U5.54 (I/O)
/~BUS_READY: J1.A73 (~READY), U5.44 (I/O)
/~BUS_RESET: J1.A74 (~RESET), U5.89 (INPUT/GCLR)
/~FIRQ: U1.4 (~FIRQ), U5.98 (I/O)
/~HALT: U1.40 (~HALT), U5.99 (I/O)
/~IRQ: U1.3 (~IRQ), U5.96 (I/O)
/~NMI: U1.2 (~NMI), U5.97 (I/O)
/~RESET: U1.37 (~RESET), U5.100 (I/O)
GND: C6.2, C7.2, C8.2, C9.2, C10.2, C11.2, C12.2, C13.2, C14.2, C17.2, C18.2, C29.2, C30.2, J1.A1 (~VIO_5V), J1.A4 (GND), J1.A5 (GND), J1.A6 (GND), J1.A11 (~SLOT_PRSNT), J1.A12 (GND), J1.A15 (GND), J1.A18 (GND), J1.A23 (GND), J1.A24 (GND), J1.A27 (GND), J1.A28 (GND), J1.A30 (GND), J1.A34 (GND), J1.A37 (GND), J1.A38 (GND), J1.A41 (GND), J1.A42 (GND), J1.A45 (GND), J1.A46 (GND), J1.A50 (GND), J1.A51 (GND), J1.A54 (GND), J1.A55 (GND), J1.A58 (GND), J1.A59 (GND), J1.A62 (GND), J1.A63 (GND), J1.A66 (GND), J1.A67 (GND), J1.A70 (GND), J1.A71 (GND), J1.B4 (GND), J1.B7 (GND), J1.B8 (GND), J1.B11 (GND), J1.B13 (GND), J1.B16 (GND), J1.B21 (GND), J1.B22 (GND), J1.B25 (GND), J1.B26 (GND), J1.B29 (GND), J1.B32 (GND), J1.B35 (GND), J1.B36 (GND), J1.B39 (GND), J1.B40 (GND), J1.B43 (GND), J1.B44 (GND), J1.B47 (GND), J1.B48 (GND), J1.B52 (GND), J1.B53 (GND), J1.B56 (GND), J1.B57 (GND), J1.B60 (GND), J1.B61 (GND), J1.B64 (GND), J1.B65 (GND), J1.B68 (GND), J1.B69 (GND), J1.B72 (GND), J4.10, U1.1 (VSS), U5.11 (GND), U5.26 (GND), U5.38 (GND), U5.43 (GND), U5.59 (GND), U5.74 (GND), U5.86 (GND), U5.95 (GND), U11.1 (A0), U11.2 (A1), U11.3 (A2), U11.4 (VSS), U11.7 (WP), Y1.4 (CASE_GND)
unnamed: J3.1, R6.1

Notes on the sheet:
Memory Mapper and Bus adaptor. Use ATF1504-10AU100 or ATF1508-10AU100
GND bank from Edge connector
Sense Pins Connected (logic 1) /VIO_5V == 1 --> Logic 5V /SLOT_PRSNT == 1 --> Always connected
There are only 1 INT and 1 NMI on Z80, all CPU_INTX and CPU_NMI are tied to the 1 INT and 1 NMI
Dual Diodes to power the CPLD only from JTAB OR from the +5V from the backplane This is to allow programming the CPLD from JTAG without powering the rest of the Host board
We don't support multiple CPUs so LIC, AVMA and TSC are NC
Device Descriptor EEPROM
Allows for JTAG Recovery Add jumper to send 12V to CPLD during programming to recover JTAG pins
Power and Decoupling
MMU and uBITz bus translation
Z80 CPU and base clock
Edge Connector

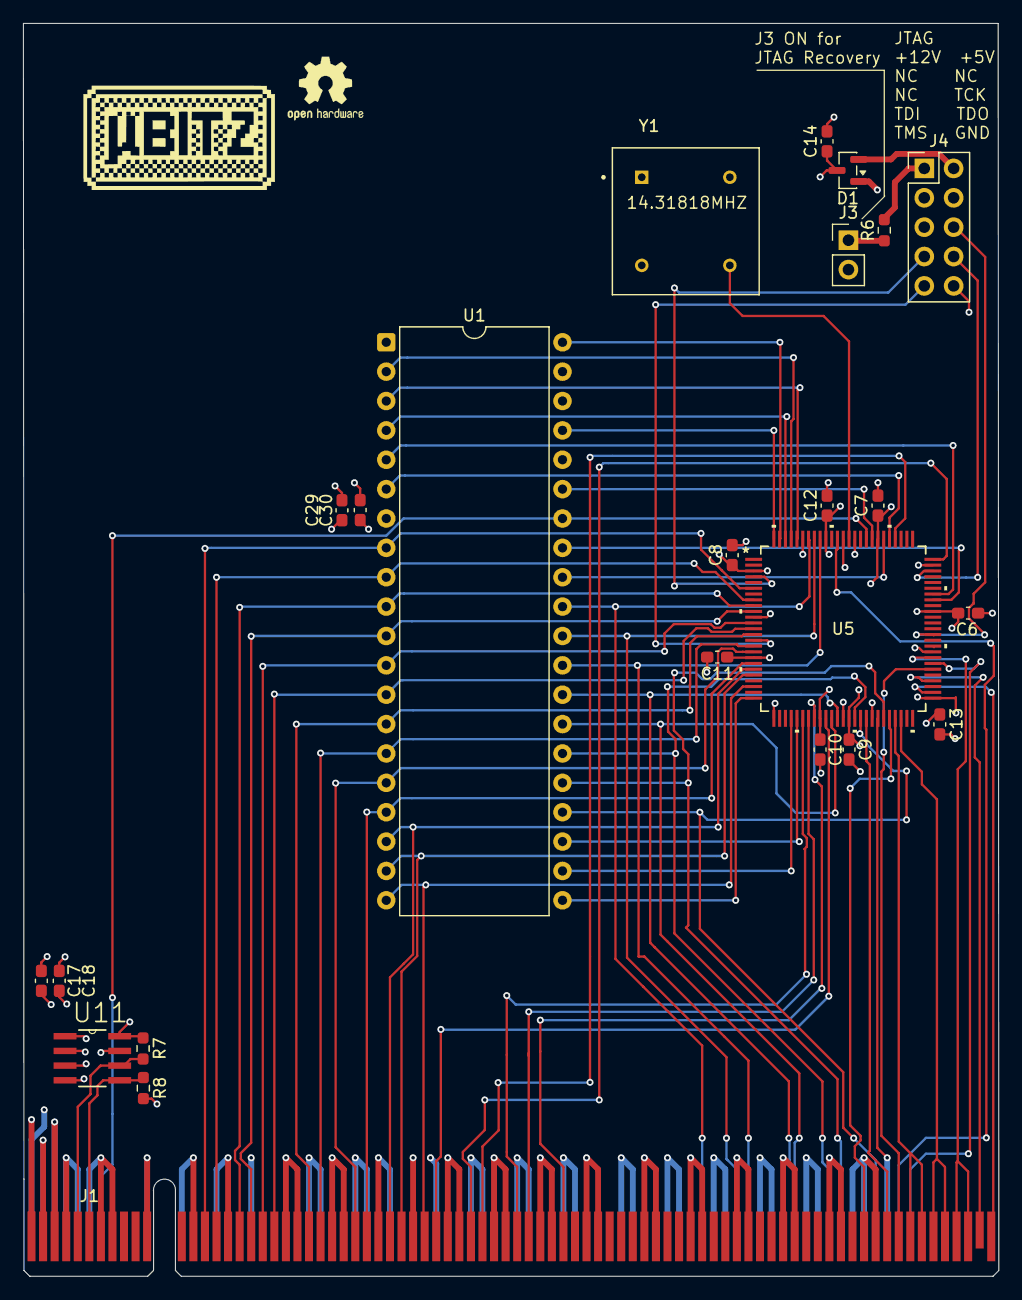
[picture p30: board uBITz-Host-6309-Host.kicad_pcb from above]

Board: 4 copper layers, 84.3 x 108.3 mm, 24 parts (0 on the bottom side), 66 nets.
