dumaiss/uBITz/uBITz Platform Code/Dock/Schem/uBITz-Dock-Reference-Impl/04-Power-Module/uBITz-Dock-Power-Impl.kicad_pcb

## KiCad design uBITz Platform Code/Dock/Schem/uBITz-Dock-Reference-Impl/04-Power-Module/uBITz-Dock-Power-Impl.kicad_pcb (2025-12-24)

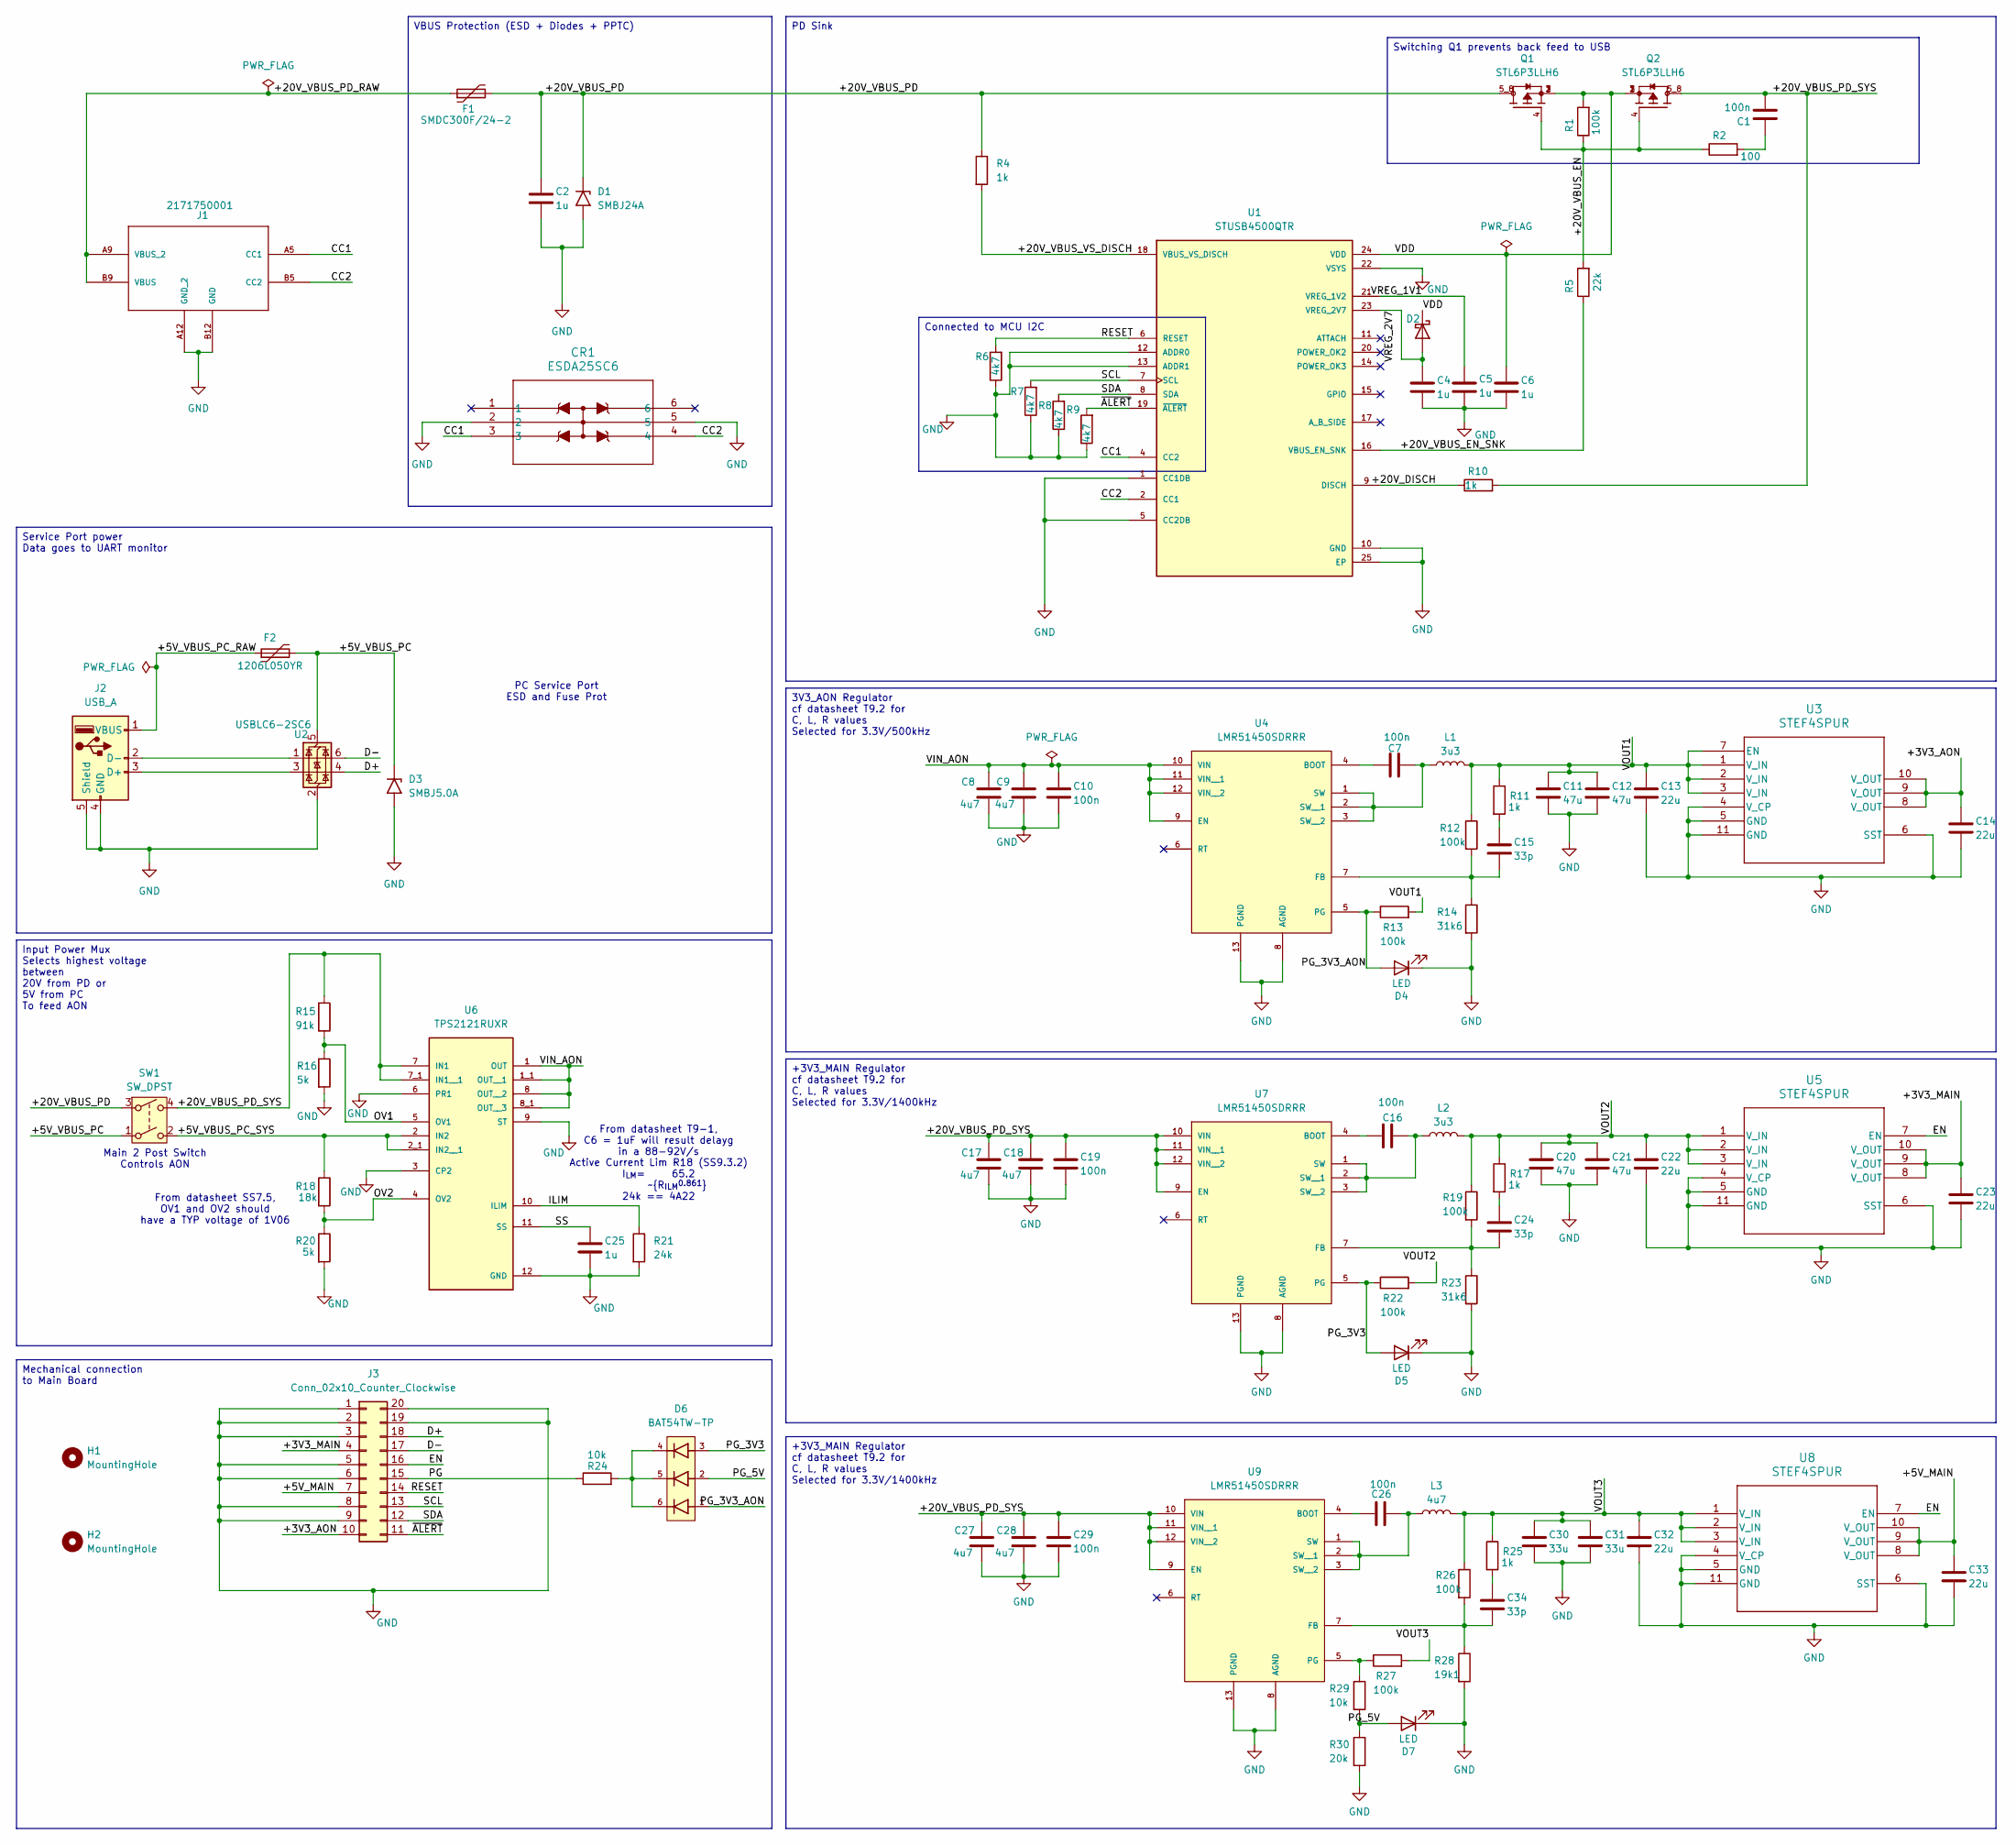
[picture p31: schematic uBITz-Dock-Power-Impl.kicad_sch, Dock Power Supply]

Parts:
C1, C7, C10, C16, C19, C26, C29: 100n; C_0603_1608Metric
C2: 1u; C_0402_1005Metric
C4, C5, C6, C25: 1u; C_0603_1608Metric
C8, C9, C17, C18, C27, C28: 4u7; C_0603_1608Metric
C11, C12, C20, C21: 47u; C_0603_1608Metric
C13, C14, C22, C23, C32, C33: 22u; C_0603_1608Metric
C15, C24, C34: 33p; C_0603_1608Metric
C30, C31: 33u; C_0603_1608Metric
CR1: ESDA25SC6; SOT23-6L_STM
D1: SMBJ24A; D_SMA_Handsoldering
D2: D_Schottky; D_SOD-323_HandSoldering
D3: SMBJ5.0A; D_SMB_Handsoldering
D4, D5, D7: LED; LED_0603_1608Metric
D6: BAT54TW-TP; SOP65P222X120-6N; PARTREV Rev.3
F1: SMDC300F/24-2; Fuse_2920_7451Metric_Pad2.10x5.45mm_HandSolder
F2: 1206L050YR; Fuse_1206_3216Metric
H1, H2: MountingHole; MountingHole_2.5mm
J1: 2171750001; 2171750001_MOL; MANUFACTURER_PART_NUMBER 2171750001
J2: USB_A; USB_A_Molex_67643_Horizontal
J3: Conn_02x10_Counter_Clockwise; PinHeader_2x10_P2.54mm_Vertical
L1, L2: 3u3; L_Bourns_SRP7028A_7.3x6.6mm; Part SRP7028A-3R3M
L3: 4u7; L_Bourns_SRP7028A_7.3x6.6mm
Q1, Q2: STL6P3LLH6; TRANS_STL6P3LLH6; PARTREV 4
R1, R12, R13, R19, R22, R26, R27: 100k; R_0603_1608Metric
R2: 100; R_0603_1608Metric
R4, R10, R11, R17, R25: 1k; R_0603_1608Metric
R5: 22k; R_0603_1608Metric
R6, R7, R8, R9: 4k7; R_0603_1608Metric
R14, R23: 31k6; R_0603_1608Metric
R15: 91k; R_0603_1608Metric
R16, R20: 5k; R_0603_1608Metric
R18: 18k; R_0603_1608Metric
R21: 24k; D_0603_1608Metric
R24, R29: 10k; R_0603_1608Metric
R28: 19k1; R_0603_1608Metric
R30: 20k; R_0603_1608Metric
SW1: SW_DPST; Molex_KK-254_AE-6410-04A_1x04_P2.54mm_Vertical; Part# 0022272041
U1: STUSB4500QTR; QFN50P400X400X90-25N; PARTREV 2
U2: USBLC6-2SC6; SOT-23-6
U3, U5, U8: STEF4SPUR; DFN_4SPUR_STM-L
U4, U7, U9: LMR51450SDRRR; CONV_LMR51450SDRRR; PARTREV December 2022
U6: TPS2121RUXR; IC_TPS2121RUXR

Connections:
/+3V3_AON: C14.1, J3.10, U3.8 (V_OUT), U3.9 (V_OUT), U3.10 (V_OUT)
/+3V3_MAIN: C23.1, J3.4, U5.8 (V_OUT), U5.9 (V_OUT), U5.10 (V_OUT)
/+5V_MAIN: C33.1, J3.7, U8.8 (V_OUT), U8.9 (V_OUT), U8.10 (V_OUT)
/+5V_VBUS_PC: D3.1 (A1), F2.2, SW1.1, U2.5 (VBUS)
/+5V_VBUS_PC_RAW: F2.1, J2.1 (VBUS)
/+5V_VBUS_PC_SYS: R18.1, SW1.2, U6.2 (IN2), U6.2_1 (IN2__1)
/+20V_DISCH: R10.1, U1.9 (DISCH)
/+20V_VBUS_EN: Q1.4, Q2.4, R1.1, R2.1, R5.2
/+20V_VBUS_EN_SNK: R5.1, U1.16 (VBUS_EN_SNK)
/+20V_VBUS_PD: C2.1, D1.1 (A1), F1.2, Q1.5_8, R4.1, SW1.3
/+20V_VBUS_PD_RAW: F1.1, J1.A9 (VBUS_2), J1.B9 (VBUS)
/+20V_VBUS_PD_SYS: C1.2, C17.1, C18.1, C19.1, C27.1, C28.1, C29.1, Q2.5_8, R10.2, R15.1, SW1.4, U6.7 (IN1), U6.7_1 (IN1__1), U7.9 (EN), U7.10 (VIN), U7.11 (VIN__1), U7.12 (VIN__2), U9.9 (EN), U9.10 (VIN), U9.11 (VIN__1), U9.12 (VIN__2)
/+20V_VBUS_VS_DISCH: R4.2, U1.18 (VBUS_VS_DISCH)
/CC1: CR1.3, J1.A5 (CC1), U1.4 (CC2)
/CC2: CR1.4, J1.B5 (CC2), U1.2 (CC1)
/D+: J3.18, U2.4 (I/O2)
/D-: J3.17, U2.6 (I/O1)
/EN: J3.16, U5.7 (EN), U8.7 (EN)
/ILIM: R21.1, U6.10 (ILIM)
/OV1: R15.2, R16.1, U6.5 (OV1)
/OV2: R18.2, R20.1, U6.4 (OV2)
/PG: J3.15, R24.1
/PG_3V3: D5.2 (A), D6.3, R22.1, U7.5 (PG)
/PG_3V3_AON: D4.2 (A), D6.1, R13.1, U4.5 (PG)
/PG_5V: D6.2, D7.2 (A), R29.2, R30.1
/RESET: J3.14, R6.2, U1.6 (RESET)
/SCL: J3.13, R7.2, U1.7 (SCL)
/SDA: J3.12, R8.2, U1.8 (SDA)
/SS: C25.1, U6.11 (SS)
/VDD: C6.1, D2.1 (K), Q1.1, Q1.2, Q1.3, Q2.1, Q2.2, Q2.3, R1.2, U1.24 (VDD)
/VIN_AON: C8.1, C9.1, C10.1, U4.9 (EN), U4.10 (VIN), U4.11 (VIN__1), U4.12 (VIN__2), U6.1 (OUT), U6.1_1 (OUT__1), U6.8 (OUT__2), U6.8_1 (OUT__3)
/VOUT1: C11.1, C12.1, C13.1, L1.2, R11.1, R12.1, R13.2, U3.1 (V_IN), U3.2 (V_IN), U3.3 (V_IN), U3.7 (EN)
/VOUT2: C20.1, C21.1, C22.1, L2.2, R17.1, R19.1, R22.2, U5.1 (V_IN), U5.2 (V_IN), U5.3 (V_IN)
/VOUT3: C30.1, C31.1, C32.1, L3.2, R25.1, R26.1, R27.2, U8.1 (V_IN), U8.2 (V_IN), U8.3 (V_IN)
/VREG_1V1: C5.1, U1.21 (VREG_1V2)
/VREG_2V7: C4.1, D2.2 (A), U1.23 (VREG_2V7)
/~ALERT: J3.11, R9.2, U1.19 (~ALERT)
GND: C2.2, C4.2, C5.2, C6.2, C8.2, C9.2, C10.2, C11.2, C12.2, C13.2, C14.2, C17.2, C18.2, C19.2, C20.2, C21.2, C22.2, C23.2, C25.2, C27.2, C28.2, C29.2, C30.2, C31.2, C32.2, C33.2, CR1.2, CR1.5, D1.2 (A2), D3.2 (A2), D4.1 (K), D5.1 (K), D7.1 (K), J1.A12 (GND_2), J1.B12 (GND), J2.4 (GND), J2.5 (Shield), J3.1, J3.2, J3.3, J3.5, J3.6, J3.8, J3.9, J3.19, J3.20, R6.1, R7.1, R8.1, R9.1, R14.2, R16.2, R20.2, R21.2, R23.2, R28.2, R30.2, U1.1 (CC1DB), U1.5 (CC2DB), U1.10 (GND), U1.12 (ADDR0), U1.13 (ADDR1), U1.22 (VSYS), U1.25 (EP), U2.2 (GND), U3.4 (V_CP), U3.5 (GND), U3.6 (SST), U3.11 (GND), U4.8 (AGND), U4.13 (PGND), U5.4 (V_CP), U5.5 (GND), U5.6 (SST), U5.11 (GND), U6.3 (CP2), U6.6 (PR1), U6.9 (ST), U6.12 (GND), U7.8 (AGND), U7.13 (PGND), U8.4 (V_CP), U8.5 (GND), U8.6 (SST), U8.11 (GND), U9.8 (AGND), U9.13 (PGND)
unnamed: C1.1, R2.2
unnamed: C15.1, R11.2
unnamed: C24.1, R17.2
unnamed: C34.1, R25.2
unnamed: D6.4, D6.5, D6.6, R24.2
unnamed: J2.3 (D+), U2.3 (I/O2)
unnamed: J2.2 (D-), U2.1 (I/O1)
unnamed: C7.2, U4.4 (BOOT)
unnamed: C15.2, R12.2, R14.1, U4.7 (FB)
unnamed: C7.1, L1.1, U4.1 (SW), U4.2 (SW__1), U4.3 (SW__2)
unnamed: C16.2, U7.4 (BOOT)
unnamed: C24.2, R19.2, R23.1, U7.7 (FB)
unnamed: C16.1, L2.1, U7.1 (SW), U7.2 (SW__1), U7.3 (SW__2)
unnamed: C26.2, U9.4 (BOOT)
unnamed: C34.2, R26.2, R28.1, U9.7 (FB)
unnamed: R27.1, R29.1, U9.5 (PG)
unnamed: C26.1, L3.1, U9.1 (SW), U9.2 (SW__1), U9.3 (SW__2)

Notes on the sheet:
Active Current Lim R18 (SS9.3.2) I_{LM}= 65.2 ~{R_{ILM}^{0.861}} 24k == 4A22
Main 2 Post Switch Controls AON
From datasheet T9-1, C6 = 1uF will result delayg in a 88-92V/s
From datasheet SS7.5, OV1 and OV2 should have a TYP voltage of 1V06
PC Service Port ESD and Fuse Prot
Service Port power Data goes to UART monitor
3V3_AON Regulator cf datasheet T9.2 for C, L, R values Selected for 3.3V/500kHz
Switching Q1 prevents back feed to USB
Input Power Mux Selects highest voltage between 20V from PD or 5V from PC To feed AON
+3V3_MAIN Regulator cf datasheet T9.2 for C, L, R values Selected for 3.3V/1400kHz
Mechanical connection to Main Board
PD Sink
Connected to MCU I2C
VBUS Protection (ESD + Diodes + PPTC)

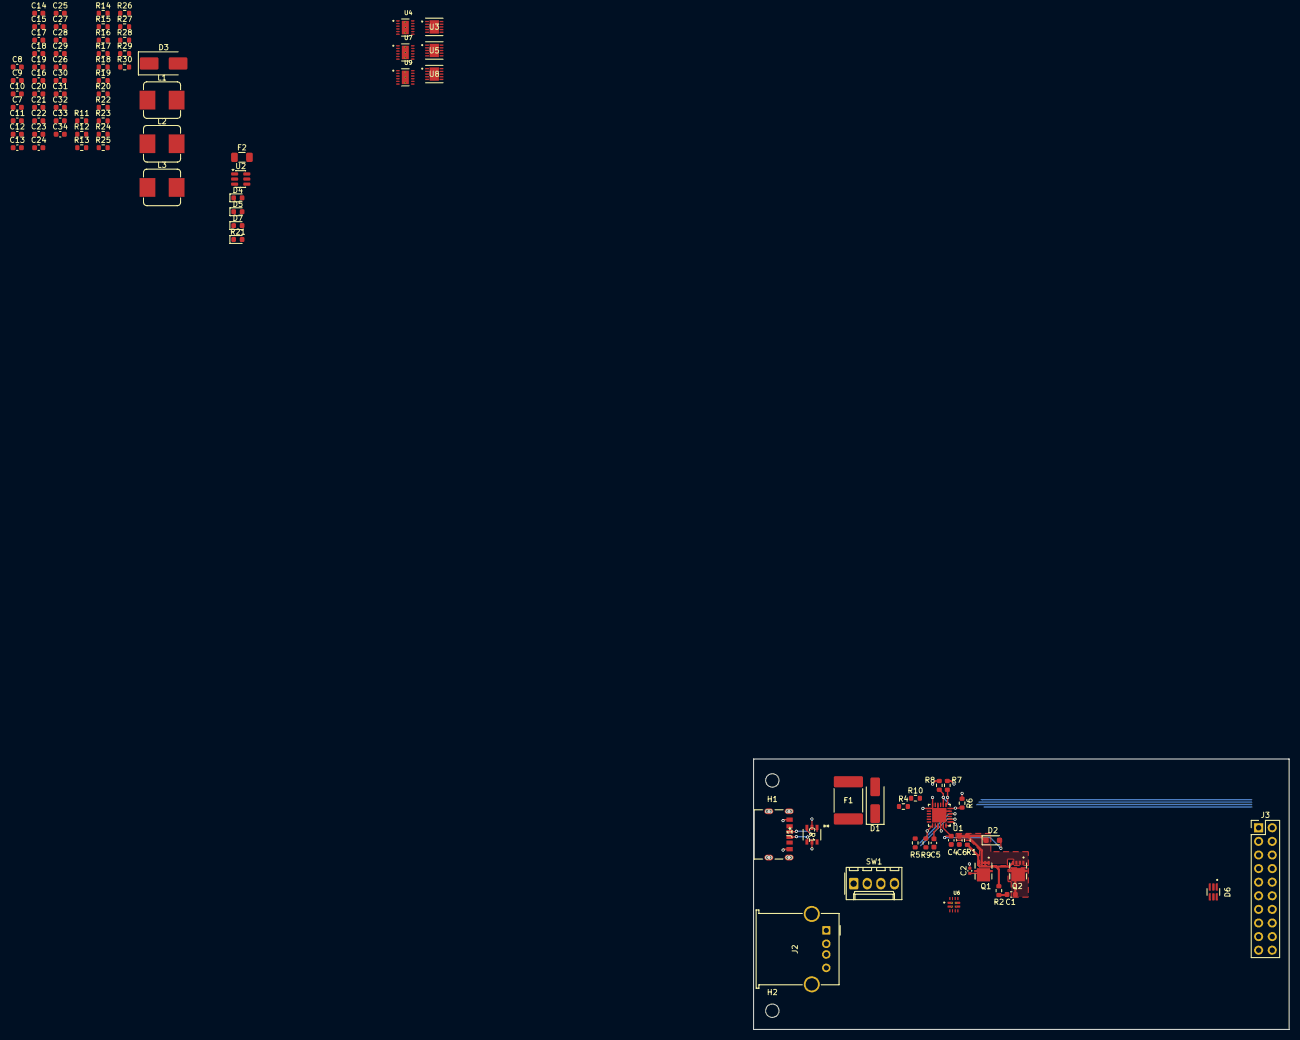
[picture p32: board uBITz-Dock-Power-Impl.kicad_pcb from above]

Board: 4 copper layers, 100.0 x 50.5 mm, 92 parts (0 on the bottom side), 55 nets.
