dumaiss/uBITz/uBITz Platform Code/Dock/HDL/src/irq_router.v

// irq_router: Dock-side interrupt router with configurable slot→CPU mapping.
// - Supports NUM_SLOTS tiles, each with 2 maskable INT channels and 1 NMI.
// - Routes to up to 4 CPU INT pins and 2 CPU NMI pins (active-high internally).
// - Tracks exactly one active interrupt at a time; additional requests are
//   held in pending masks until the active request deasserts.
// - A single CPU ack pulse is forwarded to the owning slot as a one-cycle
//   slot_ack pulse; ack does not clear the active interrupt.
// - Configuration is through a simple MCU-driven config bus:
//     * Maskable INT routing entry at cfg_addr = slot * NUM_TILE_INT_CH + channel
//     * NMI routing entry at cfg_addr = NUM_SLOTS*NUM_TILE_INT_CH + slot
//     * Write cfg_wdata[7:0] with {enable, idx[3:0]} (others reserved = 0)
//     * Disabled entries (bit7=0) ignore the corresponding request.
// Walkthrough:
//   1) Config domain (cfg_clk): stores per-slot/per-channel routing entries
//      int_route_slot_ch[][] and nmi_route_slot[]; each byte = {enable, idx[3:0]}.
//   2) Pending masks reflect currently asserted, routed lines (tile_int_req/tile_nmi_req).
//      Unrouted sources are ignored. Pending updates are combinational.
//   3) Active selection: when idle, NMIs are preferred over INTs; picks lowest
//      slot/channel that is pending. Active is cleared when its line drops.
//   4) Outputs:
//      - cpu_int/cpu_nmi: assert the routed CPU pin for the active source (if enabled and in range).
//      - slot_ack: pulse to the owning slot when irq_ack is seen for a maskable INT.
//      - irq_int_active/irq_int_slot: export active maskable INT (with routing enabled)
//        to steer Mode-2 vector fetches elsewhere in the Dock.
module irq_router #(
    parameter integer NUM_SLOTS        = 5,
    parameter integer NUM_CPU_INT      = 4,
    parameter integer NUM_CPU_NMI      = 2,
    parameter integer NUM_TILE_INT_CH  = 2,
    parameter integer CFG_ADDR_WIDTH   = 8,
	parameter integer SLOT_IDX_WIDTH  = (NUM_SLOTS <= 1) ? 1 : $clog2(NUM_SLOTS)
)(
    input  wire                         clk,
    input  wire                         rst_n,   // synchronous active-low reset
    input  wire                         cfg_clk, // config bus clock

    // Tile -> Dock interrupt request inputs (internal active-high levels)
    input  wire [NUM_SLOTS*NUM_TILE_INT_CH-1:0] tile_int_req, // maskable channels
    input  wire [NUM_SLOTS-1:0]                 tile_nmi_req, // non-maskable

    // CPU -> Dock acknowledge (decoded elsewhere)
    input  wire                         irq_ack,   // 1-clock-wide pulse = "CPU did an IRQ ack cycle"

    // CPU-side interrupt outputs (internal active-high)
    output reg  [NUM_CPU_INT-1:0]       cpu_int,   // to CPU INT pins
    output reg  [NUM_CPU_NMI-1:0]       cpu_nmi,   // to CPU NMI pins

    // Dock -> Tile per-slot acknowledge outputs (internal active-high)
    output reg  [NUM_SLOTS-1:0]         slot_ack,  // 1-clock pulse, per slot

    // Export active INT source
    output wire                        irq_int_active,
    output wire [SLOT_IDX_WIDTH-1:0]   irq_int_slot,

    // Simple config bus for routing/enable control
    input  wire                         cfg_wr_en,
    input  wire                         cfg_rd_en,
    input  wire [CFG_ADDR_WIDTH-1:0]    cfg_addr,
    input  wire [7:0]                   cfg_wdata
//    output reg  [31:0]                  cfg_rdata
);

    // Width needed to index NUM_SLOTS slots
    //localparam integer SLOT_IDX_WIDTH = (NUM_SLOTS <= 1) ? 1 : $clog2(NUM_SLOTS);
    localparam integer CH_IDX_WIDTH = (NUM_TILE_INT_CH <= 1) ? 1 : $clog2(NUM_TILE_INT_CH);

    // ------------------------------------------------------------------
    // Routing tables
    // ------------------------------------------------------------------
    // Maskable INT routing: enable + CPU INT index (bit4 = enable, [3:0] = idx)
    reg [4:0] int_route_slot_ch [0:NUM_SLOTS-1][0:NUM_TILE_INT_CH-1];
    // NMI routing: enable + CPU NMI index (bit4 = enable, [3:0] = idx)
    reg [4:0] nmi_route_slot [0:NUM_SLOTS-1];

    // ------------------------------------------------------------------
    // Active interrupt tracking
    // ------------------------------------------------------------------
    reg        active_valid;   // 1 when an interrupt is currently active
    reg        active_is_nmi;  // 1 = NMI, 0 = maskable INT
    reg [SLOT_IDX_WIDTH-1:0]  active_slot;    // slot owning the active source
    reg [CH_IDX_WIDTH-1:0]    active_ch;      // channel for maskable; 0 for NMI
    reg [4:0]  active_cpu_idx; // full route entry (bit4 = enable, [3:0] = index)

    // Derived view: only maskable, routed INTs count as "active" for vectoring
    wire active_int_routed = active_valid &&
                             !active_is_nmi &&
                             active_cpu_idx[4] &&                // route enabled
                             (active_slot < NUM_SLOTS);

    assign irq_int_active = active_int_routed;

    // When no active INT, drive slot index to 0; consumers should ignore it if irq_int_active=0.
    assign irq_int_slot = active_int_routed
                          ? active_slot[SLOT_IDX_WIDTH-1:0]
                          : {SLOT_IDX_WIDTH{1'b0}};

    // Pending sets
    reg [NUM_SLOTS*NUM_TILE_INT_CH-1:0] pending_int; // maskable pending (routed, level)
    reg [NUM_SLOTS-1:0]                 pending_nmi; // NMI pending (routed, level)

    // ------------------------------------------------------------------
    // Helpers
    // ------------------------------------------------------------------
    // Flattened index helper for maskable pending bits
    function automatic integer int_idx(input integer slot, input integer ch);
        begin
            int_idx = slot*NUM_TILE_INT_CH + ch;
        end
    endfunction

    // ------------------------------------------------------------------
    // Combinational next-state computation
    // ------------------------------------------------------------------
    reg [NUM_SLOTS*NUM_TILE_INT_CH-1:0] pending_int_next;
    reg [NUM_SLOTS-1:0]                 pending_nmi_next;
    reg        active_valid_next;
    reg        active_is_nmi_next;
    reg [SLOT_IDX_WIDTH-1:0]  active_slot_next;
    reg [CH_IDX_WIDTH-1:0]    active_ch_next;
    reg [4:0]  active_cpu_idx_next;

    integer s, c;
    reg [4:0] route_entry;

    always @* begin
        // Default next-state mirrors current
        pending_int_next    = pending_int;
        pending_nmi_next    = pending_nmi;
        active_valid_next   = active_valid;
        active_is_nmi_next  = active_is_nmi;
        active_slot_next    = active_slot;
        active_ch_next      = active_ch;
        active_cpu_idx_next = active_cpu_idx;

        // Pending = masked view of raw lines (no queuing)
        // - Only routed sources are considered
        // - If the line drops, pending drops too
        for (s = 0; s < NUM_SLOTS; s = s + 1) begin
            for (c = 0; c < NUM_TILE_INT_CH; c = c + 1) begin
                route_entry = int_route_slot_ch[s][c];

                if (route_entry[4]) begin
                    // Routed: follow current line level
                    pending_int_next[int_idx(s,c)] = tile_int_req[int_idx(s,c)];
                end else begin
                    // Unrouted: completely ignored
                    pending_int_next[int_idx(s,c)] = 1'b0;
                end
            end

            if (nmi_route_slot[s][4]) begin
                pending_nmi_next[s] = tile_nmi_req[s];
            end else begin
                pending_nmi_next[s] = 1'b0;
            end
        end

        // Clear active when the underlying request deasserts
        if (active_valid) begin
            if (active_is_nmi) begin
                if (!tile_nmi_req[active_slot]) begin
                    active_valid_next = 1'b0;
                end
            end else begin
                if (!tile_int_req[int_idx(active_slot, active_ch)]) begin
                    active_valid_next = 1'b0;
                end
            end
        end

        // Selection when idle
        if (!active_valid_next) begin
            // Candidate defaults
            active_valid_next   = 1'b0;
            active_is_nmi_next  = 1'b0;
            active_slot_next    = {SLOT_IDX_WIDTH{1'b0}};
            active_ch_next      = {CH_IDX_WIDTH{1'b0}};
            active_cpu_idx_next = 5'd0;

            // First, NMIs
            for (s = 0; s < NUM_SLOTS; s = s + 1) begin
                if (!active_valid_next && pending_nmi_next[s]) begin
                    route_entry = nmi_route_slot[s];
                    active_valid_next   = 1'b1;
                    active_is_nmi_next  = 1'b1;
                    active_slot_next    = s[SLOT_IDX_WIDTH-1:0];
                    active_ch_next      = {CH_IDX_WIDTH{1'b0}};
                    active_cpu_idx_next = route_entry;
                end
            end

            // Then maskable INTs
            if (!active_valid_next) begin
                for (s = 0; s < NUM_SLOTS; s = s + 1) begin
                    for (c = 0; c < NUM_TILE_INT_CH; c = c + 1) begin
                        if (!active_valid_next && pending_int_next[int_idx(s,c)]) begin
                            route_entry = int_route_slot_ch[s][c];
                            active_valid_next   = 1'b1;
                            active_is_nmi_next  = 1'b0;
                            active_slot_next    = s[SLOT_IDX_WIDTH-1:0];
                            active_ch_next      = c[CH_IDX_WIDTH-1:0];
                            active_cpu_idx_next = route_entry;
                        end
                    end
                end
            end
        end
    end

    // ------------------------------------------------------------------
    // Sequential state updates
    // ------------------------------------------------------------------
    always @(posedge clk) begin
        if (!rst_n) begin
            pending_int    <= {NUM_SLOTS*NUM_TILE_INT_CH{1'b0}};
            pending_nmi    <= {NUM_SLOTS{1'b0}};
            active_valid   <= 1'b0;
            active_is_nmi  <= 1'b0;
            active_slot    <= {SLOT_IDX_WIDTH{1'b0}};
            active_ch      <= {CH_IDX_WIDTH{1'b0}};
            active_cpu_idx <= 5'd0;
            //cfg_rdata      <= 32'h0000_0000;

        end else begin
            pending_int    <= pending_int_next;
            pending_nmi    <= pending_nmi_next;
            active_valid   <= active_valid_next;
            active_is_nmi  <= active_is_nmi_next;
            active_slot    <= active_slot_next;
            active_ch      <= active_ch_next;
            active_cpu_idx <= active_cpu_idx_next;
        end
    end

    // Config domain: route table access synchronized to cfg_clk
    always @(posedge cfg_clk or negedge rst_n) begin
        if (!rst_n) begin
            //cfg_rdata <= 32'h0000_0000;
            for (s = 0; s < NUM_SLOTS; s = s + 1) begin
                nmi_route_slot[s] <= 5'd0;
                for (c = 0; c < NUM_TILE_INT_CH; c = c + 1)
                    int_route_slot_ch[s][c] <= 5'd0;
            end
        end else begin
            //cfg_rdata <= 32'h0000_0000;
            // Config writes
            if (cfg_wr_en) begin
                integer idx;
                integer slot_sel;
                integer ch_sel;
                idx = cfg_addr;
                if (idx < (NUM_SLOTS*NUM_TILE_INT_CH)) begin
                    slot_sel = idx / NUM_TILE_INT_CH;
                    ch_sel   = idx % NUM_TILE_INT_CH;
                    int_route_slot_ch[slot_sel][ch_sel] <= {cfg_wdata[7], cfg_wdata[3:0]};
                end else if (idx < (NUM_SLOTS*NUM_TILE_INT_CH + NUM_SLOTS)) begin
                    slot_sel = idx - (NUM_SLOTS*NUM_TILE_INT_CH);
                    nmi_route_slot[slot_sel] <= {cfg_wdata[7], cfg_wdata[3:0]};
                end
            end
        end
    end

    // ------------------------------------------------------------------
    // Combinational outputs
    // ------------------------------------------------------------------
    always @* begin
        cpu_int = {NUM_CPU_INT{1'b0}};
        cpu_nmi = {NUM_CPU_NMI{1'b0}};

        if (active_valid && !active_is_nmi && active_cpu_idx[4]) begin
            if (active_cpu_idx[3:0] < NUM_CPU_INT)
                cpu_int[active_cpu_idx[3:0]] = 1'b1;
        end

        if (active_valid && active_is_nmi && active_cpu_idx[4]) begin
            if (active_cpu_idx[3:0] < NUM_CPU_NMI)
                cpu_nmi[active_cpu_idx[3:0]] = 1'b1;
        end
    end

    always @* begin
        slot_ack = {NUM_SLOTS{1'b0}};
        if (irq_ack && active_valid && !active_is_nmi) begin
            if (active_slot < NUM_SLOTS)
                slot_ack[active_slot] = 1'b1;
        end
    end

endmodule
