dumaiss/uBITz/(commit log)

2025-10-31 Add Solderpad Hardware License v2.1
    Added Solderpad Hardware License v2.1 to the project.
2025-10-31 Add μBITz trademarks policy document
    This document outlines the trademarks policy for μBITz, including acceptable and unacceptable uses of the trademarks, ownership details, and logo usage rules.
2025-11-18 Update 3.0- μBITz Bank Specification.md
2025-11-21 First commit of the Dock module before interrupt handling
2025-11-22 feat: handle mode-2 vector fetch
    [ice40Pinout.csv]
2025-11-22 docs: document addr_decoder wiring
2025-11-22 docs: document irq router flow
2025-11-24 Move all HDL source files into HDL subdirectory
    [ice40Pinout.csv]
2025-11-27 274bitz_dock_power_system_architecture_2025_11_26 added
    [ESP32-Pin-Allocation.xlsx, partitions.csv, uBITz-Dock-Reference-Impl.kicad_pcb, uBITz-Dock-Reference-Impl.kicad_sch]
2025-11-29 correcting issues with multiple assignments in synthesis
    correcting issues with multiple assignments in synthesis
    [MachXO2144-PinTQFPPackageMigrationFile.CSV]
2025-11-29 clean up some changes that were not supposed to be committed
    [MachXO2144-PinTQFPPackageMigrationFile.CSV]
2025-11-30 Package for iCE40 HK FPGA
    [ice40Pinout-tq144.csv]
2025-11-30 Fix issue with test suite
    [addr_decoder_cfg.v, addr_decoder_complex_tb.v, addr_decoder_tb.v, addr_decoder_worked_example_tb.v, top_integration_tb.v]
2025-12-24 Host and Dock first commit along with all the symbols, datasheets and footprints
    [2171750001.step, 2345986-1.step, 24LC16BT-I_SN.step, ACH-14.31818MHZ-EK.step, BAT54TW-TP.step, ECS-2033-120-BN.step, ECS-3951M-120-B-TR.step, LMR14050SSQDDARQ1.step]
2025-12-24 Reserved DMA pins
2025-12-29 Removed the Serial Profile and first commit of the a Host
    [uBITz-Dock-Reference-Impl.kicad_pcb, uBITz-Dock-Reference-Impl.kicad_sch, uBITz-Host-z80-Host.kicad_pcb, uBITz-Host-z80-Host.kicad_sch]
2026-01-03 Committing the first fully completed version of the Z80 based host
    [FT232HL-REEL.step, uBITz-Host-z80-Host.kicad_pcb, uBITz-Host-z80-Host.kicad_sch]
2026-01-03 Added the ability to tri-state the MEM0_CS and MEM1_CS signals to allow the Dock to take over memory type selection based on addresses
    [SN74LVC2G126DCUR.step, uBITz-Host-z80-Host.kicad_pcb, uBITz-Host-z80-Host.kicad_sch]
2026-01-03 Added 6309 based host Cleaned up pins assignent on edge connector Made /READY signal time bound
    [uBITz-Host-6309-Host.kicad_pcb, uBITz-Host-6309-Host.kicad_sch]
2026-01-04 Modified Pinout for easier layout Moved processing of MEM0_CS and MEM1_CS to Dock, no longer needed on Host
    [uBITz-Host-z80-Host.kicad_pcb, uBITz-Host-z80-Host.kicad_sch]
2026-01-04 Rearranged the edge connector pins
2026-01-04 Fixed a couple of inconsistencies with memory decoding
2026-01-04 Updated the Dock signaling voltage section and buffering
2026-01-04 Forgot the pin names
2026-01-05 Added a Z80 host without mapper nor programmer Moved 6309 directory
    Added instructions about floating pins
    [uBITz-Host-6309-Host.kicad_pcb, uBITz-Host-6309-Host.kicad_sch, uBITz-Host-z80-Host-No-Mapper.kicad_pcb, uBITz-Host-z80-Host-No-Mapper.kicad_sch]
2026-01-05 missing updates
    [uBITz-Host-z80-Host-No-Mapper.kicad_sch]
2026-01-05 Corrected Bus width (19-bits from 20-bits) and corrected mapper wiring, which needs to be able to re-write bits A13-A15
    [uBITz-Host-z80-Host-No-Mapper.kicad_pcb, uBITz-Host-z80-Host-No-Mapper.kicad_sch]
2026-01-05 Corrected for bus width (20 -> 19) and allowd mapper to rewrite bits A13-A15 of the address bus (become PA13-PA15)
    [uBITz-Host-6309-Host.kicad_pcb, uBITz-Host-6309-Host.kicad_sch]
2026-01-05 Beautify board and schematic Added PDF
    [uBITz-Host-6309-Host.kicad_pcb, uBITz-Host-6309-Host.kicad_sch]
2026-01-05 Removed transceivers from Z80 host with the mapper and cleaned up schematics
    [uBITz-Host-6309-Host.kicad_pcb, uBITz-Host-z80-Host-No-Mapper.kicad_pcb, uBITz-Host-z80-Host-No-Mapper.kicad_sch, uBITz-Host-z80-Host.kicad_pcb, uBITz-Host-z80-Host.kicad_sch]
2026-01-05 Added Programmer board
    [USB-JTAG-Programmer.kicad_pcb, USB-JTAG-Programmer.kicad_sch]
2026-01-09 Adding the first Bank ref impl
    [2171750001.step, 2345986-1.step, 24LC16BT-I_SN.step, ACH-14.31818MHZ-EK.step, AT28C256-15PU.step, DB0020A.stp, ECS-2033-120-BN.step, ECS-3951M-120-B-TR.step]
